jonahsaunders/fab-computer-hackerfab/daughterboards/micromanipulator/docs/schematics/README.txt

Current single-RP2350B schematic: page-1.png through page-7.png and the seven matching SVGs.
Page 1 contains only connectors and hierarchy. Page 7 is USB protection, CC termination and VBUS sensing.
The complete PDF is ../schematic-review.pdf.
