jonahsaunders/fab-computer-hackerfab/docs/provenance.md

# Source provenance

## Supplied inputs

The initial repository import was prepared on 2026-10-21 from:

- `Backplane.zip`: the `Backplane/HackerfabBackplane/` KiCad project.
- `LibraryHackerfab.zip`: custom symbols and footprint libraries under `LibraryHackerfab/`.
- *Hackerfab Progress Report 1 - FAB Computer.pdf*: background only, including Jonah Saunders' modular backplane/nanopositioner section and Jacob Rohozen's fab computer/sputtering section. The PDF is not redistributed in this repository.

The report describes early requirements and plans. The supplied KiCad files are the source for the repository's hardware inventory and validation baseline; the report's milestone statuses are not presented as current test results.

## 2026-11-10 layout update

Imported the supplied `HackerfabBackplane.kicad_pcb` with line endings normalized for Git. The layout moves L1/L2, D2/D4, C7/C14, and TP1–TP4 and revises copper in the two buck regulator sections. The saved copper fills are from the supplied board. The schematics, connector net assignments, and project rules match the preceding revision.

The board, plug-in assembly, and enclosure images were regenerated from the imported layout. See the [validation results](validation.md).

## 2026-11-05 source update

Imported ten active backplane files and 31 library files. Six active files differ from the preceding import: the PCB, project settings, root schematic, microcontroller schematic, `Hack_Connector.kicad_sym`, and `Hack_Passives.kicad_sym`.

The source adds four 0402 2.2 kΩ I²C pullups (R58–R61), replaces the four mounting holes with grounded `MountingHole_3.2mm_M3_Pad_Via` footprints, and changes J3:C19 from AUX10 to NC. The libraries add the mounting-hole symbol and 0402/0603 2.2 kΩ resistor symbols. The 24 custom footprints and custom rules are unchanged.

All 41 active design, library, and rule files match the supplied archives after line-ending normalization. Portable project library tables are retained. Copper fills, silkscreen, component metadata, circuitry, and routing are preserved as supplied. Nested Git history, backups, personal settings, and locks are omitted. Previews and the connector reference reflect the imported source.

| Input | SHA-256 |
| --- | --- |
| `Backplane.zip` | `2d32265ba806e5d6636d25c03d4a8b0cd8cbffeaa7c4cb9ce4a664522a3b36a8` |
| `LibraryHackerfab.zip` | `0b754c95f27298f834ec86778abce35e29a8b25181f3447bfe1e8e4ebcddac7e` |

## Previous 2026-11-04 source update

Imported ten active backplane files and 31 library files. Four active files differ from the preceding import: the PCB, project settings, root schematic, and microcontroller schematic. The source adds R56/R57 and J2's second UART on GPIO36/37. The library archive, all 24 custom footprints, and custom rules match the prior import.

All 41 active design, library, and rule files match the supplied archives after line-ending normalization. Portable project library tables are retained. Copper fills, silkscreen, component metadata, circuitry, and routing are preserved as supplied. The original archives are unchanged; nested Git history, backups, personal settings, and locks are omitted.

The design has 148 components/footprints, 1,114 trace segments, and 267 vias. KiCad reports 15 ERC findings, 24 DRC errors and 362 warnings, zero unconnected items, and zero schematic/PCB parity findings under the supplied rule settings. See [validation](validation.md).

| Input | SHA-256 |
| --- | --- |
| `Backplane.zip` | `cb59fc6ec95b371b803b05d918c9ad8e5f0ef8e0f59441e223abf39139629a5e` |
| `LibraryHackerfab.zip` | `f6dfa80bfdfb0d18f47f1acee41ef86ccdb3116fa3f484c1b2f465cdcedf7cc0` |

## Previous 2026-11-02 source update (RP2350B and supporting circuitry)

The supplied archives were imported into the existing locations: ten backplane design/rule files and 31 custom-library files. Seven active files differ from the preceding import after line-ending normalization: the PCB, project settings, microcontroller sheet, 12 V and 5 V buck-regulator sheets, `Hack_Chips.kicad_sym`, and `Hack_Passives.kicad_sym`.

The design changes U5 from RP2354B to RP2350B and adds C42 (4.7 µF, 16 V) and R55 (33 Ω). Both buck-regulator enable pins are now marked as no-connects in the supplied schematics. The chip library adds RP2350B; the passive library adds CL05A475MO5NUNC and RC0402JR-0733RP. The PCB updates placement, routing, and copper geometry. Project settings update the used-designator inventory. The other four schematic sheets, custom rules, five other symbol libraries, and all 24 custom footprints are unchanged.

All 41 active design/library/rule files match the supplied archives after line-ending normalization, including after validation and export. The repository retains its portable project library tables. No electrical, footprint, routing, or rule edits were made during import. Local history, nested Git databases, backups, personal settings, and locks are omitted.

The supplied board has 146 footprints, matching 146 schematic components, with 1,073 track segments and 263 vias. KiCad 10.0.6 reports 15 ERC findings (9 errors, 6 warnings), 350 DRC warnings with zero errors, zero unconnected items, and zero schematic/PCB parity findings. All 288 connector contacts still match V6 and the schematic netlist. The board image, seven schematic previews, and current documentation are refreshed; see [validation](validation.md) for the detailed comparison.

| Input | SHA-256 |
| --- | --- |
| `Backplane.zip` | `42994611f4c483442b37bc6466591b8f626c0dd15f32b7143f6bf670e60dd27b` |
| `LibraryHackerfab.zip` | `f6dfa80bfdfb0d18f47f1acee41ef86ccdb3116fa3f484c1b2f465cdcedf7cc0` |

## Previous 2026-11-02 source update (routing and vias)

The later supplied archives were imported into the existing locations: ten backplane design/rule files and 31 custom-library files. Only the PCB and project settings differ from the earlier November 2 import after line-ending normalization. The PCB updates routing, vias, copper geometry, and three silkscreen reference positions. The project changes its default pad connection from thermal relief on through-hole pads to thermal relief on all pads, and its default thermal gap from 0.40 mm to 0.20 mm. The seven schematics, custom rules, and all shared libraries are unchanged. The library ZIP is byte-for-byte identical to the previous library archive.

All 41 active design/library/rule files match the supplied archives after line-ending normalization, including after validation and export. The repository retains its portable project library tables. No circuit, footprint, routing, or rule edits were made during import. Local history, nested Git databases, backups, personal settings, and locks are omitted.

The supplied board has 1,062 track segments and 265 vias. KiCad 10.0.6 reports 16 ERC findings, 347 DRC warnings with zero errors, zero unconnected items, and zero schematic/PCB parity findings. The four dangling-via warnings and one silkscreen-overlap warning from the earlier November 2 import are no longer reported. All 288 connector contacts match V6 and the schematic netlist. The board image, seven schematic previews, and validation notes are refreshed. The earlier thermal-relief investigation is retained as a dated historical record.

| Input | SHA-256 |
| --- | --- |
| `Backplane.zip` | `803252028f3126698d68c80218893741e45e915588151332f2037253920d83d4` |
| `LibraryHackerfab.zip` | `22608c5caa803a6a3686a7baa2d7d8bc543e443ffc02595fb5ca283fdfc0c1fa` |

## Earlier 2026-11-02 source update (mounting holes and copper)

The supplied archives were imported into the existing locations: ten backplane design/rule files and 31 custom-library files. Only the PCB and project settings differ from the previous import after line-ending normalization. The PCB updates mounting-hole positions, copper geometry, and routing; the project changes its default pad connection to thermal relief for through-hole pads and its default thermal gap from 0.50 mm to 0.40 mm. The seven schematics, custom rules, and all shared libraries are unchanged. The library ZIP is byte-for-byte identical to the previous library archive.

All 41 active design/library/rule files match the supplied archives after line-ending normalization, including after validation and export. The repository retains its portable project library tables. No circuit, footprint, routing, or rule edits were made during import. Local history, nested Git databases, backups, personal settings, and locks are omitted.

The supplied board has 1,065 track segments and 248 vias. KiCad 10.0.6 reports 16 ERC findings, 352 DRC warnings with zero errors, zero unconnected items, and zero schematic/PCB parity findings. The previous 11 thermal-relief and four copper-edge-clearance errors are no longer reported. All 288 connector contacts match V6 and the schematic netlist. The board image, seven schematic previews, and validation notes are refreshed. The earlier thermal-relief investigation is retained as a dated historical record.

| Input | SHA-256 |
| --- | --- |
| `Backplane.zip` | `010dacdbf790cecba9f9229951a0e6a029dab3047fce349a967e0a4c266f812f` |
| `LibraryHackerfab.zip` | `22608c5caa803a6a3686a7baa2d7d8bc543e443ffc02595fb5ca283fdfc0c1fa` |

## Previous 2026-11-01 source update (mounting holes)

The latest supplied archives update the PCB and `MountingHole_3.2mm_M3_Grounded_Corner.kicad_mod`. The mounting-hole keepout now applies to F.Cu and B.Cu only, and the four board instances match the revised library footprint. Schematics, project settings, custom design rules, and other library files are unchanged after line-ending normalization. All 41 active design/library/rule files match the supplied archives after line-ending normalization; portable project library tables are retained.

The supplied board has 1,063 track segments and 248 vias. KiCad 10.0.6 reports 16 ERC findings, 368 DRC findings, zero unconnected items, and zero schematic/PCB parity findings. All 288 connector contacts match V6 and the schematic netlist. Previews and validation notes are refreshed. Local history, nested Git databases, backups, personal settings, and locks are omitted.

| Input | SHA-256 |
| --- | --- |
| `Backplane.zip` | `c4310f27035583245b53562eee915fbbe0ef82bcd50d26c63653c69d538759a9` |
| `LibraryHackerfab.zip` | `22608c5caa803a6a3686a7baa2d7d8bc543e443ffc02595fb5ca283fdfc0c1fa` |

The requested copper-pour investigation is documented in [thermal-relief findings](thermal-relief.md), including an illustration generated from the saved copper geometry. Temporary copies were used to test thermal-gap/spoke settings. Those experimental design changes are not included in the import.

## Previous 2026-11-01 source update (custom rules)

The later supplied archives were imported into the existing locations: ten backplane design files and 31 custom-library files. Compared with the earlier November 1 import, the PCB changes, the project adds net colors for `+1V1` and `+3V3`, and `HackerfabBackplane.kicad_dru` is new. The seven schematic sheets and all shared-library files are unchanged after line-ending normalization. All 41 active source files match the supplied archives after line-ending normalization; the repository retains its portable library tables. No circuit, footprint, routing, or custom-rule edits were made during import.

The board contains 1,052 track segments and 248 vias. All 288 connector pins still match V6 in the schematic and PCB. KiCad 10.0.6 reports 16 ERC findings, 376 DRC findings, four unconnected PCB items, and zero schematic/PCB parity findings. The supplied custom rules are included in this baseline, so the DRC totals are not a comparison under identical rules. See [validation](validation.md) for details. The board image and all seven schematic exports were refreshed.

| Input | SHA-256 |
| --- | --- |
| `Backplane.zip` | `d4eb044add0e31c59cb20894d9fb2f55f8f1f48e223b21bb211d692d945192b0` |
| `LibraryHackerfab.zip` | `db5c3d66d2a99bcd8b0e6b4c48f858e088cf05453cb7b19b771d245ed7039d63` |

The custom-rule header labels the supplied file as a JLCPCB 4-layer, 1 oz outer / 0.5 oz inner variant. Its references to a generator, capabilities file, and variants describe its original source; those supporting files were not included in the archives. The rule file is preserved as supplied, without independently certifying fabrication capabilities. Local history, nested Git databases, backups, personal settings, and editor locks are omitted.

## Earlier 2026-11-01 source update

The supplied archives were imported into the existing locations: nine backplane design files and 31 custom-library files. Only `HackerfabBackplane.kicad_pcb` differs from the October 30 import after line-ending normalization. The seven schematic sheets, project settings, and libraries are unchanged. All 40 active source files match the supplied archives after line-ending normalization; the repository retains its portable library tables. No circuit, footprint, or routing edits were made during import.

The PCB now contains 1,045 track segments and 248 vias. KiCad reports zero unconnected items and zero schematic/PCB parity findings. All 288 connector pins still match V6 in the schematic and PCB. The five previously documented GND-assigned AUX vias now carry their respective AUX nets. Refreshed previews and current ERC/DRC results accompany the import; see [validation](validation.md).

| Input | SHA-256 |
| --- | --- |
| `Backplane.zip` | `412bdff52870a83ee319ff3d8ce41d47b9beed17b7ab7627fabbfc21fc4bd579` |
| `LibraryHackerfab.zip` | `db5c3d66d2a99bcd8b0e6b4c48f858e088cf05453cb7b19b771d245ed7039d63` |

The backplane archive includes `.history/` and `.history_trim/` directories with nested Git databases. Both are omitted, along with backup files, personal settings, and editor locks.

## Previous 2026-10-30 source update

The corrected supplied archives were imported: nine backplane design files and 31 custom-library files. The root schematic and PCB implement the V6 pin order, with J1 nearest the MCU and UART only on J1. The libraries are unchanged from the October 29 archive. All 40 active source files match the archives after line-ending normalization; the repository retains its portable library tables. History, backups, personal settings, and lock files are omitted.

All 288 connector pad assignments were compared with V6 in the schematic and PCB. Updated schematic/board previews and current ERC/DRC results accompany the import; see [validation](validation.md). The PCB contains the author’s routing progress.

| Input | SHA-256 |
| --- | --- |
| `Backplane.zip` | `e90955123a6e66318d26df3ff379cbae10a63ccf3329a530b0bd17e33bcbb435` |
| `LibraryHackerfab.zip` | `db5c3d66d2a99bcd8b0e6b4c48f858e088cf05453cb7b19b771d245ed7039d63` |

## Previous 2026-10-29 source update

The supplied archives were imported into the existing repository locations: nine backplane design files and 31 library files (seven symbol libraries and 24 footprints). Compared with the previous import, the PCB, project, root schematic, and microcontroller sheet changed. The library update adds W25Q128JVSIQ flash-memory and DFE252012F-3R3M=P2 inductor symbols and their footprints, and revises the QFN-80 and Texas HSOP-8 footprints. The other active files match after line-ending normalization.

The repository's portable `fp-lib-table` and `sym-lib-table` were retained. The archive's footprint table still contains absolute desktop paths and an unused `Hack_Osicllators` entry. All 40 imported design and library files match the supplied active sources after line-ending normalization; no electrical or footprint changes were made during import. The supplied sources already contain the earlier fuse reference correction. Local history, backup files, personal settings, and editor lock files were omitted.

| Input | SHA-256 |
| --- | --- |
| `Backplane.zip` | `2831c1ed387e02acf5ddecc946eb71cafc70bb48188b46764c5f6404acc80a21` |
| `LibraryHackerfab.zip` | `db5c3d66d2a99bcd8b0e6b4c48f858e088cf05453cb7b19b771d245ed7039d63` |

All seven schematic previews and the board image were regenerated with KiCad 10.0.6. The design has 144 schematic components and 144 PCB footprints, with partial routing. See [validation](validation.md) for the current ERC/DRC results.

## Later 2026-10-26 source update

The latest supplied archives were imported into the same locations. The PCB, project, microcontroller sheet, 12 V and 5 V sheets, and passive symbol library changed. Other active source files match the previous import after line-ending normalization and the documented fuse reference correction. The portable library tables remain in place. The archives also contain local history, personal settings, and backup files, which are omitted as described below. The library archive contains another copy of the backplane; the dedicated backplane archive is the source for the project.

| Input | SHA-256 |
| --- | --- |
| `Backplane.zip` | `5d5989b9b181786cb4872330af4dc332807218ec35e0b4a389b25ffbf5ee654a` |
| `LibraryHackerfab.zip` | `67145490204cabcd166149f126d37eebc9a72dfa01b24410629074def56f428e` |

Previews and validation were regenerated with KiCad 10.0.6; see [validation](validation.md).

## Earlier 2026-10-26 source update

Replacement `Backplane.zip` and `LibraryHackerfab.zip` archives were supplied on 2026-10-26 and imported into the same repository locations. The update includes nine backplane design files (project, PCB, and seven schematic sheets) and 29 library files (seven symbol libraries and 22 footprints).

The root schematic and project now include `Protection.kicad_sch`; the libraries add protection components, connectors, and seven footprints. The PCB and the five pre-existing subsheets match the initial import after line-ending normalization.

The repository's portable `fp-lib-table` and `sym-lib-table` were retained. The replacement footprint table still contains absolute desktop paths and the unused `Hack_Osicllators` typo. The new fuse reference named an absent `Hack_Passives_Power` library, so it was corrected to `Hack_Passives:Fuse_Littelfuse-NANO2-451_453` in the library symbol and both cached/placed symbol properties in `Protection.kicad_sch`. The footprint itself was supplied in `Hack_Passives.pretty`. These reference corrections and line-ending normalization are the only changes to the imported design contents; circuit connections were preserved.

Schematic previews, the board image, and validation notes were refreshed with KiCad 10.0.6. The new schematic has 109 components, while the unchanged PCB has 93 footprints; see the [current validation results](validation.md).

## Import mapping

| Original location | Repository location |
| --- | --- |
| `Backplane/HackerfabBackplane/` | `hardware/backplane/` |
| `LibraryHackerfab/` | `hardware/libraries/` |

The initial 2026-10-21 import retained eight backplane design files (project, PCB, and six schematic sheets) and 22 library files (seven symbol libraries and 15 footprints). Source filenames, component identifiers, embedded models, and electrical connections were preserved. Git normalizes text line endings.

The original footprint table used absolute desktop paths. It was replaced with relative `${KIPRJMOD}/../libraries/` entries, and a matching project-local symbol table was added. An unused `Hack_Osicllators` typo entry was removed; references use the supplied `Hack_Oscillators` library.

## Omitted local state

- The backplane's `.history/` and `.history_trim/` directories, including their nested Git databases and save snapshots.
- The personal `.kicad_prl` settings file.
- Editor `.lck` files.
- Seven `.bak` library copies. Some differ from current library files; they remain available in the original archive rather than being treated as active source.

The original archives are unchanged. They are not committed as duplicate project copies. Generated schematic SVGs and the board PNG come directly from KiCad and can be refreshed using `scripts/export_design.py`.

## Archive fingerprints

SHA-256 identifies the exact supplied archives used for each import.

### Earlier update: 2026-10-26

| Input | SHA-256 |
| --- | --- |
| `Backplane.zip` | `cb402ce35c35c4ca89653b3e4fa78799b7c20a86cc4a859fcf68cb515b5bb651` |
| `LibraryHackerfab.zip` | `fae4f7f1eb39ee0c3e7f227d90205d20042f0cc822c55a51ffbe870fe86c5a20` |

### Initial import: 2026-10-21

| Input | SHA-256 |
| --- | --- |
| `Backplane.zip` | `98cf0ab542ad3de3d64e1f620149b67db82f9fa043ab19333f574d06d6231985` |
| `LibraryHackerfab.zip` | `9b7ce8772d420b50c1afcbc9ea5139d51ee581ea7fd56a7c9e4cf8f526473748` |
