jonahsaunders/fab-computer-hackerfab/daughterboards/micromanipulator/docs/connector-schematic.png

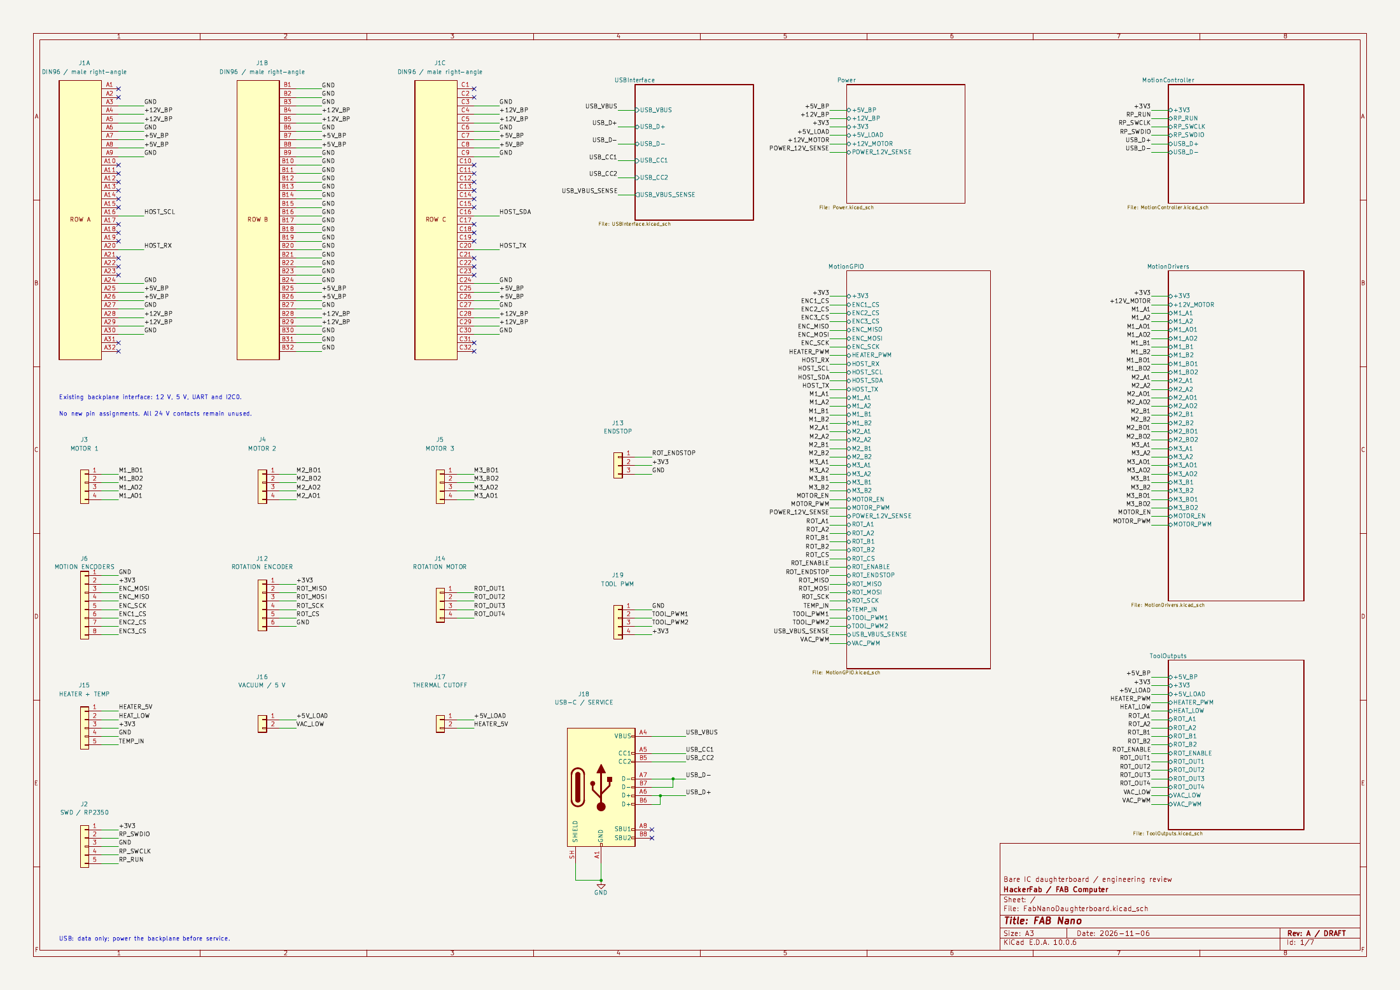
daughterboards/micromanipulator/docs/connector-schematic.png
