jonahsaunders/fab-computer-hackerfab/daughterboards/micromanipulator/docs/encoder-backplane-schematics/page-1.png

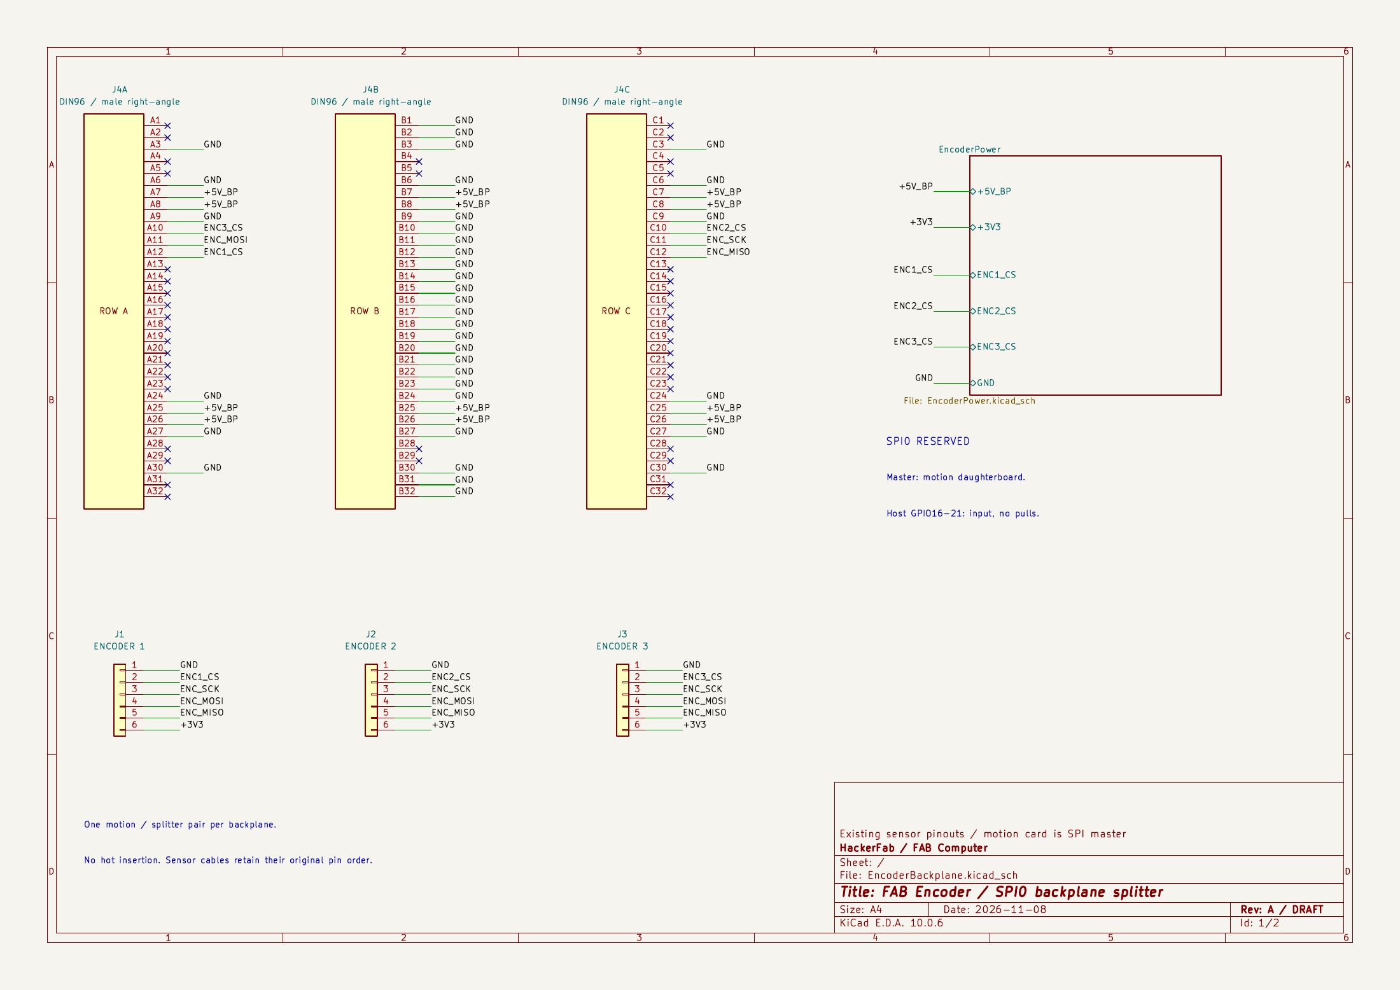
daughterboards/micromanipulator/docs/encoder-backplane-schematics/page-1.png
