jonahsaunders/fab-computer-hackerfab/daughterboards/micromanipulator/docs/encoder-backplane-schematics/page-2.png

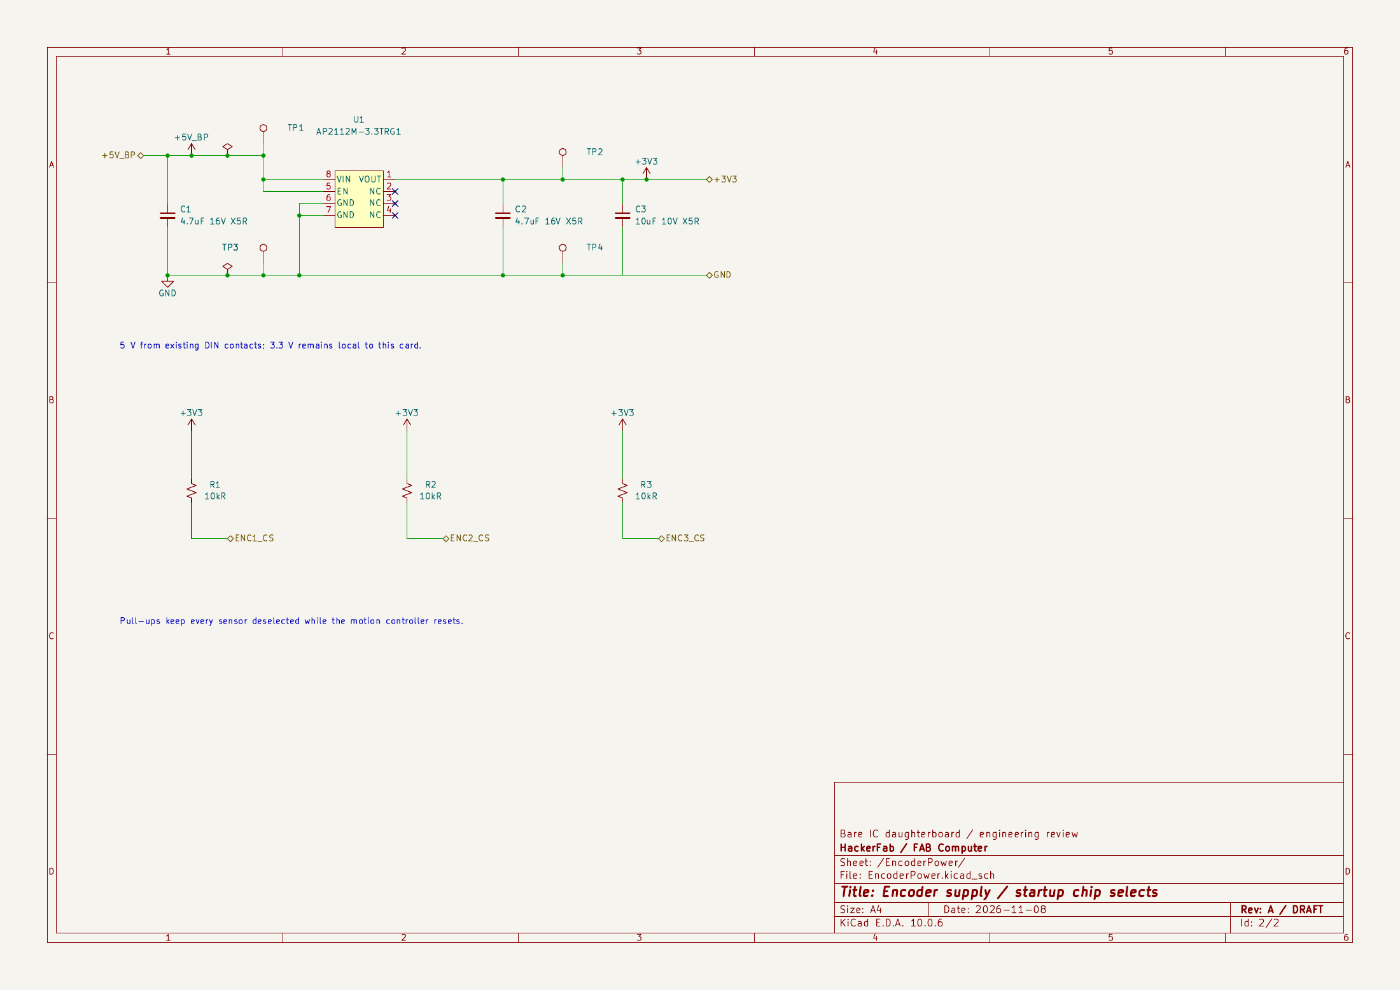
daughterboards/micromanipulator/docs/encoder-backplane-schematics/page-2.png
