jonahsaunders/fab-computer-hackerfab/daughterboards/micromanipulator/docs/encoder-splitter.png

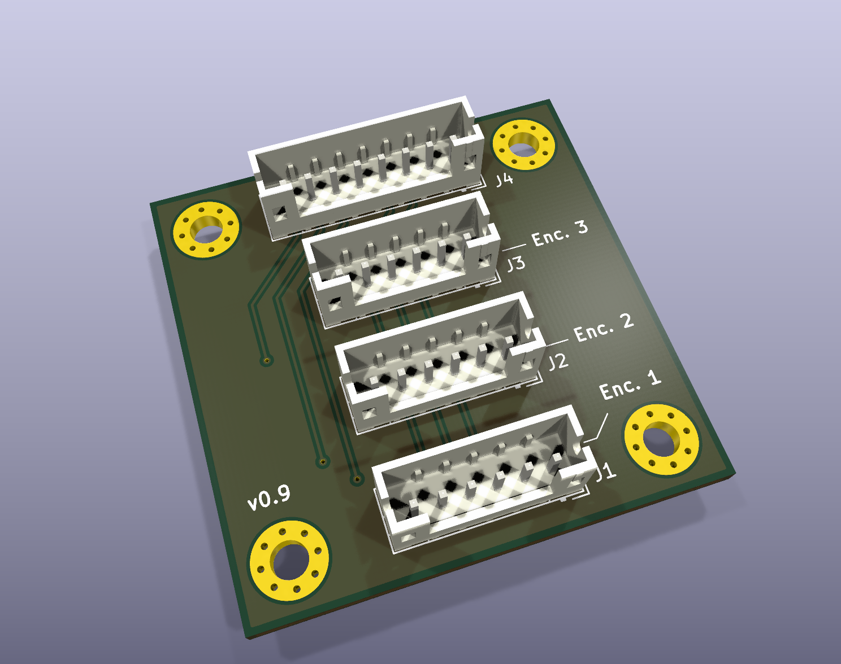
daughterboards/micromanipulator/docs/encoder-splitter.png
