jonahsaunders/fab-computer-hackerfab/daughterboards/micromanipulator/docs/layout-back-incomplete.png

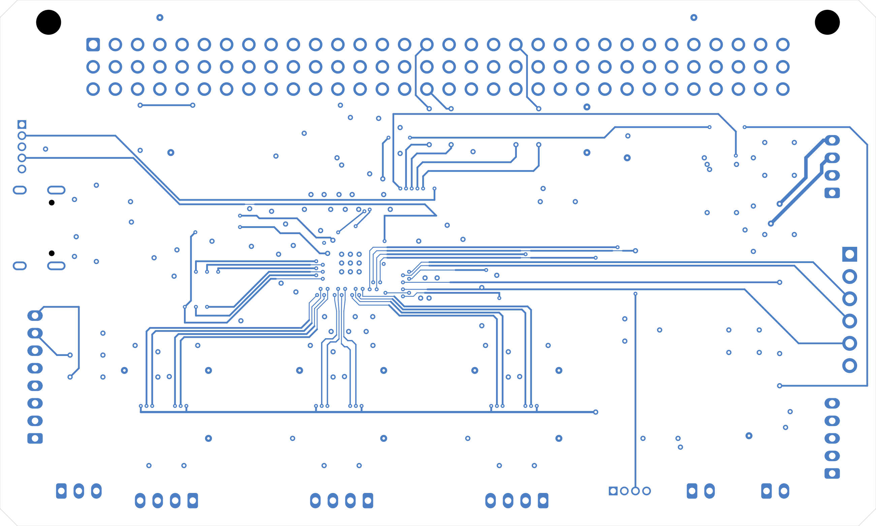
daughterboards/micromanipulator/docs/layout-back-incomplete.png
