jonahsaunders/fab-computer-hackerfab/daughterboards/micromanipulator/docs/layout-incomplete.png

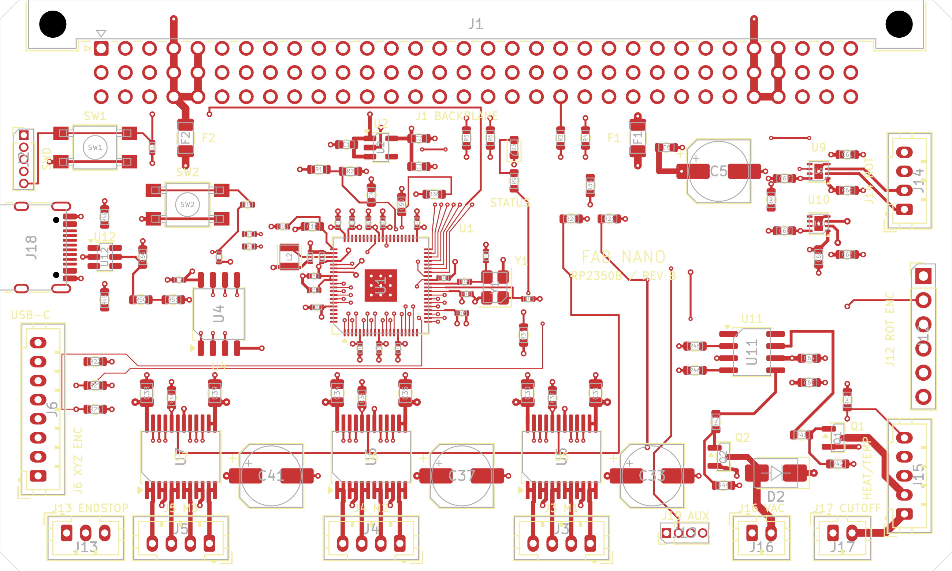
daughterboards/micromanipulator/docs/layout-incomplete.png
