jonahsaunders/fab-computer-hackerfab/daughterboards/micromanipulator/docs/schematics/page-1.png

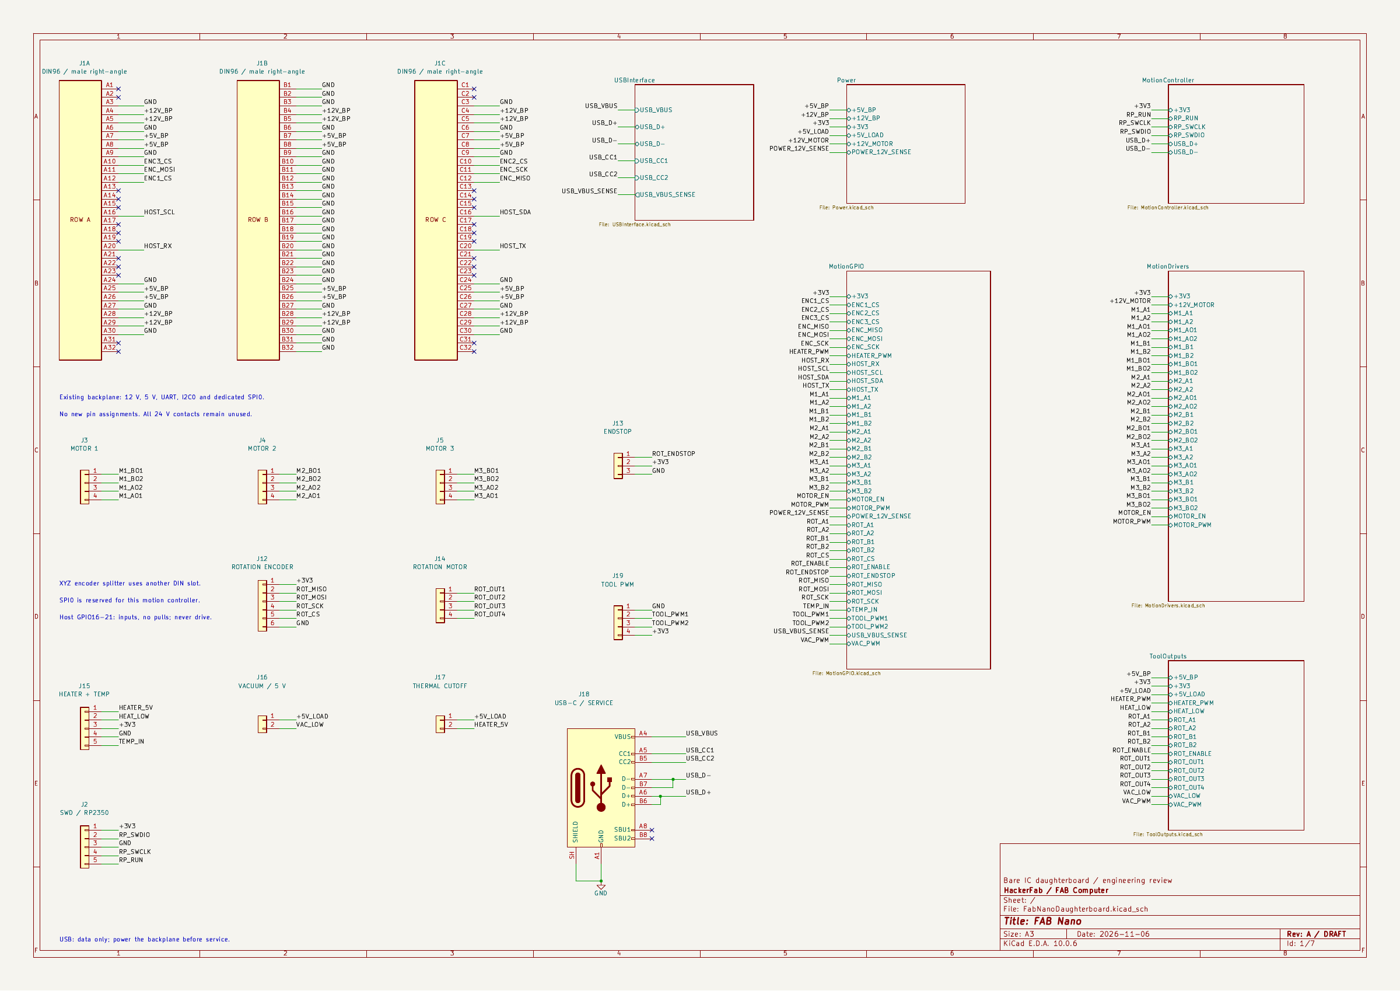
daughterboards/micromanipulator/docs/schematics/page-1.png
