jonahsaunders/fab-computer-hackerfab/daughterboards/micromanipulator/docs/schematics/page-2.png

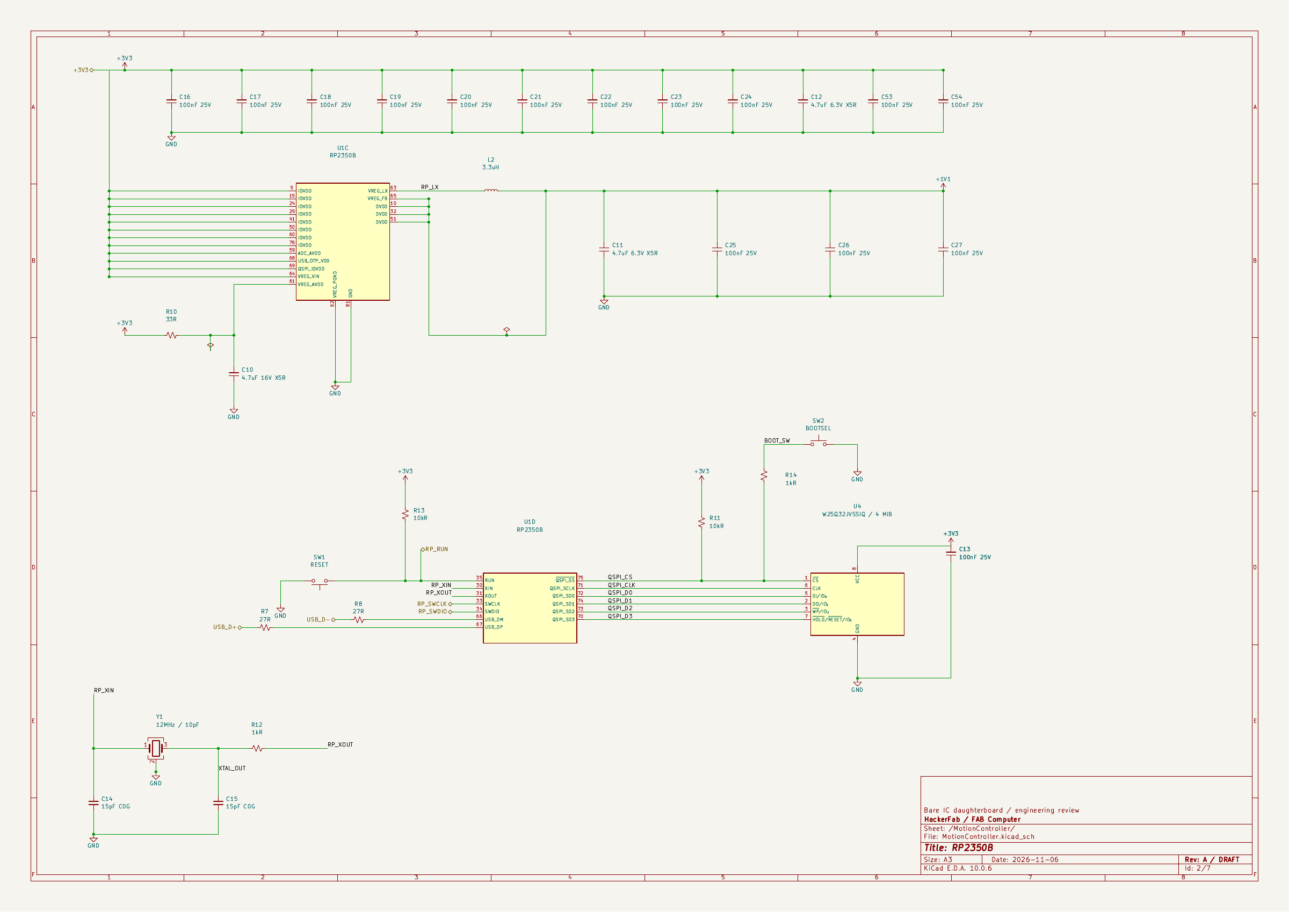
daughterboards/micromanipulator/docs/schematics/page-2.png
