jonahsaunders/fab-computer-hackerfab/daughterboards/micromanipulator/docs/schematics/page-3.png

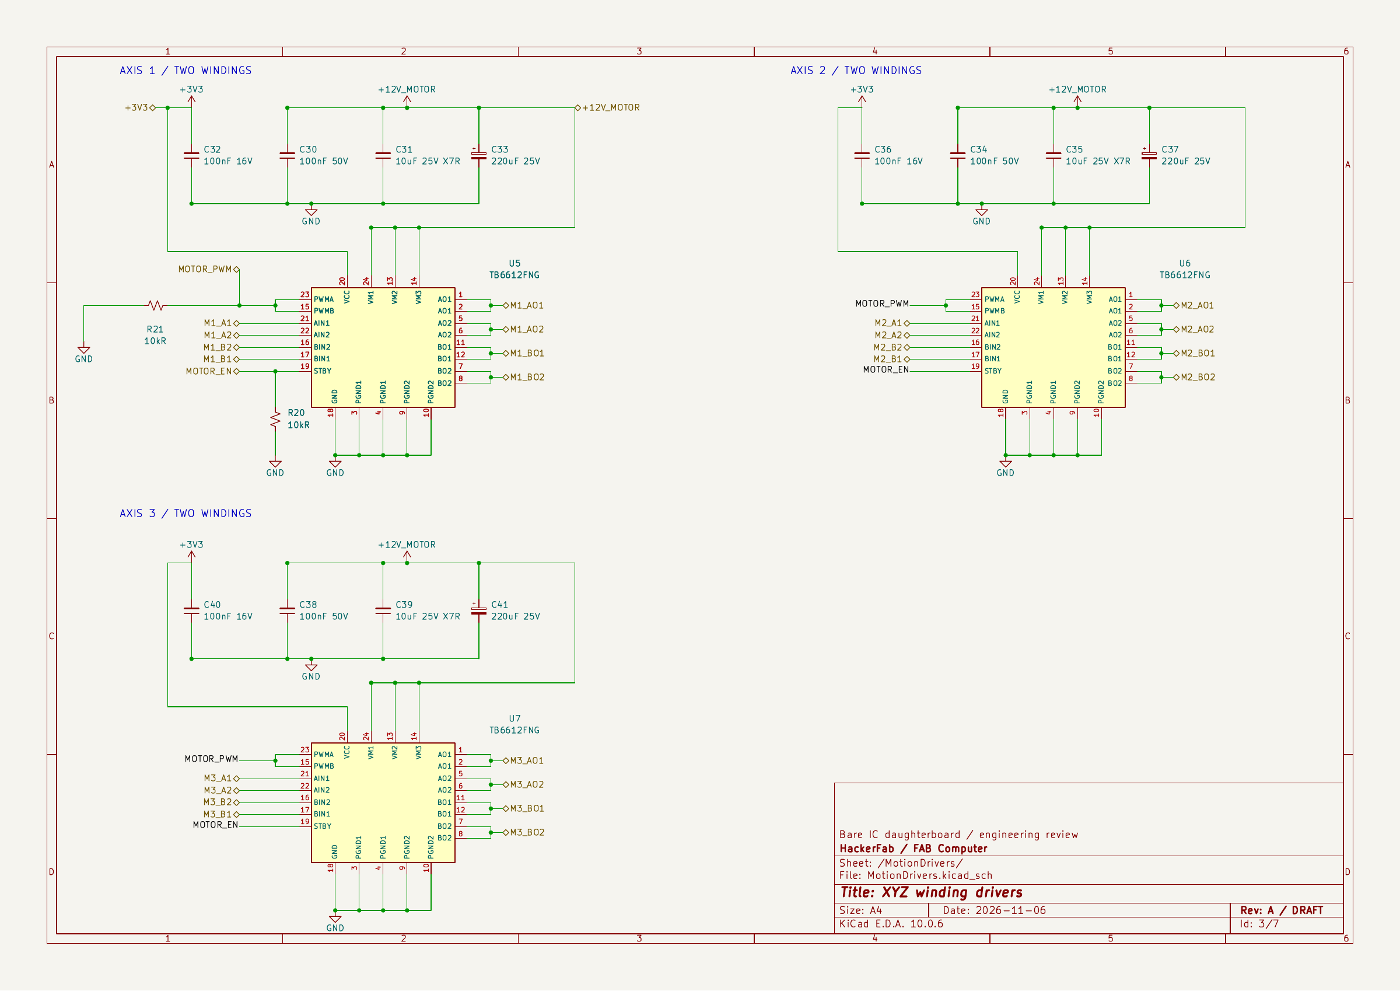
daughterboards/micromanipulator/docs/schematics/page-3.png
