jonahsaunders/fab-computer-hackerfab/daughterboards/micromanipulator/docs/schematics/page-4.png

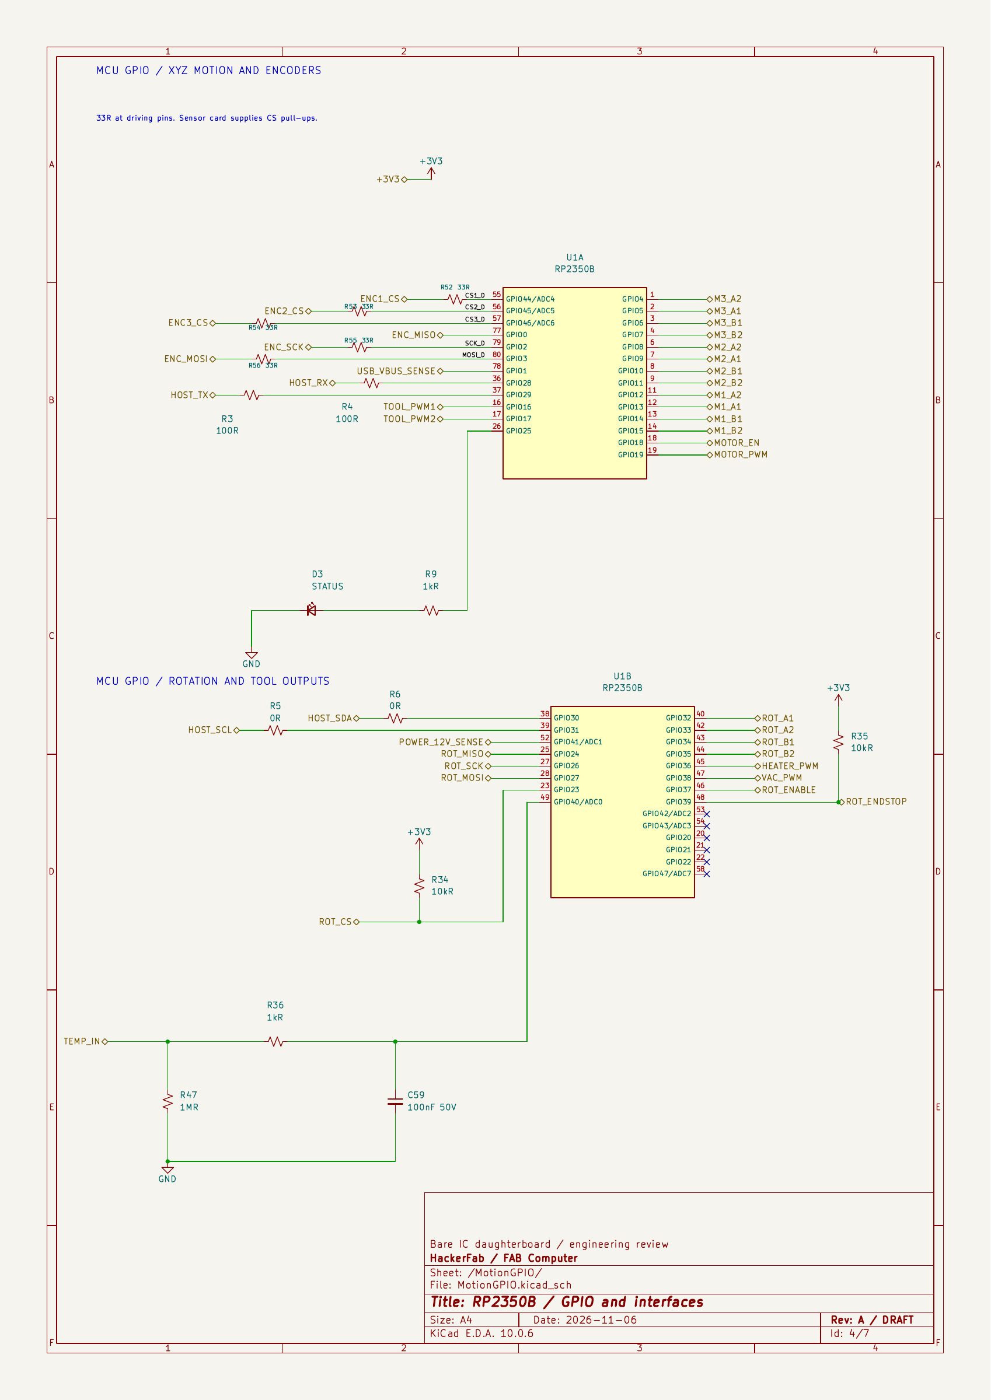
daughterboards/micromanipulator/docs/schematics/page-4.png
