jonahsaunders/fab-computer-hackerfab/daughterboards/micromanipulator/docs/schematics/page-5.png

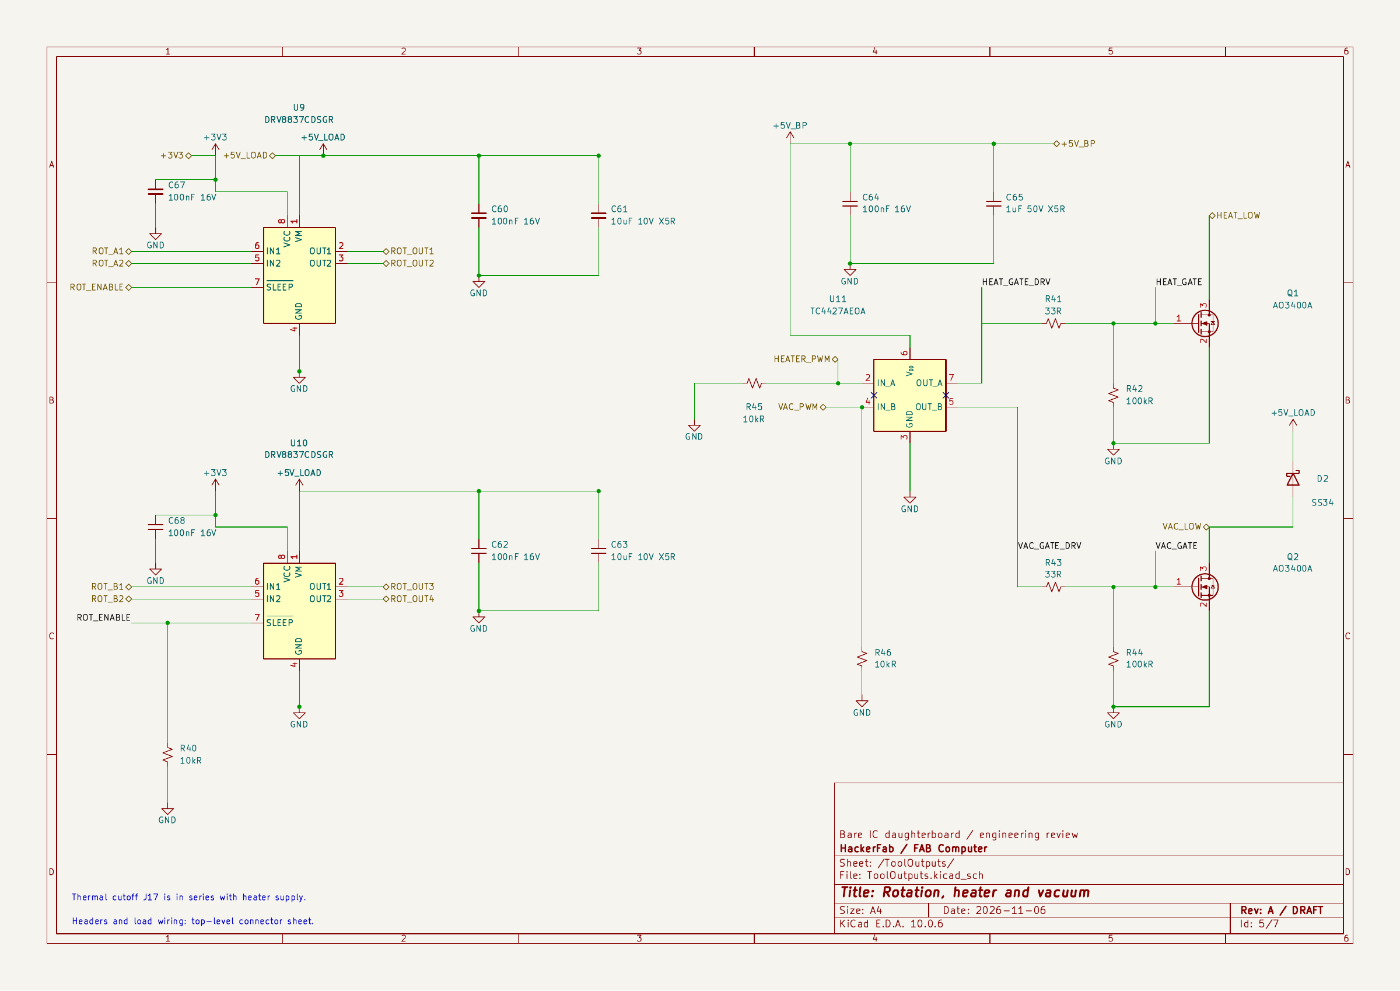
daughterboards/micromanipulator/docs/schematics/page-5.png
