jonahsaunders/fab-computer-hackerfab/daughterboards/micromanipulator/docs/schematics/page-6.png

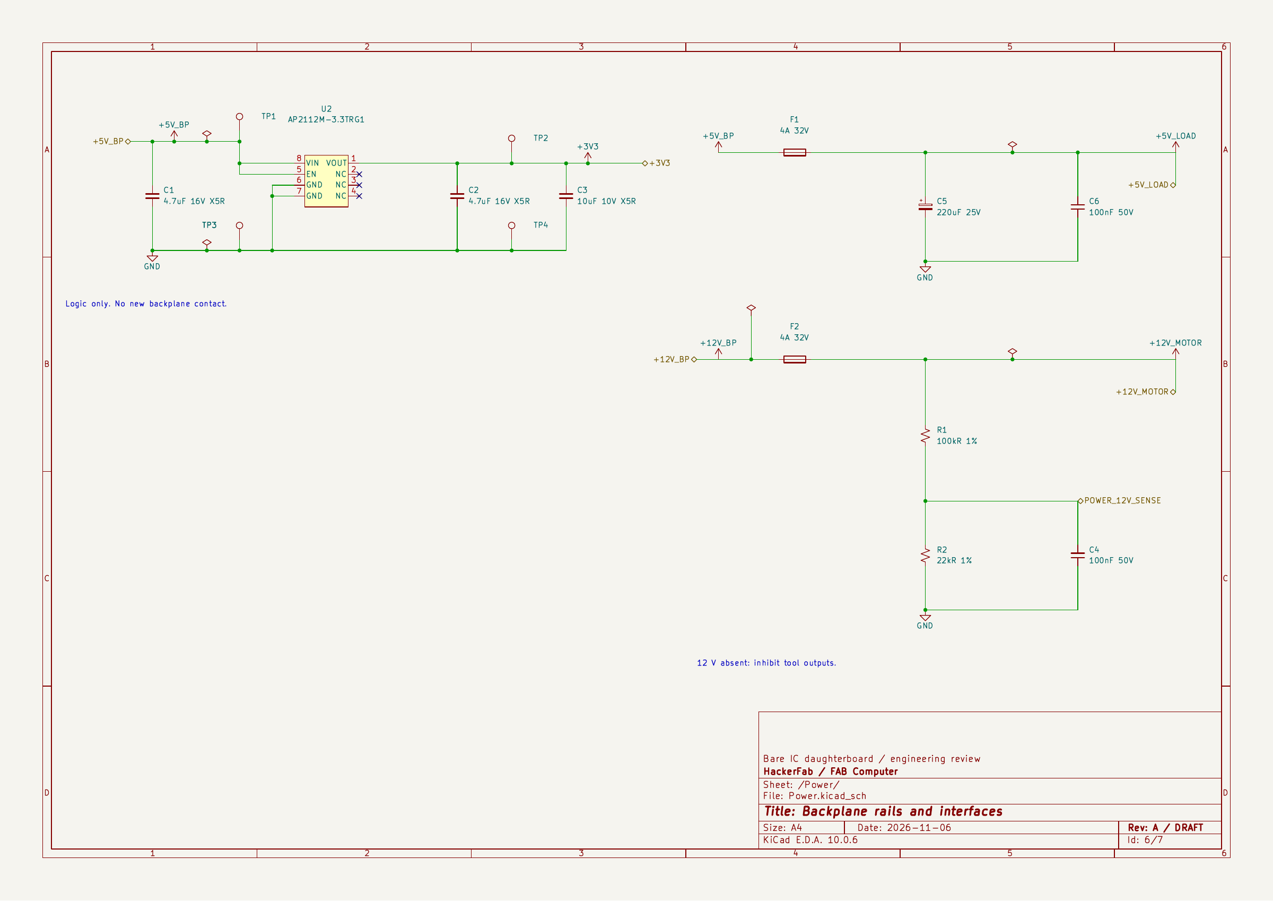
daughterboards/micromanipulator/docs/schematics/page-6.png
