jonahsaunders/fab-computer-hackerfab/daughterboards/micromanipulator/docs/schematics/page-7.png

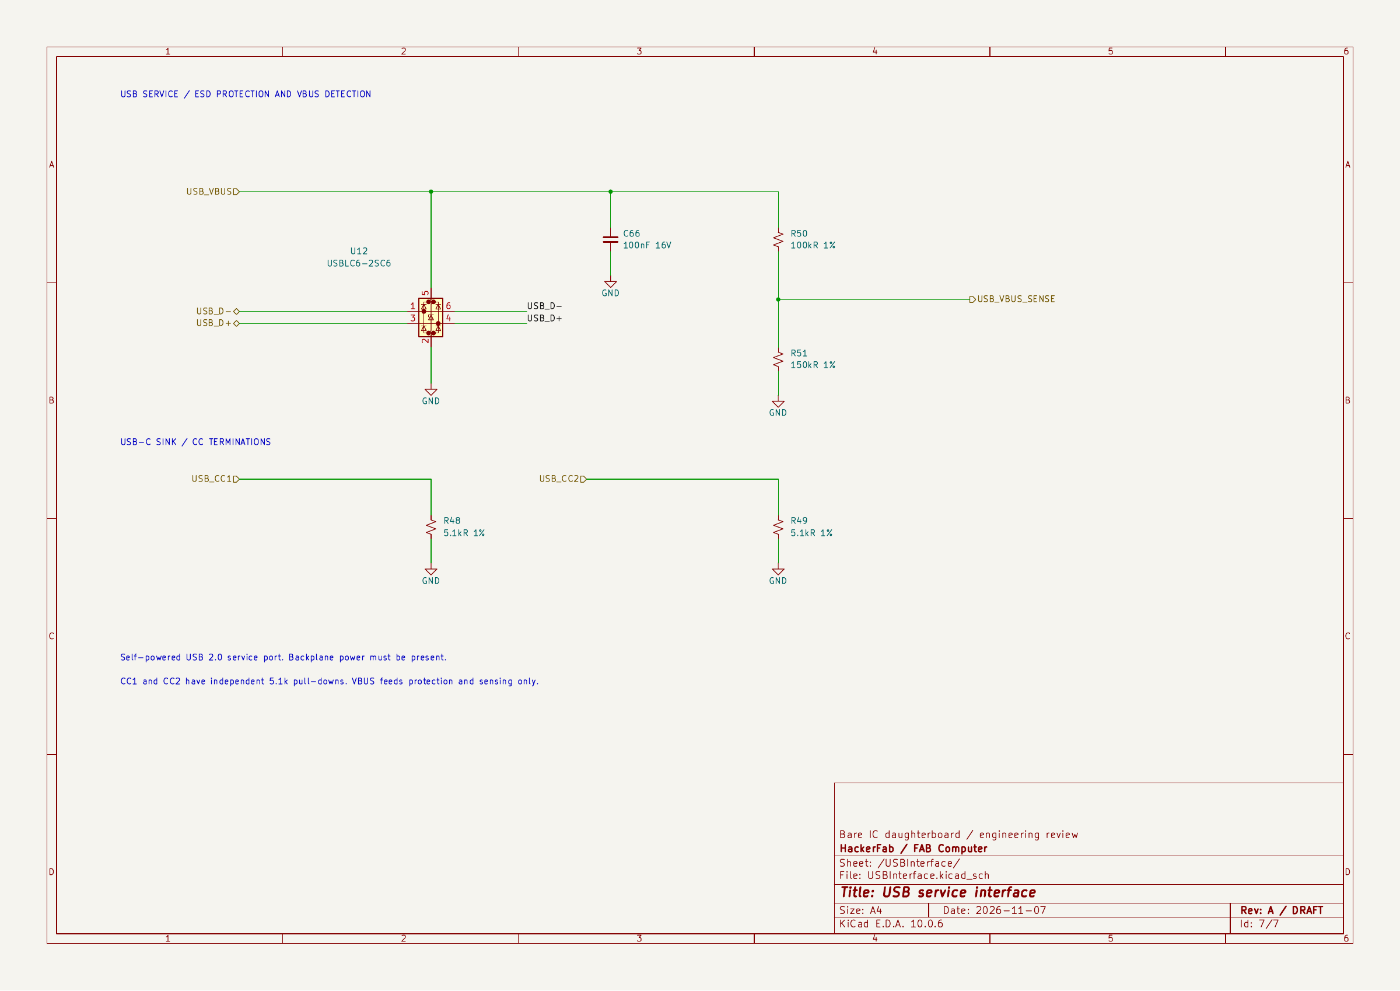
daughterboards/micromanipulator/docs/schematics/page-7.png
