jonahsaunders/fab-computer-hackerfab/daughterboards/micromanipulator/docs/usb-connector-3d.png

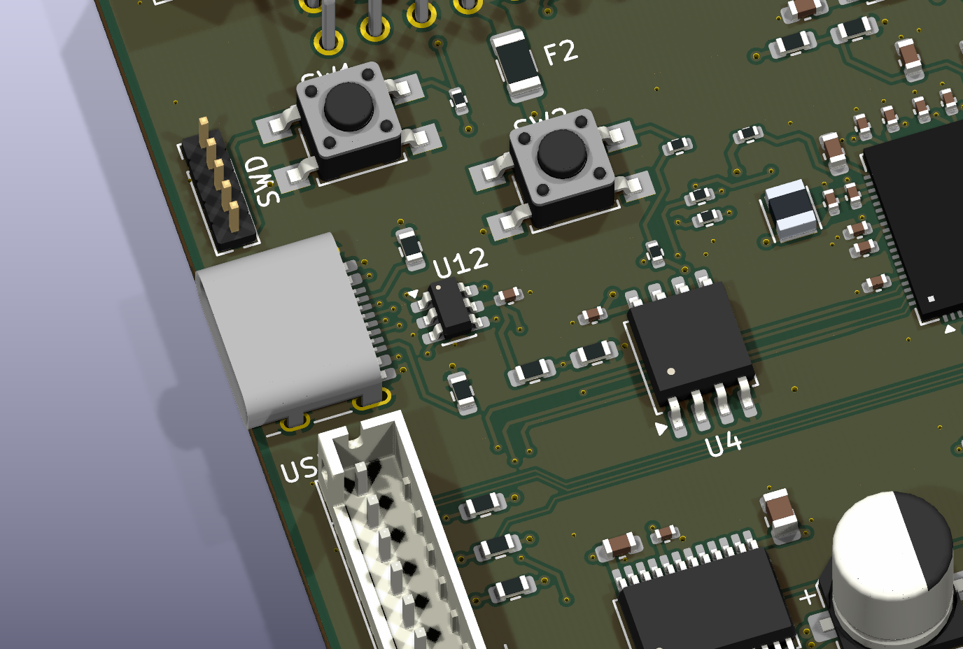
daughterboards/micromanipulator/docs/usb-connector-3d.png
