jonahsaunders/fab-computer-hackerfab/docs/images/backplane-2026-10-30.png

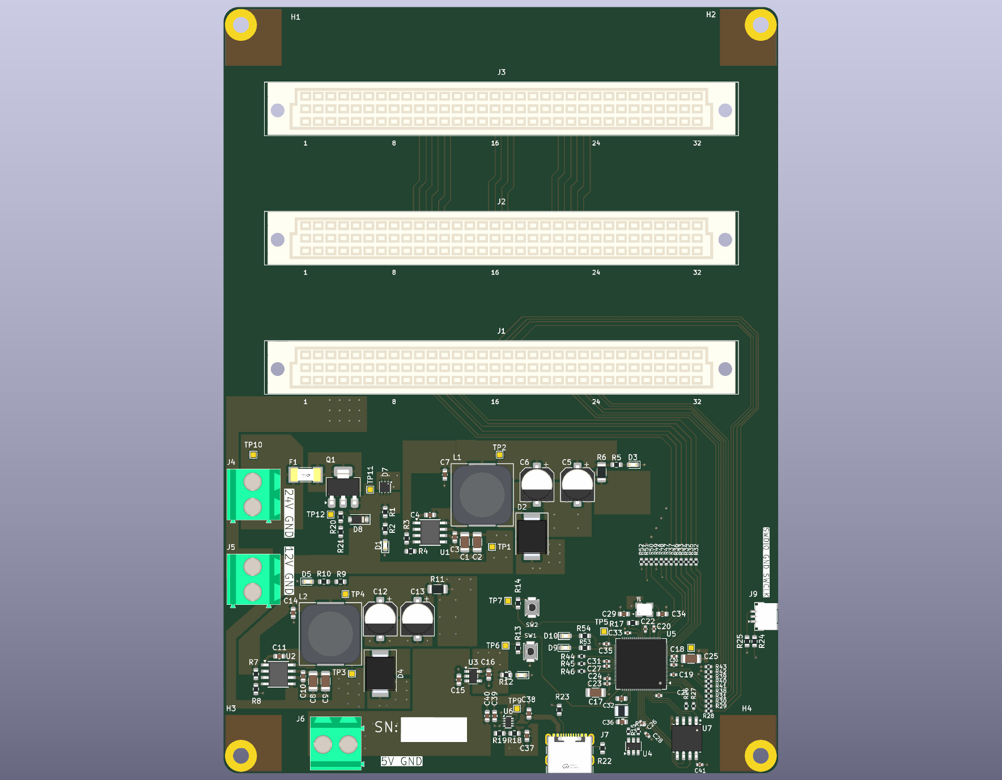
docs/images/backplane-2026-10-30.png
