jonahsaunders/fab-computer-hackerfab/docs/images/backplane-2026-11-01.png

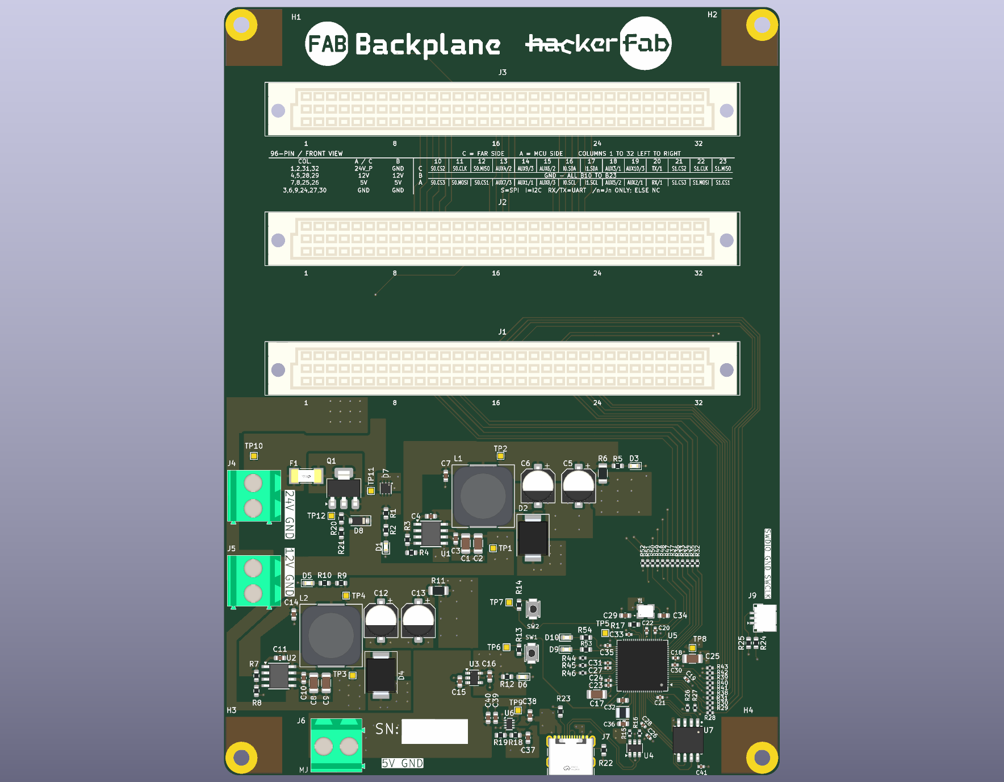
docs/images/backplane-2026-11-01.png
