jonahsaunders/fab-computer-hackerfab/docs/images/backplane-2026-11-05.png

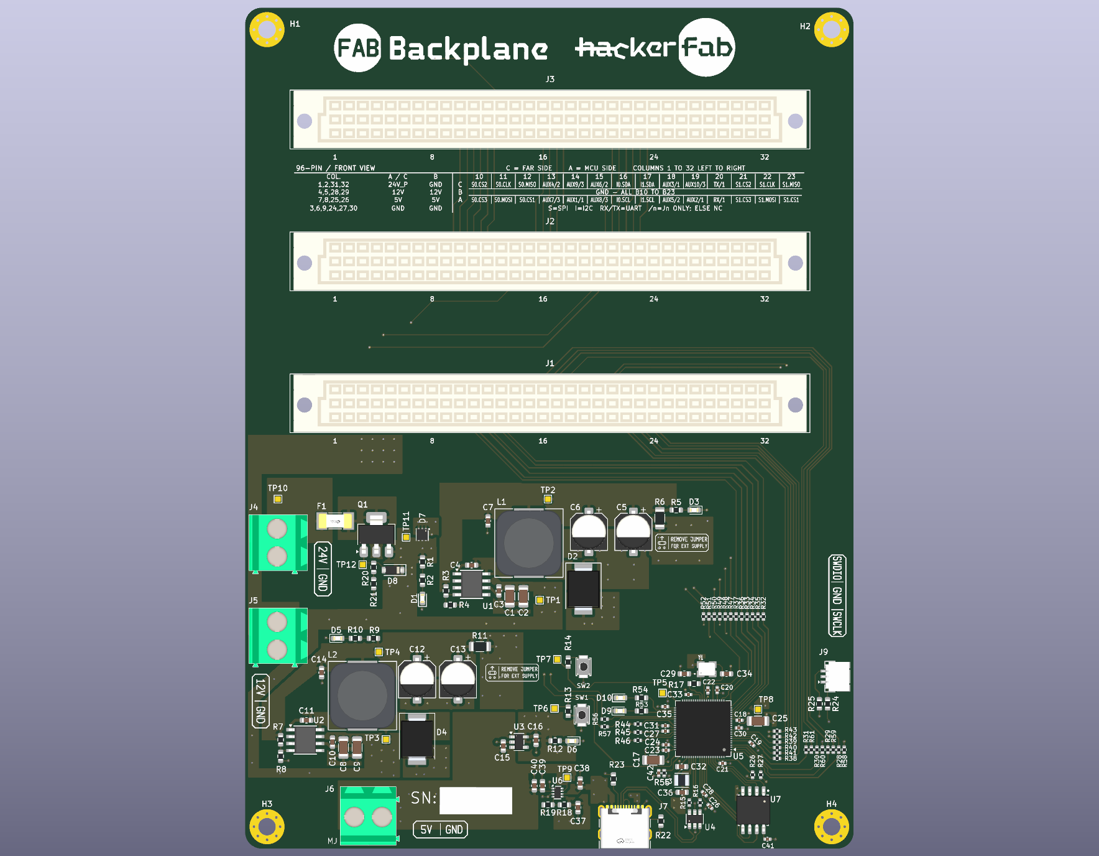
docs/images/backplane-2026-11-05.png
