jonahsaunders/fab-computer-hackerfab/docs/images/backplane-regulator.png

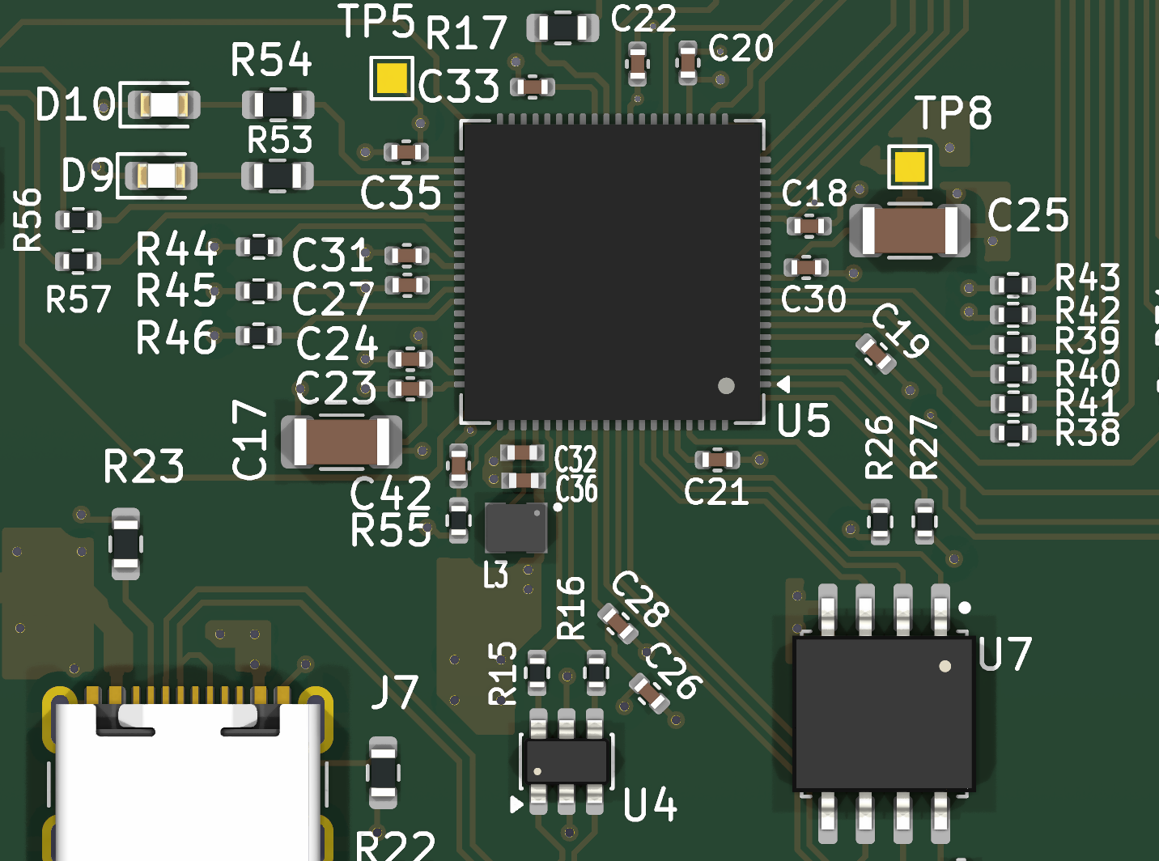
docs/images/backplane-regulator.png
