jonahsaunders/fab-computer-hackerfab/docs/images/connector-signal-plan.png

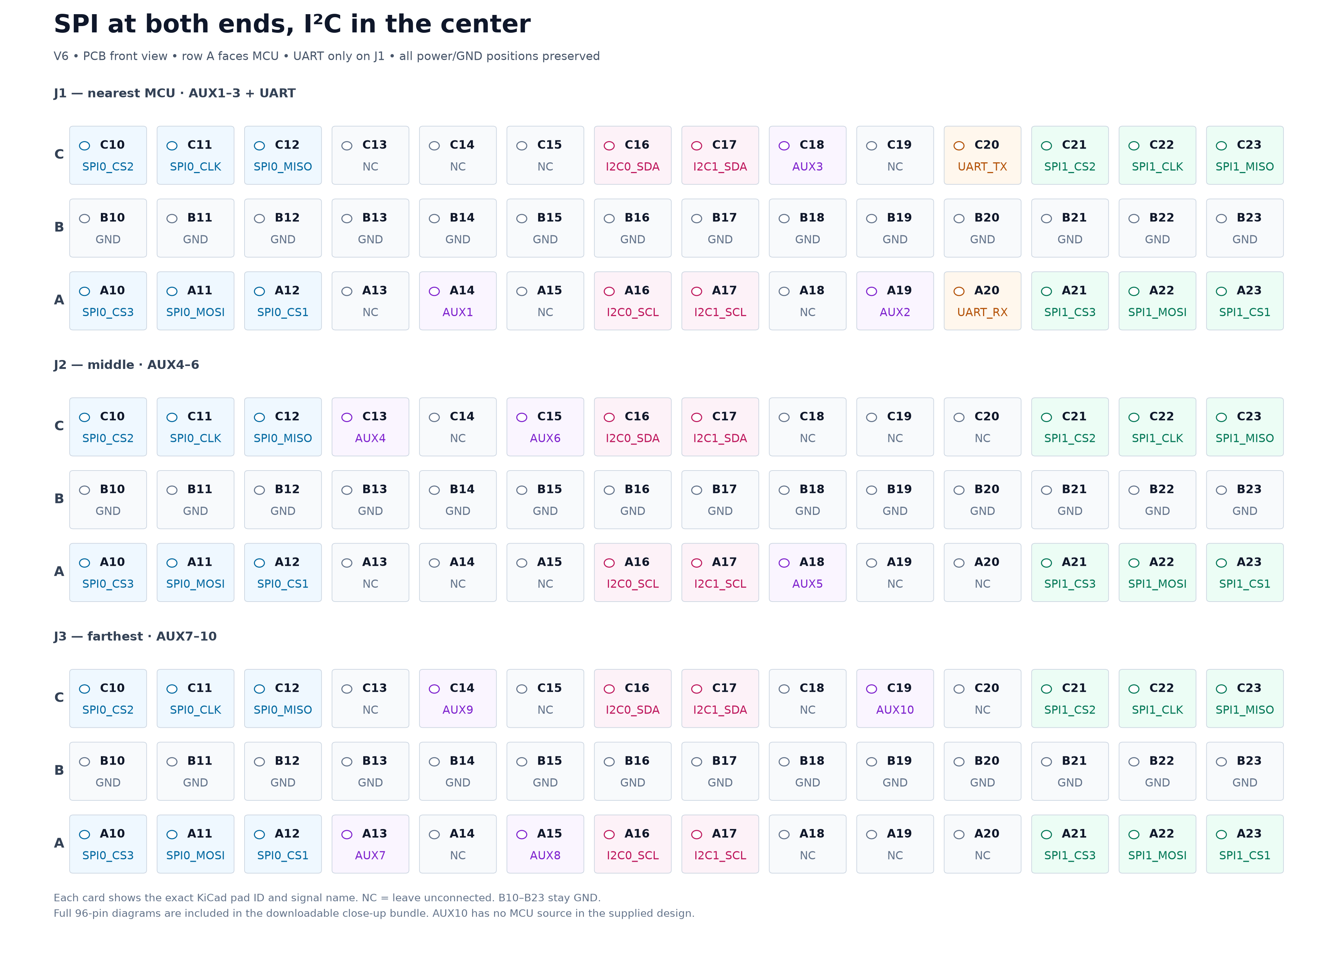
docs/images/connector-signal-plan.png
