jonahsaunders/fab-computer-hackerfab/daughterboards/micromanipulator/docs/bom.csv

Reference | Value | Footprint | Manufacturer part number | Manufacturer | LCSC | Quantity | Procurement status
J1 | DIN96 / male right-angle | FabNano:DIN96_Male_Horizontal | 9001-11961C00A | WingTAT | C5173361 | 1 | Manufacturer hole pattern and JLCPCB assembly catalog checked 2026-11-07; confirm order inventory
J2 | SWD / RP2350 | Connector_PinHeader_1.27mm:PinHeader_1x05_P1.27mm_Vertical | PH1.27-01-05PZD | XUNPU | C41360740 | 1 | Manufacturer hole pattern and JLCPCB assembly catalog checked 2026-11-07; confirm order inventory
J3 | MOTOR 1 | Connector_JST:JST_PH_B4B-PH-K_1x04_P2.00mm_Vertical | B4B-PH-K-S(LF)(SN) | JST | C131334 | 1 | Manufacturer hole pattern and JLCPCB assembly catalog checked 2026-11-07; confirm order inventory
J4 | MOTOR 2 | Connector_JST:JST_PH_B4B-PH-K_1x04_P2.00mm_Vertical | B4B-PH-K-S(LF)(SN) | JST | C131334 | 1 | Manufacturer hole pattern and JLCPCB assembly catalog checked 2026-11-07; confirm order inventory
J5 | MOTOR 3 | Connector_JST:JST_PH_B4B-PH-K_1x04_P2.00mm_Vertical | B4B-PH-K-S(LF)(SN) | JST | C131334 | 1 | Manufacturer hole pattern and JLCPCB assembly catalog checked 2026-11-07; confirm order inventory
J12 | ROTATION ENCODER | Connector_PinHeader_2.54mm:PinHeader_1x06_P2.54mm_Vertical | 2.54-1x6PStraight pin | BOOMELE | C37208 | 1 | Manufacturer hole pattern and JLCPCB assembly catalog checked 2026-11-07; confirm order inventory
J13 | ENDSTOP | Connector_JST:JST_PH_B3B-PH-K_1x03_P2.00mm_Vertical | B3B-PH-K-S(LF)(SN) | JST | C131339 | 1 | Manufacturer hole pattern and JLCPCB assembly catalog checked 2026-11-07; confirm order inventory
J14 | ROTATION MOTOR | Connector_JST:JST_PH_B4B-PH-K_1x04_P2.00mm_Vertical | B4B-PH-K-S(LF)(SN) | JST | C131334 | 1 | Manufacturer hole pattern and JLCPCB assembly catalog checked 2026-11-07; confirm order inventory
J15 | HEATER + TEMP | Connector_JST:JST_PH_B5B-PH-K_1x05_P2.00mm_Vertical | B5B-PH-K-S(LF)(SN) | JST | C157993 | 1 | Manufacturer hole pattern and JLCPCB assembly catalog checked 2026-11-07; confirm order inventory
J16 | VACUUM / 5 V | Connector_JST:JST_PH_B2B-PH-K_1x02_P2.00mm_Vertical | B2B-PH-K-S(LF)(SN) | JST | C131337 | 1 | Manufacturer hole pattern and JLCPCB assembly catalog checked 2026-11-07; confirm order inventory
J17 | THERMAL CUTOFF | Connector_JST:JST_PH_B2B-PH-K_1x02_P2.00mm_Vertical | B2B-PH-K-S(LF)(SN) | JST | C131337 | 1 | Manufacturer hole pattern and JLCPCB assembly catalog checked 2026-11-07; confirm order inventory
J18 | USB-C / SERVICE | Connector_USB:USB_C_Receptacle_HRO_TYPE-C-31-M-12 | TYPE-C-31-M-12 | HRO | C165948 | 1 | Exact part, package/model and JLCPCB catalog checked 2026-11-07; confirm inventory
J19 | TOOL PWM | Connector_PinHeader_1.27mm:PinHeader_1x04_P1.27mm_Vertical | PH1.27-01-04PZD | XUNPU | C41360739 | 1 | Manufacturer hole pattern and JLCPCB assembly catalog checked 2026-11-07; confirm order inventory
C10 | 4.7uF 16V X5R | Capacitor_SMD:C_0603_1608Metric | CL10A475KO8NNNC | Samsung Electro-Mechanics | C19666 | 1 | Samsung bias data and JLCPCB catalog/package checked 2026-11-07; confirm order inventory
C11 | 4.7uF 6.3V X5R | FabNano:C_0402_RP2350_Regulator | GRM155R60J475ME47D | Murata | C82453 | 1 | Exact existing part and JLCPCB code checked 2026-11-07; confirm inventory
C12 | 4.7uF 6.3V X5R | FabNano:C_0402_RP2350_Regulator | GRM155R60J475ME47D | Murata | C82453 | 1 | Exact existing part and JLCPCB code checked 2026-11-07; confirm inventory
C13 | 100nF 25V | Capacitor_SMD:C_0402_1005Metric | CL05B104KA5NNNC | Samsung Electro-Mechanics | C155422 | 1 | Manufacturer dimensions/ratings and JLCPCB catalog checked 2026-11-07; confirm order inventory
C14 | 15pF C0G | Capacitor_SMD:C_0402_1005Metric | 0402CG150J500NT | Guangdong Fenghua Advanced Technology | C1548 | 1 | Manufacturer dimensions/ratings and JLCPCB catalog checked 2026-11-07; confirm order inventory
C15 | 15pF C0G | Capacitor_SMD:C_0402_1005Metric | 0402CG150J500NT | Guangdong Fenghua Advanced Technology | C1548 | 1 | Manufacturer dimensions/ratings and JLCPCB catalog checked 2026-11-07; confirm order inventory
C16 | 100nF 25V | Capacitor_SMD:C_0402_1005Metric | CL05B104KA5NNNC | Samsung Electro-Mechanics | C155422 | 1 | Manufacturer dimensions/ratings and JLCPCB catalog checked 2026-11-07; confirm order inventory
C17 | 100nF 25V | Capacitor_SMD:C_0402_1005Metric | CL05B104KA5NNNC | Samsung Electro-Mechanics | C155422 | 1 | Manufacturer dimensions/ratings and JLCPCB catalog checked 2026-11-07; confirm order inventory
C18 | 100nF 25V | Capacitor_SMD:C_0402_1005Metric | CL05B104KA5NNNC | Samsung Electro-Mechanics | C155422 | 1 | Manufacturer dimensions/ratings and JLCPCB catalog checked 2026-11-07; confirm order inventory
C19 | 100nF 25V | Capacitor_SMD:C_0402_1005Metric | CL05B104KA5NNNC | Samsung Electro-Mechanics | C155422 | 1 | Manufacturer dimensions/ratings and JLCPCB catalog checked 2026-11-07; confirm order inventory
C20 | 100nF 25V | Capacitor_SMD:C_0402_1005Metric | CL05B104KA5NNNC | Samsung Electro-Mechanics | C155422 | 1 | Manufacturer dimensions/ratings and JLCPCB catalog checked 2026-11-07; confirm order inventory
C21 | 100nF 25V | Capacitor_SMD:C_0402_1005Metric | CL05B104KA5NNNC | Samsung Electro-Mechanics | C155422 | 1 | Manufacturer dimensions/ratings and JLCPCB catalog checked 2026-11-07; confirm order inventory
C22 | 100nF 25V | Capacitor_SMD:C_0402_1005Metric | CL05B104KA5NNNC | Samsung Electro-Mechanics | C155422 | 1 | Manufacturer dimensions/ratings and JLCPCB catalog checked 2026-11-07; confirm order inventory
C23 | 100nF 25V | Capacitor_SMD:C_0402_1005Metric | CL05B104KA5NNNC | Samsung Electro-Mechanics | C155422 | 1 | Manufacturer dimensions/ratings and JLCPCB catalog checked 2026-11-07; confirm order inventory
C24 | 100nF 25V | Capacitor_SMD:C_0402_1005Metric | CL05B104KA5NNNC | Samsung Electro-Mechanics | C155422 | 1 | Manufacturer dimensions/ratings and JLCPCB catalog checked 2026-11-07; confirm order inventory
C25 | 100nF 25V | Capacitor_SMD:C_0402_1005Metric | CL05B104KA5NNNC | Samsung Electro-Mechanics | C155422 | 1 | Manufacturer dimensions/ratings and JLCPCB catalog checked 2026-11-07; confirm order inventory
C26 | 100nF 25V | Capacitor_SMD:C_0402_1005Metric | CL05B104KA5NNNC | Samsung Electro-Mechanics | C155422 | 1 | Manufacturer dimensions/ratings and JLCPCB catalog checked 2026-11-07; confirm order inventory
C27 | 100nF 25V | Capacitor_SMD:C_0402_1005Metric | CL05B104KA5NNNC | Samsung Electro-Mechanics | C155422 | 1 | Manufacturer dimensions/ratings and JLCPCB catalog checked 2026-11-07; confirm order inventory
C53 | 100nF 25V | Capacitor_SMD:C_0402_1005Metric | CL05B104KA5NNNC | Samsung Electro-Mechanics | C155422 | 1 | Manufacturer dimensions/ratings and JLCPCB catalog checked 2026-11-07; confirm order inventory
C54 | 100nF 25V | Capacitor_SMD:C_0402_1005Metric | CL05B104KA5NNNC | Samsung Electro-Mechanics | C155422 | 1 | Manufacturer dimensions/ratings and JLCPCB catalog checked 2026-11-07; confirm order inventory
L2 | 3.3uH | Hack_Passives:L_Murata_DFE252012F_2.5x2.0mm | DFE252012F-3R3M=P2 | Murata | C2041573 | 1 | Manufacturer dimensions/ratings and JLCPCB catalog checked 2026-11-07; confirm order inventory
R7 | 27R | FabNano:R_0201_Yageo_Reflow | RC0201FR-0727RL | YAGEO | C273268 | 1 | JLCPCB Standard assembly catalog and manufacturer land pattern checked 2026-11-07; confirm order inventory
R8 | 27R | FabNano:R_0201_Yageo_Reflow | RC0201FR-0727RL | YAGEO | C273268 | 1 | JLCPCB Standard assembly catalog and manufacturer land pattern checked 2026-11-07; confirm order inventory
R10 | 33R | Resistor_SMD:R_0402_1005Metric | 0402WGF330JTCE | Uniroyal Electronics | C25105 | 1 | Manufacturer dimensions/ratings and JLCPCB catalog checked 2026-11-07; confirm order inventory
R11 | 10kR | Resistor_SMD:R_0402_1005Metric | 0402WGF1002TCE | Uniroyal Electronics | C25744 | 1 | Manufacturer dimensions/ratings and JLCPCB catalog checked 2026-11-07; confirm order inventory
R12 | 1kR | Resistor_SMD:R_0402_1005Metric | 0402WGF1001TCE | Uniroyal Electronics | C11702 | 1 | Manufacturer dimensions/ratings and JLCPCB catalog checked 2026-11-07; confirm order inventory
R13 | 10kR | Resistor_SMD:R_0402_1005Metric | 0402WGF1002TCE | Uniroyal Electronics | C25744 | 1 | Manufacturer dimensions/ratings and JLCPCB catalog checked 2026-11-07; confirm order inventory
R14 | 1kR | Resistor_SMD:R_0402_1005Metric | 0402WGF1001TCE | Uniroyal Electronics | C11702 | 1 | Manufacturer dimensions/ratings and JLCPCB catalog checked 2026-11-07; confirm order inventory
SW1 | RESET | Button_Switch_SMD:SW_SPST_TL3305A | TL3305AF160QG | E-Switch | C2886899 | 1 | Manufacturer dimensions/ratings and JLCPCB catalog checked 2026-11-07; confirm order inventory
SW2 | BOOTSEL | Button_Switch_SMD:SW_SPST_TL3305A | TL3305AF160QG | E-Switch | C2886899 | 1 | Manufacturer dimensions/ratings and JLCPCB catalog checked 2026-11-07; confirm order inventory
U1 | RP2350B | Package_DFN_QFN:QFN-80-1EP_10x10mm_P0.4mm_EP3.4x3.4mm | RP2350B A4 | Raspberry Pi | C9900208890 | 1 | A4 stepping required; JLCPCB assembly catalog checked 2026-11-07; stock not confirmed
U4 | W25Q128JVSIQ / 16 MiB | Package_SO:SOIC-8_5.3x5.3mm_P1.27mm | W25Q128JVSIQ | Winbond Electronics | C97521 | 1 | Manufacturer dimensions and JLCPCB catalog checked 2026-11-12
Y1 | 12MHz / 10pF | Crystal:Crystal_SMD_3225-4Pin_3.2x2.5mm | ABM8-272-T3 | Abracon | C20625731 | 1 | Manufacturer dimensions/ratings and JLCPCB catalog checked 2026-11-07; confirm order inventory
C30 | 100nF 50V | Capacitor_SMD:C_0603_1608Metric | CC0603KRX7R9BB104 | YAGEO | C14663 | 1 | JLCPCB catalog/package checked 2026-11-07; confirm current inventory
C31 | 10uF 25V X7R | Capacitor_SMD:C_0805_2012Metric | C0805X7R106K250NT | SANYEAR | C2835529 | 1 | Manufacturer dimensions/ratings and JLCPCB catalog checked 2026-11-07; confirm order inventory
C32 | 100nF 16V | Capacitor_SMD:C_0402_1005Metric | CL05B104KO5NNNC | Samsung Electro-Mechanics | C1525 | 1 | JLCPCB catalog/package checked 2026-11-07; confirm current inventory
C33 | 220uF 25V | Capacitor_SMD:CP_Elec_6.3x7.7 | 217EC0037 | KNSCHA | C42371908 | 1 | Manufacturer drawing and LCSC SMT catalog checked 2026-11-07; confirm JLCPCB order availability
C34 | 100nF 50V | Capacitor_SMD:C_0603_1608Metric | CC0603KRX7R9BB104 | YAGEO | C14663 | 1 | JLCPCB catalog/package checked 2026-11-07; confirm current inventory
C35 | 10uF 25V X7R | Capacitor_SMD:C_0805_2012Metric | C0805X7R106K250NT | SANYEAR | C2835529 | 1 | Manufacturer dimensions/ratings and JLCPCB catalog checked 2026-11-07; confirm order inventory
C36 | 100nF 16V | Capacitor_SMD:C_0402_1005Metric | CL05B104KO5NNNC | Samsung Electro-Mechanics | C1525 | 1 | JLCPCB catalog/package checked 2026-11-07; confirm current inventory
C37 | 220uF 25V | Capacitor_SMD:CP_Elec_6.3x7.7 | 217EC0037 | KNSCHA | C42371908 | 1 | Manufacturer drawing and LCSC SMT catalog checked 2026-11-07; confirm JLCPCB order availability
C38 | 100nF 50V | Capacitor_SMD:C_0603_1608Metric | CC0603KRX7R9BB104 | YAGEO | C14663 | 1 | JLCPCB catalog/package checked 2026-11-07; confirm current inventory
C39 | 10uF 25V X7R | Capacitor_SMD:C_0805_2012Metric | C0805X7R106K250NT | SANYEAR | C2835529 | 1 | Manufacturer dimensions/ratings and JLCPCB catalog checked 2026-11-07; confirm order inventory
C40 | 100nF 16V | Capacitor_SMD:C_0402_1005Metric | CL05B104KO5NNNC | Samsung Electro-Mechanics | C1525 | 1 | JLCPCB catalog/package checked 2026-11-07; confirm current inventory
C41 | 220uF 25V | Capacitor_SMD:CP_Elec_6.3x7.7 | 217EC0037 | KNSCHA | C42371908 | 1 | Manufacturer drawing and LCSC SMT catalog checked 2026-11-07; confirm JLCPCB order availability
R20 | 10kR | Resistor_SMD:R_0603_1608Metric | 0603WAF1002T5E | Uniroyal Electronics | C25804 | 1 | Manufacturer dimensions/ratings and JLCPCB catalog checked 2026-11-07; confirm order inventory
R21 | 10kR | Resistor_SMD:R_0603_1608Metric | 0603WAF1002T5E | Uniroyal Electronics | C25804 | 1 | Manufacturer dimensions/ratings and JLCPCB catalog checked 2026-11-07; confirm order inventory
U5 | TB6612FNG | FabNano:SSOP-24_Toshiba_5.6x7.8mm_P0.65mm | TB6612FNG(O,C,8,EL | Toshiba | C88224 | 1 | Toshiba package/pinout and JLCPCB catalog checked 2026-11-07; confirm order inventory
U6 | TB6612FNG | FabNano:SSOP-24_Toshiba_5.6x7.8mm_P0.65mm | TB6612FNG(O,C,8,EL | Toshiba | C88224 | 1 | Toshiba package/pinout and JLCPCB catalog checked 2026-11-07; confirm order inventory
U7 | TB6612FNG | FabNano:SSOP-24_Toshiba_5.6x7.8mm_P0.65mm | TB6612FNG(O,C,8,EL | Toshiba | C88224 | 1 | Toshiba package/pinout and JLCPCB catalog checked 2026-11-07; confirm order inventory
C59 | 100nF 50V | Capacitor_SMD:C_0603_1608Metric | CC0603KRX7R9BB104 | YAGEO | C14663 | 1 | Manufacturer dimensions/ratings and JLCPCB catalog checked 2026-11-07; confirm order inventory
D3 | STATUS | LED_SMD:LED_0603_1608Metric | LTST-C190KGKT | Lite-On | C125094 | 1 | Manufacturer dimensions/ratings and JLCPCB catalog checked 2026-11-07; confirm order inventory
R3 | 100R | Resistor_SMD:R_0603_1608Metric | 0603WAF1000T5E | Uniroyal Electronics | C22775 | 1 | Manufacturer dimensions/ratings and JLCPCB catalog checked 2026-11-07; confirm order inventory
R4 | 100R | Resistor_SMD:R_0603_1608Metric | 0603WAF1000T5E | Uniroyal Electronics | C22775 | 1 | Manufacturer dimensions/ratings and JLCPCB catalog checked 2026-11-07; confirm order inventory
R5 | 0R | Resistor_SMD:R_0603_1608Metric | 0603WAF0000T5E | Uniroyal Electronics | C21189 | 1 | Manufacturer dimensions/ratings and JLCPCB catalog checked 2026-11-07; confirm order inventory
R6 | 0R | Resistor_SMD:R_0603_1608Metric | 0603WAF0000T5E | Uniroyal Electronics | C21189 | 1 | Manufacturer dimensions/ratings and JLCPCB catalog checked 2026-11-07; confirm order inventory
R9 | 1kR | Resistor_SMD:R_0603_1608Metric | 0603WAF1001T5E | Uniroyal Electronics | C21190 | 1 | Manufacturer dimensions/ratings and JLCPCB catalog checked 2026-11-07; confirm order inventory
R34 | 10kR | Resistor_SMD:R_0603_1608Metric | 0603WAF1002T5E | Uniroyal Electronics | C25804 | 1 | Manufacturer dimensions/ratings and JLCPCB catalog checked 2026-11-07; confirm order inventory
R35 | 10kR | Resistor_SMD:R_0603_1608Metric | 0603WAF1002T5E | Uniroyal Electronics | C25804 | 1 | Manufacturer dimensions/ratings and JLCPCB catalog checked 2026-11-07; confirm order inventory
R36 | 1kR | Resistor_SMD:R_0603_1608Metric | 0603WAF1001T5E | Uniroyal Electronics | C21190 | 1 | Manufacturer dimensions/ratings and JLCPCB catalog checked 2026-11-07; confirm order inventory
R47 | 1MR | Resistor_SMD:R_0603_1608Metric | 0603WAF1004T5E | Uniroyal Electronics | C22935 | 1 | Manufacturer dimensions/ratings and JLCPCB catalog checked 2026-11-07; confirm order inventory
R52 | 33R | Resistor_SMD:R_0402_1005Metric | 0402WGF330JTCE | Uniroyal Electronics | C25105 | 1 | Catalog part identified; confirm assembly availability when ordering
R53 | 33R | Resistor_SMD:R_0402_1005Metric | 0402WGF330JTCE | Uniroyal Electronics | C25105 | 1 | Catalog part identified; confirm assembly availability when ordering
R54 | 33R | Resistor_SMD:R_0402_1005Metric | 0402WGF330JTCE | Uniroyal Electronics | C25105 | 1 | Catalog part identified; confirm assembly availability when ordering
R55 | 33R | Resistor_SMD:R_0402_1005Metric | 0402WGF330JTCE | Uniroyal Electronics | C25105 | 1 | Catalog part identified; confirm assembly availability when ordering
R56 | 33R | Resistor_SMD:R_0402_1005Metric | 0402WGF330JTCE | Uniroyal Electronics | C25105 | 1 | Catalog part identified; confirm assembly availability when ordering
C60 | 100nF 16V | Capacitor_SMD:C_0402_1005Metric | CL05B104KO5NNNC | Samsung Electro-Mechanics | C1525 | 1 | JLCPCB catalog/package checked 2026-11-07; confirm current inventory
C61 | 10uF 10V X5R | Capacitor_SMD:C_0603_1608Metric | CL10A106KP8NNNC | Samsung Electro-Mechanics | C19702 | 1 | Manufacturer dimensions/ratings and JLCPCB catalog checked 2026-11-07; confirm order inventory
C62 | 100nF 16V | Capacitor_SMD:C_0402_1005Metric | CL05B104KO5NNNC | Samsung Electro-Mechanics | C1525 | 1 | JLCPCB catalog/package checked 2026-11-07; confirm current inventory
C63 | 10uF 10V X5R | Capacitor_SMD:C_0603_1608Metric | CL10A106KP8NNNC | Samsung Electro-Mechanics | C19702 | 1 | Manufacturer dimensions/ratings and JLCPCB catalog checked 2026-11-07; confirm order inventory
C64 | 100nF 16V | Capacitor_SMD:C_0402_1005Metric | CL05B104KO5NNNC | Samsung Electro-Mechanics | C1525 | 1 | JLCPCB catalog/package checked 2026-11-07; confirm current inventory
C65 | 1uF 50V X5R | Capacitor_SMD:C_0603_1608Metric | CL10A105KB8NNNC | Samsung Electro-Mechanics | C15849 | 1 | Manufacturer dimensions/ratings and JLCPCB catalog checked 2026-11-07; confirm order inventory
C67 | 100nF 16V | Capacitor_SMD:C_0402_1005Metric | CL05B104KO5NNNC | Samsung Electro-Mechanics | C1525 | 1 | JLCPCB catalog/package checked 2026-11-07; confirm current inventory
C68 | 100nF 16V | Capacitor_SMD:C_0402_1005Metric | CL05B104KO5NNNC | Samsung Electro-Mechanics | C1525 | 1 | JLCPCB catalog/package checked 2026-11-07; confirm current inventory
D2 | SS34 | Diode_SMD:D_SMA | SS34 | MDD (Microdiode Semiconductor) | C8678 | 1 | Manufacturer pinout/package and JLCPCB listing checked 2026-11-07; confirm order inventory
Q1 | AO3400A | Package_TO_SOT_SMD:SOT-23 | AO3400A | Alpha & Omega Semiconductor | C20917 | 1 | Manufacturer pinout/package and JLCPCB listing checked 2026-11-07; confirm order inventory
Q2 | AO3400A | Package_TO_SOT_SMD:SOT-23 | AO3400A | Alpha & Omega Semiconductor | C20917 | 1 | Manufacturer pinout/package and JLCPCB listing checked 2026-11-07; confirm order inventory
R40 | 10kR | Resistor_SMD:R_0603_1608Metric | 0603WAF1002T5E | Uniroyal Electronics | C25804 | 1 | Manufacturer dimensions/ratings and JLCPCB catalog checked 2026-11-07; confirm order inventory
R41 | 33R | Resistor_SMD:R_0603_1608Metric | 0603WAF330JT5E | Uniroyal Electronics | C23140 | 1 | Manufacturer dimensions/ratings and JLCPCB catalog checked 2026-11-07; confirm order inventory
R42 | 100kR | Resistor_SMD:R_0603_1608Metric | 0603WAF1003T5E | Uniroyal Electronics | C25803 | 1 | Manufacturer dimensions/ratings and JLCPCB catalog checked 2026-11-07; confirm order inventory
R43 | 33R | Resistor_SMD:R_0603_1608Metric | 0603WAF330JT5E | Uniroyal Electronics | C23140 | 1 | Manufacturer dimensions/ratings and JLCPCB catalog checked 2026-11-07; confirm order inventory
R44 | 100kR | Resistor_SMD:R_0603_1608Metric | 0603WAF1003T5E | Uniroyal Electronics | C25803 | 1 | Manufacturer dimensions/ratings and JLCPCB catalog checked 2026-11-07; confirm order inventory
R45 | 10kR | Resistor_SMD:R_0603_1608Metric | 0603WAF1002T5E | Uniroyal Electronics | C25804 | 1 | Manufacturer dimensions/ratings and JLCPCB catalog checked 2026-11-07; confirm order inventory
R46 | 10kR | Resistor_SMD:R_0603_1608Metric | 0603WAF1002T5E | Uniroyal Electronics | C25804 | 1 | Manufacturer dimensions/ratings and JLCPCB catalog checked 2026-11-07; confirm order inventory
U9 | DRV8837CDSGR | Package_SON:Texas_DSG0008A_WSON-8-1EP_2x2mm_P0.5mm_EP0.9x1.6mm | DRV8837CDSGR | Texas Instruments | C191000 | 1 | Manufacturer pinout/package and JLCPCB listing checked 2026-11-07; confirm order inventory
U10 | DRV8837CDSGR | Package_SON:Texas_DSG0008A_WSON-8-1EP_2x2mm_P0.5mm_EP0.9x1.6mm | DRV8837CDSGR | Texas Instruments | C191000 | 1 | Manufacturer pinout/package and JLCPCB listing checked 2026-11-07; confirm order inventory
U11 | TC4427AEOA | Package_SO:SOIC-8_3.9x4.9mm_P1.27mm | TC4427AEOA | Microchip Technology | C18690 | 1 | Manufacturer pinout/package and JLCPCB listing checked 2026-11-07; confirm order inventory
C1 | 4.7uF 16V X5R | Capacitor_SMD:C_0603_1608Metric | CL10A475KO8NNNC | Samsung Electro-Mechanics | C19666 | 1 | Samsung bias data and JLCPCB catalog/package checked 2026-11-07; confirm order inventory
C2 | 4.7uF 16V X5R | Capacitor_SMD:C_0603_1608Metric | CL10A475KO8NNNC | Samsung Electro-Mechanics | C19666 | 1 | Samsung bias data and JLCPCB catalog/package checked 2026-11-07; confirm order inventory
C3 | 10uF 10V X5R | Capacitor_SMD:C_0603_1608Metric | CL10A106KP8NNNC | Samsung Electro-Mechanics | C19702 | 1 | Manufacturer dimensions/ratings and JLCPCB catalog checked 2026-11-07; confirm order inventory
C4 | 100nF 50V | Capacitor_SMD:C_0603_1608Metric | CC0603KRX7R9BB104 | YAGEO | C14663 | 1 | Manufacturer dimensions/ratings and JLCPCB catalog checked 2026-11-07; confirm order inventory
C5 | 220uF 25V | Capacitor_SMD:CP_Elec_6.3x7.7 | 217EC0037 | KNSCHA | C42371908 | 1 | Manufacturer drawing and LCSC SMT catalog checked 2026-11-07; confirm JLCPCB order availability
C6 | 100nF 50V | Capacitor_SMD:C_0603_1608Metric | CC0603KRX7R9BB104 | YAGEO | C14663 | 1 | Manufacturer dimensions/ratings and JLCPCB catalog checked 2026-11-07; confirm order inventory
F1 | 4A 32V | FabNano:Fuse_Littelfuse_0466_1206 | 0466004.NRHF | Littelfuse | C187596 | 1 | Manufacturer land pattern/ratings and JLCPCB catalog checked 2026-11-07; confirm inventory
F2 | 4A 32V | FabNano:Fuse_Littelfuse_0466_1206 | 0466004.NRHF | Littelfuse | C187596 | 1 | Manufacturer land pattern/ratings and JLCPCB catalog checked 2026-11-07; confirm inventory
R1 | 100kR 1% | Resistor_SMD:R_0603_1608Metric | 0603WAF1003T5E | Uniroyal Electronics | C25803 | 1 | Manufacturer dimensions/ratings and JLCPCB catalog checked 2026-11-07; confirm order inventory
R2 | 22kR 1% | Resistor_SMD:R_0603_1608Metric | 0603WAF2202T5E | Uniroyal Electronics | C31850 | 1 | Manufacturer dimensions/ratings and JLCPCB catalog checked 2026-11-07; confirm order inventory
U2 | AP2112M-3.3TRG1 | Package_SO:SOIC-8_3.9x4.9mm_P1.27mm | AP2112M-3.3TRG1 | Diodes Incorporated | C5290219 | 1 | JLCPCB catalog/package checked 2026-11-07; stock not confirmed
C66 | 100nF 16V | Capacitor_SMD:C_0402_1005Metric | CL05B104KO5NNNC | Samsung Electro-Mechanics | C1525 | 1 | JLCPCB catalog/package checked 2026-11-07; confirm current inventory
R48 | 5.1kR 1% | Resistor_SMD:R_0603_1608Metric | 0603WAF5101T5E | Uniroyal Electronics | C23186 | 1 | Manufacturer dimensions/ratings and JLCPCB catalog checked 2026-11-07; confirm order inventory
R49 | 5.1kR 1% | Resistor_SMD:R_0603_1608Metric | 0603WAF5101T5E | Uniroyal Electronics | C23186 | 1 | Manufacturer dimensions/ratings and JLCPCB catalog checked 2026-11-07; confirm order inventory
R50 | 100kR 1% | Resistor_SMD:R_0603_1608Metric | 0603WAF1003T5E | Uniroyal Electronics | C25803 | 1 | Manufacturer dimensions/ratings and JLCPCB catalog checked 2026-11-07; confirm order inventory
R51 | 150kR 1% | Resistor_SMD:R_0603_1608Metric | 0603WAF1503T5E | Uniroyal Electronics | C22807 | 1 | Manufacturer dimensions/ratings and JLCPCB catalog checked 2026-11-07; confirm order inventory
U12 | USBLC6-2SC6 | Package_TO_SOT_SMD:SOT-23-6 | USBLC6-2SC6 | STMicroelectronics | C7519 | 1 | Exact part, package/model and JLCPCB catalog checked 2026-11-07; confirm inventory
