jonahsaunders/fab-computer-hackerfab/docs/manufacturing/backplane/BOM.csv

Comment | Designator | Footprint | JLCPCB Part # | Quantity
CL31A106KBHNNNE | C1,C2,C8,C9,C17,C25 | C_1206_3216Metric |  | 6
C1608X7R1H103M080AA | C3,C4,C7,C10,C11,C14 | C_0603_1608Metric |  | 6
217EC0037 | C5,C6,C12,C13 | CP_Elec_6.3x7.7 | C42371908 | 4
C1608X7R1E105K080AB | C15,C16,C37,C38 | C_0603_1608Metric |  | 4
0402B104K500HI | C18,C19,C20,C21,C22,C23,C24,C26,C27,C28,C30,C31,C33,C35,C41 | C_0402_1005Metric |  | 15
CC0603JRNPO0BN150 | C29,C34 | C_0603_1608Metric |  | 2
GRM155R60J475ME47D | C32,C36 | C_0402_1005Metric_VREG | C82453 | 2
GRT188R61C106KE13D | C39,C40 | C_0603_1608Metric |  | 2
CL05A475MO5NUNC | C42 | C_0402_1005Metric |  | 1
KT-0603R | D1,D3,D5,D6,D9,D10 | LED_0603_1608Metric | C2286 | 6
B540C-13-F | D2,D4 | D_SMC |  | 2
TVS2700DRVR | D7 | WSON-6_TVS2700DRV_2x2mm | C523797 | 1
BZT52C12 | D8 | D_SOD-123 | C43491 | 1
0451005.MRL | F1 | Fuse_Littelfuse-NANO2-451_453 | C48467 | 1
9001-12961C00A | J1,J2,J3 | WingTAT_9001-12961C00A_DIN41612_C_3x32_Vertical | C5173363 | 3
KF128-5.08-2P-AA | J4,J5,J6 | KF128-5.08-2P-AA | C474952 | 3
TYPE-C-31-M-12 | J7 | USB_C_Receptacle_HRO_TYPE-C-31-M-12 | C165948 | 1
ZX-SH1.0-3PWT | J9 | Megastar_ZX-SH1.0-3PWT_1x03_P1.00mm_Horizontal | C7430445 | 1
CDRH127/LDNP-150MC | L1,L2 | L_Sumida_CDRH127_LD_12.0x12.0mm |  | 2
AOTA-B201610S3R3-101-T | L3 | L_Abracon_AOTA-B201610S3R3-101-T | C42411119 | 1
DMP6023LE-13 | Q1 | SOT-223-3_TabPin4 | C154901 | 1
CRCW060310K0FKEA | R1,R2,R3,R5,R7 | R_0603_1608Metric |  | 5
RT0603FRE071K13L | R4,R9,R10,R12,R13,R14,R20,R21,R53,R54 | R_0603_1608Metric |  | 10
PT1206-R-070RL | R6,R11 | R_1206_3216Metric |  | 2
RT0603FRE073K16L | R8 | R_0603_1608Metric |  | 1
RC0402FR-0727RL | R15,R16 | R_0402_1005Metric |  | 2
RC0603JR-071KL | R17 | R_0603_1608Metric |  | 1
RT0603FRE07330KL | R18 | R_0603_1608Metric |  | 1
CRCW0603100KFKEA | R19 | R_0603_1608Metric |  | 1
RMEF0603JT5K10 | R22,R23 | R_0603_1608Metric |  | 2
RNCP0603FTD100R | R24,R25 | R_0603_1608Metric |  | 2
AA0402JR-070RL | R26,R27,R28,R29,R30,R31,R32,R33,R34,R35,R36,R37,R38,R39,R40,R41,R42,R43,R44,R45,R46,R47,R48,R49,R50,R51,R52,R56,R57 | R_0402_1005Metric |  | 29
RC0402JR-0733RP | R55 | R_0402_1005Metric |  | 1
RC0402FR-132K2L | R58,R59,R60,R61 | R_0402_1005Metric |  | 4
B3U-1000P | SW1,SW2 | B3U-1000P |  | 2
TPS5450DDAR | U1,U2 | Texas_HSOP-8-1EP_3.9x4.9mm_P1.27mm |  | 2
AP2112K-3.3TRG1 | U3 | SOT-23-5 |  | 1
USBLC6-2SC6 | U4 | SOT-23-6 |  | 1
RP2350B | U5 | QFN-80-1EP_10x10mm_P0.4mm_EP3.4x3.4mm |  | 1
TPS2116DRL | U6 | SOT-583-8 |  | 1
W25Q128JVSIQ | U7 | W25Q128JVSIQ_SOIC-8_5.3x5.3mm_P1.27mm |  | 1
ABM8-272-T3 | Y1 | generic_xtalcc320x250x80-4 | C20625731 | 1
