jonahsaunders/fab-computer-hackerfab/docs/manufacturing/encoder-splitter/BOM.csv

Comment | Designator | Footprint | JLCPCB Part # | Quantity
CL10A475KO8NNNC | C1,C2 | C_0603_1608Metric | C19666 | 2
CL10A106KP8NNNC | C3 | C_0603_1608Metric | C19702 | 1
B6B-PH-K-S(LF)(SN) | J1,J2,J3 | JST_PH_B6B-PH-K_1x06_P2.00mm_Vertical | C131342 | 3
9001-11961C00A | J4 | DIN96_Male_Horizontal | C5173361 | 1
0603WAF1002T5E | R1,R2,R3 | R_0603_1608Metric | C25804 | 3
AP2112M-3.3TRG1 | U1 | SOIC-8_3.9x4.9mm_P1.27mm | C5290219 | 1
