jonahsaunders/fab-computer-hackerfab/docs/connector-pinout.csv

connector | pad | function | net | paired_pad | jumper
J1 | A10 | SPI0_CS3 | /SPI0_CS3 | C10 | R37
J1 | C10 | SPI0_CS2 | /SPI0_CS2 | A10 | R36
J1 | A11 | SPI0_MOSI | /SPI0_MOSI | C11 | R33
J1 | C11 | SPI0_CLK | /SPI0_CLK | A11 | R34
J1 | A12 | SPI0_CS1 | /SPI0_CS1 | C12 | R35
J1 | C12 | SPI0_MISO | /SPI0_MISO | A12 | R32
J1 | A13 | AUX7 | NC | C13
J1 | C13 | AUX4 | NC | A13
J1 | A14 | AUX1 | /AUX1 | C14 | R44
J1 | C14 | AUX9 | NC | A14
J1 | A15 | AUX8 | NC | C15
J1 | C15 | AUX6 | NC | A15
J1 | A16 | I2C0_SCL | /I2C0_SCL | C16 | R29
J1 | C16 | I2C0_SDA | /I2C0_SDA | A16 | R28
J1 | A17 | I2C1_SCL | /I2C1_SCL | C17 | R31
J1 | C17 | I2C1_SDA | /I2C1_SDA | A17 | R30
J1 | A18 | AUX5 | NC | C18
J1 | C18 | AUX3 | /AUX3 | A18 | R48
J1 | A19 | AUX2 | /AUX2 | C19 | R47
J1 | C19 | AUX10 | NC | A19
J1 | A20 | UART_RX | /UART_RX | C20 | R27
J1 | C20 | UART_TX | /UART_TX | A20 | R26
J1 | A21 | SPI1_CS3 | /SPI1_CS3 | C21 | R43
J1 | C21 | SPI1_CS2 | /SPI1_CS2 | A21 | R42
J1 | A22 | SPI1_MOSI | /SPI1_MOSI | C22 | R39
J1 | C22 | SPI1_CLK | /SPI1_CLK | A22 | R40
J1 | A23 | SPI1_CS1 | /SPI1_CS1 | C23 | R41
J1 | C23 | SPI1_MISO | /SPI1_MISO | A23 | R38
J2 | A10 | SPI0_CS3 | /SPI0_CS3 | C10 | R37
J2 | C10 | SPI0_CS2 | /SPI0_CS2 | A10 | R36
J2 | A11 | SPI0_MOSI | /SPI0_MOSI | C11 | R33
J2 | C11 | SPI0_CLK | /SPI0_CLK | A11 | R34
J2 | A12 | SPI0_CS1 | /SPI0_CS1 | C12 | R35
J2 | C12 | SPI0_MISO | /SPI0_MISO | A12 | R32
J2 | A13 | AUX7 | NC | C13
J2 | C13 | AUX4 | /AUX4 | A13 | R45
J2 | A14 | AUX1 | NC | C14
J2 | C14 | AUX9 | NC | A14
J2 | A15 | AUX8 | NC | C15
J2 | C15 | AUX6 | /AUX6 | A15 | R50
J2 | A16 | I2C0_SCL | /I2C0_SCL | C16 | R29
J2 | C16 | I2C0_SDA | /I2C0_SDA | A16 | R28
J2 | A17 | I2C1_SCL | /I2C1_SCL | C17 | R31
J2 | C17 | I2C1_SDA | /I2C1_SDA | A17 | R30
J2 | A18 | AUX5 | /AUX5 | C18 | R49
J2 | C18 | AUX3 | NC | A18
J2 | A19 | AUX2 | NC | C19
J2 | C19 | AUX10 | NC | A19
J2 | A20 | UART2_RX | /UART2_RX | C20 | R57
J2 | C20 | UART2_TX | /UART2_TX | A20 | R56
J2 | A21 | SPI1_CS3 | /SPI1_CS3 | C21 | R43
J2 | C21 | SPI1_CS2 | /SPI1_CS2 | A21 | R42
J2 | A22 | SPI1_MOSI | /SPI1_MOSI | C22 | R39
J2 | C22 | SPI1_CLK | /SPI1_CLK | A22 | R40
J2 | A23 | SPI1_CS1 | /SPI1_CS1 | C23 | R41
J2 | C23 | SPI1_MISO | /SPI1_MISO | A23 | R38
J3 | A10 | SPI0_CS3 | /SPI0_CS3 | C10 | R37
J3 | C10 | SPI0_CS2 | /SPI0_CS2 | A10 | R36
J3 | A11 | SPI0_MOSI | /SPI0_MOSI | C11 | R33
J3 | C11 | SPI0_CLK | /SPI0_CLK | A11 | R34
J3 | A12 | SPI0_CS1 | /SPI0_CS1 | C12 | R35
J3 | C12 | SPI0_MISO | /SPI0_MISO | A12 | R32
J3 | A13 | AUX7 | /AUX7 | C13 | R46
J3 | C13 | AUX4 | NC | A13
J3 | A14 | AUX1 | NC | C14
J3 | C14 | AUX9 | /AUX9 | A14 | R52
J3 | A15 | AUX8 | /AUX8 | C15 | R51
J3 | C15 | AUX6 | NC | A15
J3 | A16 | I2C0_SCL | /I2C0_SCL | C16 | R29
J3 | C16 | I2C0_SDA | /I2C0_SDA | A16 | R28
J3 | A17 | I2C1_SCL | /I2C1_SCL | C17 | R31
J3 | C17 | I2C1_SDA | /I2C1_SDA | A17 | R30
J3 | A18 | AUX5 | NC | C18
J3 | C18 | AUX3 | NC | A18
J3 | A19 | AUX2 | NC | C19
J3 | C19 | AUX10 | NC | A19
J3 | A20 | UART_RX | NC | C20
J3 | C20 | UART_TX | NC | A20
J3 | A21 | SPI1_CS3 | /SPI1_CS3 | C21 | R43
J3 | C21 | SPI1_CS2 | /SPI1_CS2 | A21 | R42
J3 | A22 | SPI1_MOSI | /SPI1_MOSI | C22 | R39
J3 | C22 | SPI1_CLK | /SPI1_CLK | A22 | R40
J3 | A23 | SPI1_CS1 | /SPI1_CS1 | C23 | R41
J3 | C23 | SPI1_MISO | /SPI1_MISO | A23 | R38
