jonahsaunders/fab-computer-hackerfab/docs/manufacturing/motion-controller/Via-Fill-Map.png

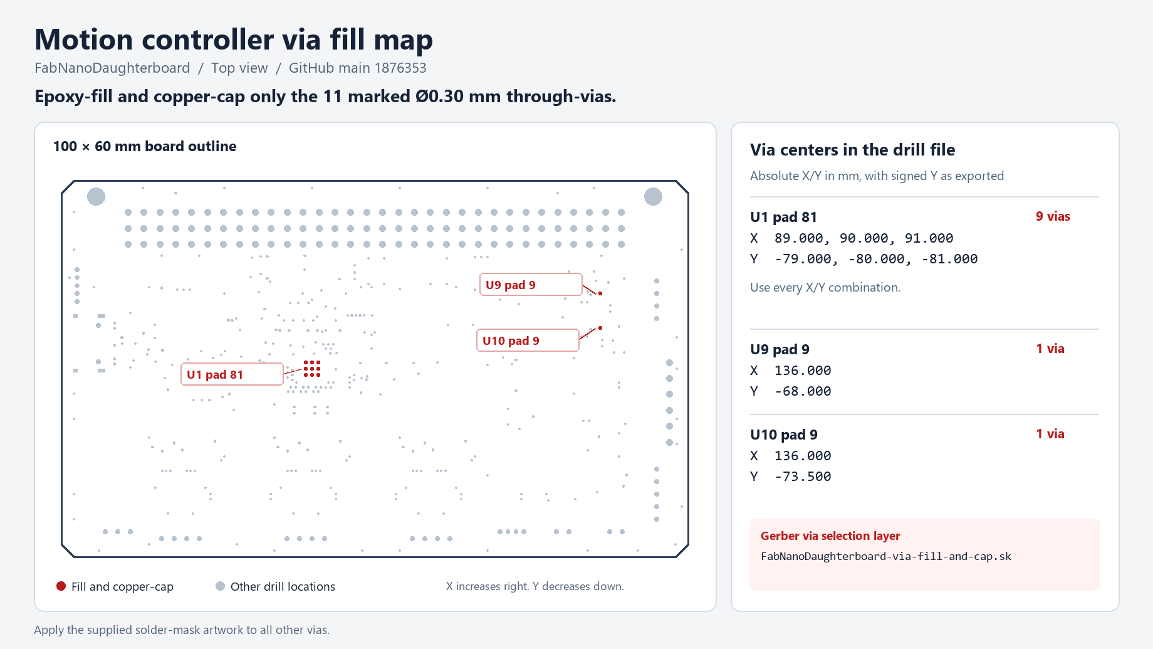
docs/manufacturing/motion-controller/Via-Fill-Map.png
