jonahsaunders/fab-computer-hackerfab/daughterboards/micromanipulator/docs/validation.txt

Current validation: 2026-11-08, KiCad 10.0.6.
Motion: 117 fitted parts + 4 bare pads; 100 x 60 mm; 4 layers.
Encoder: 11 fitted parts + 4 bare pads; 100 x 26 mm; 4 layers.
Both: ERC 0; DRC 0; unconnected 0; schematic parity 0.
Nine rendered schematic pages: text/wire/text/crossing/overlap audit 0.
35 direct supply paths and 48 local capacitor ground returns checked.
Backplane SPI0 reserved for motion; host GPIO16-21 input/no pulls required.
Physical fit, signal integrity, loads/thermal and firmware integration remain open.
See validation.md for scope and reproduction.
