jonahsaunders/fab-computer-hackerfab/daughterboards/micromanipulator/docs/encoder-backplane-schematic.pdf

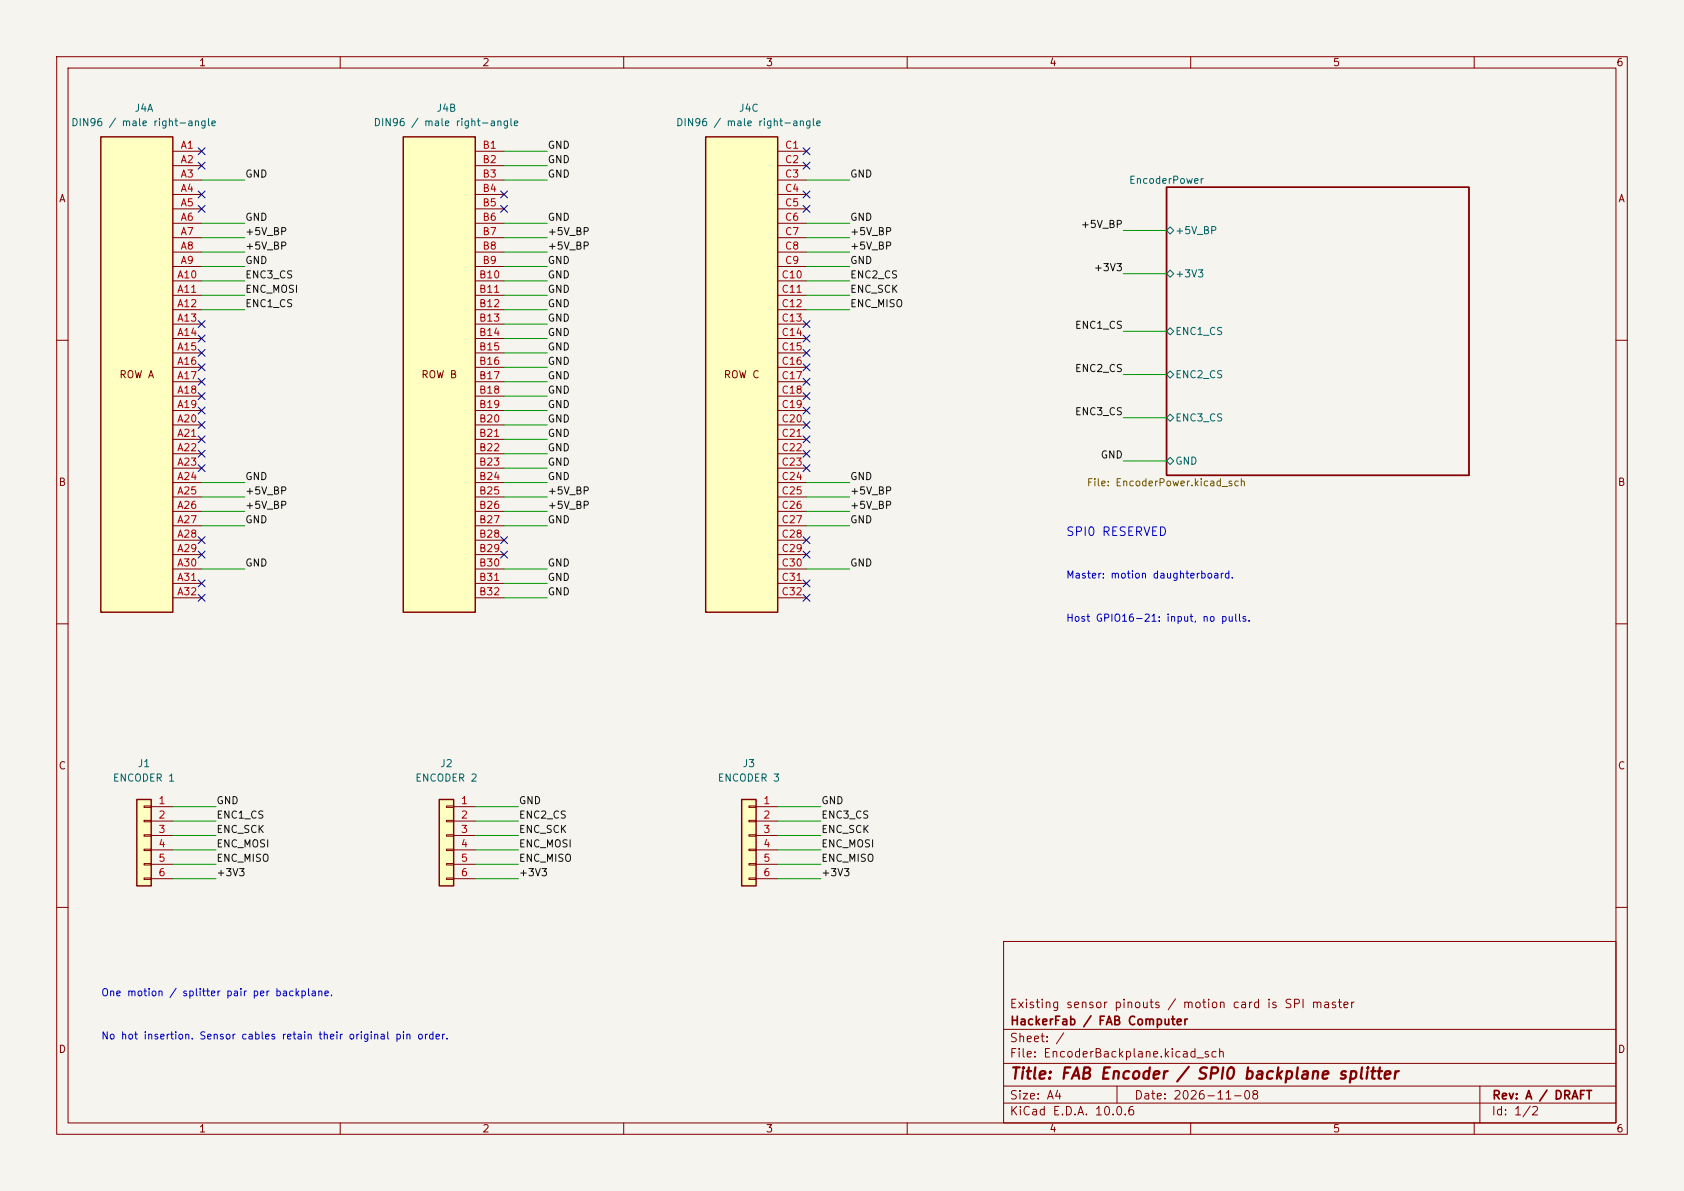
[picture p36: page 1]

EncoderPower File: EncoderPower.kicad_sch ROW A

Master: motion daughterboard. Host GPIO16-21: input, no pulls. One motion / splitter pair per backplane. No hot insertion. Sensor cables retain their original pin order.

Existing sensor pinouts / motion card is SPI master
HackerFab / FAB Computer
Sheet: /
File: EncoderBackplane.kicad_sch
Title: FAB Encoder / SPI0 backplane splitter

Size: A4 | Rev: A / DRAFT
KiCad E.D.A. 10.0.6 | Id: 1/2

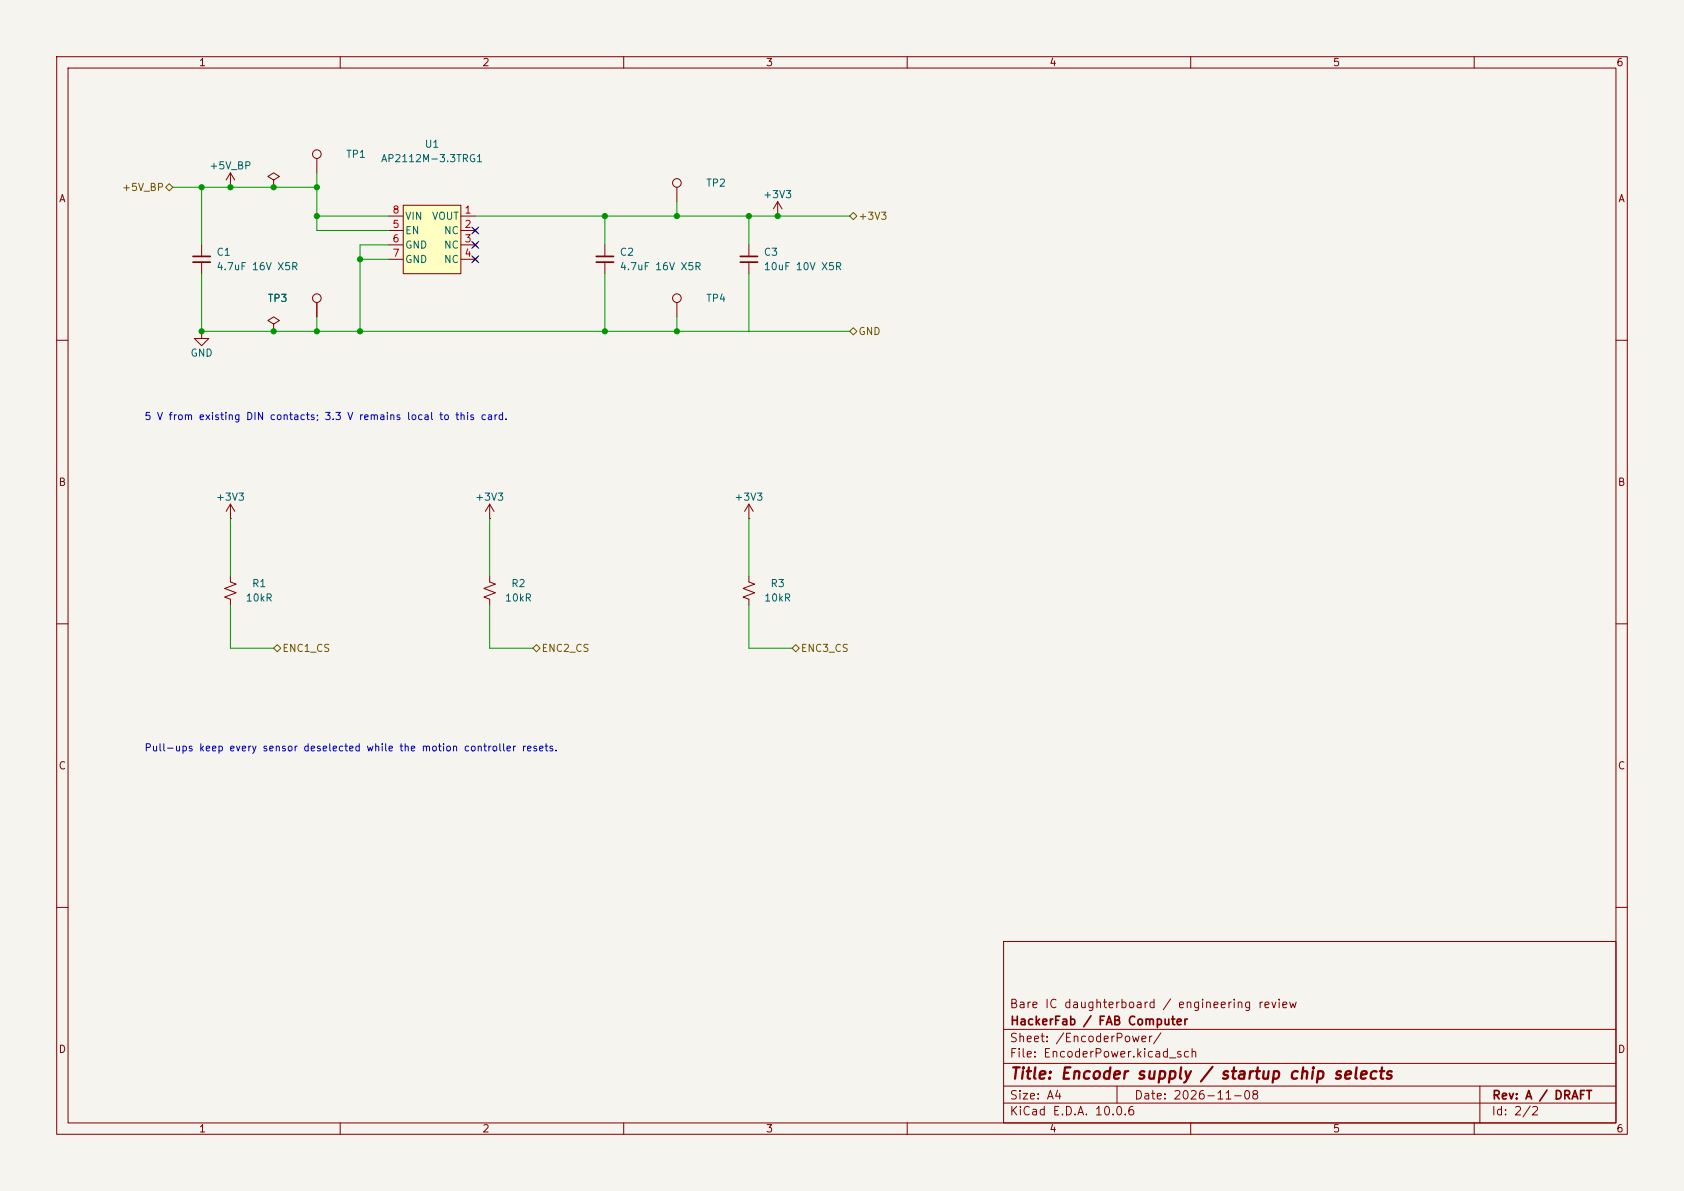
[picture p37: page 2]

Bare IC daughterboard / engineering review
HackerFab / FAB Computer
Sheet: /EncoderPower/
File: EncoderPower.kicad_sch
Title: Encoder supply / startup chip selects

Size: A4 | Rev: A / DRAFT
KiCad E.D.A. 10.0.6 | Id: 2/2
