jonahsaunders/fab-computer-hackerfab/daughterboards/micromanipulator/docs/encoder-splitter-schematic.pdf

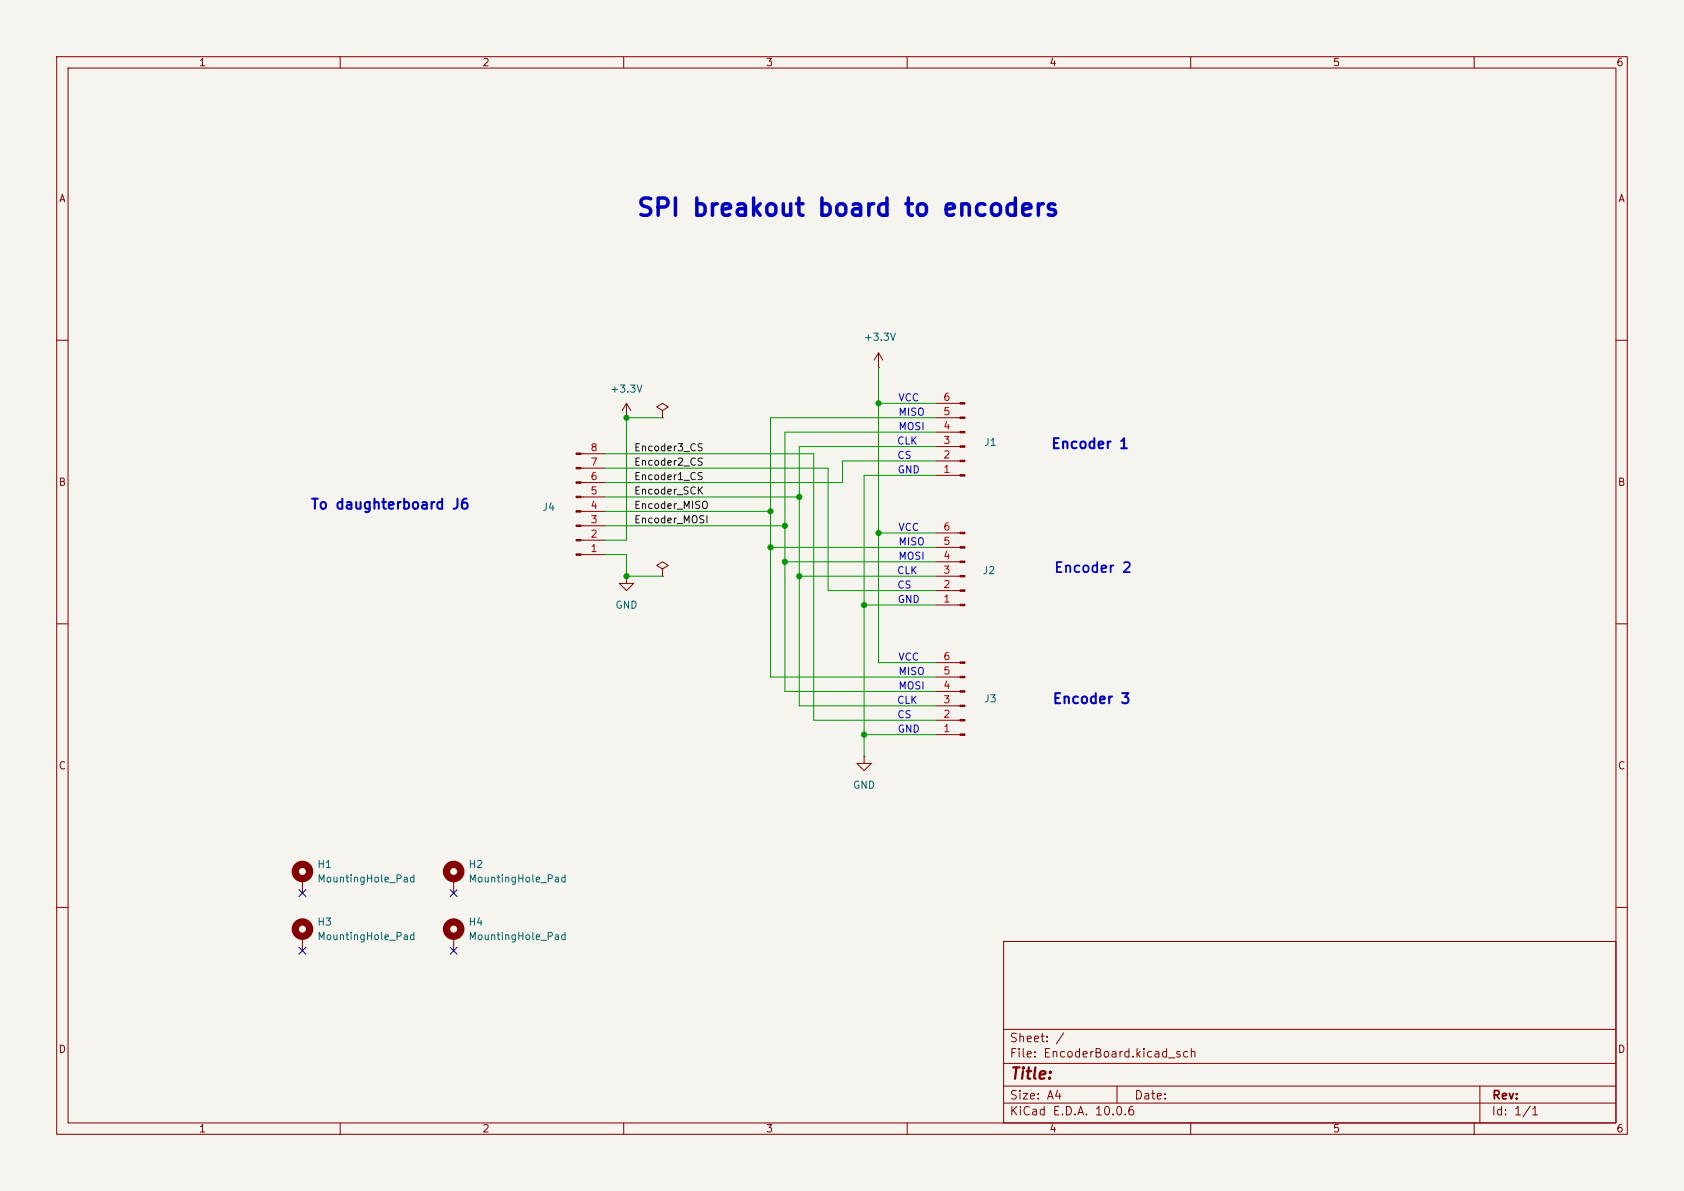
[picture p38: page 1]

SPI breakout board to encoders

Size: A4 | Rev:
KiCad E.D.A. 10.0.6 | Id: 1/1
