jonahsaunders/fab-computer-hackerfab/daughterboards/micromanipulator/docs/schematic-review.pdf

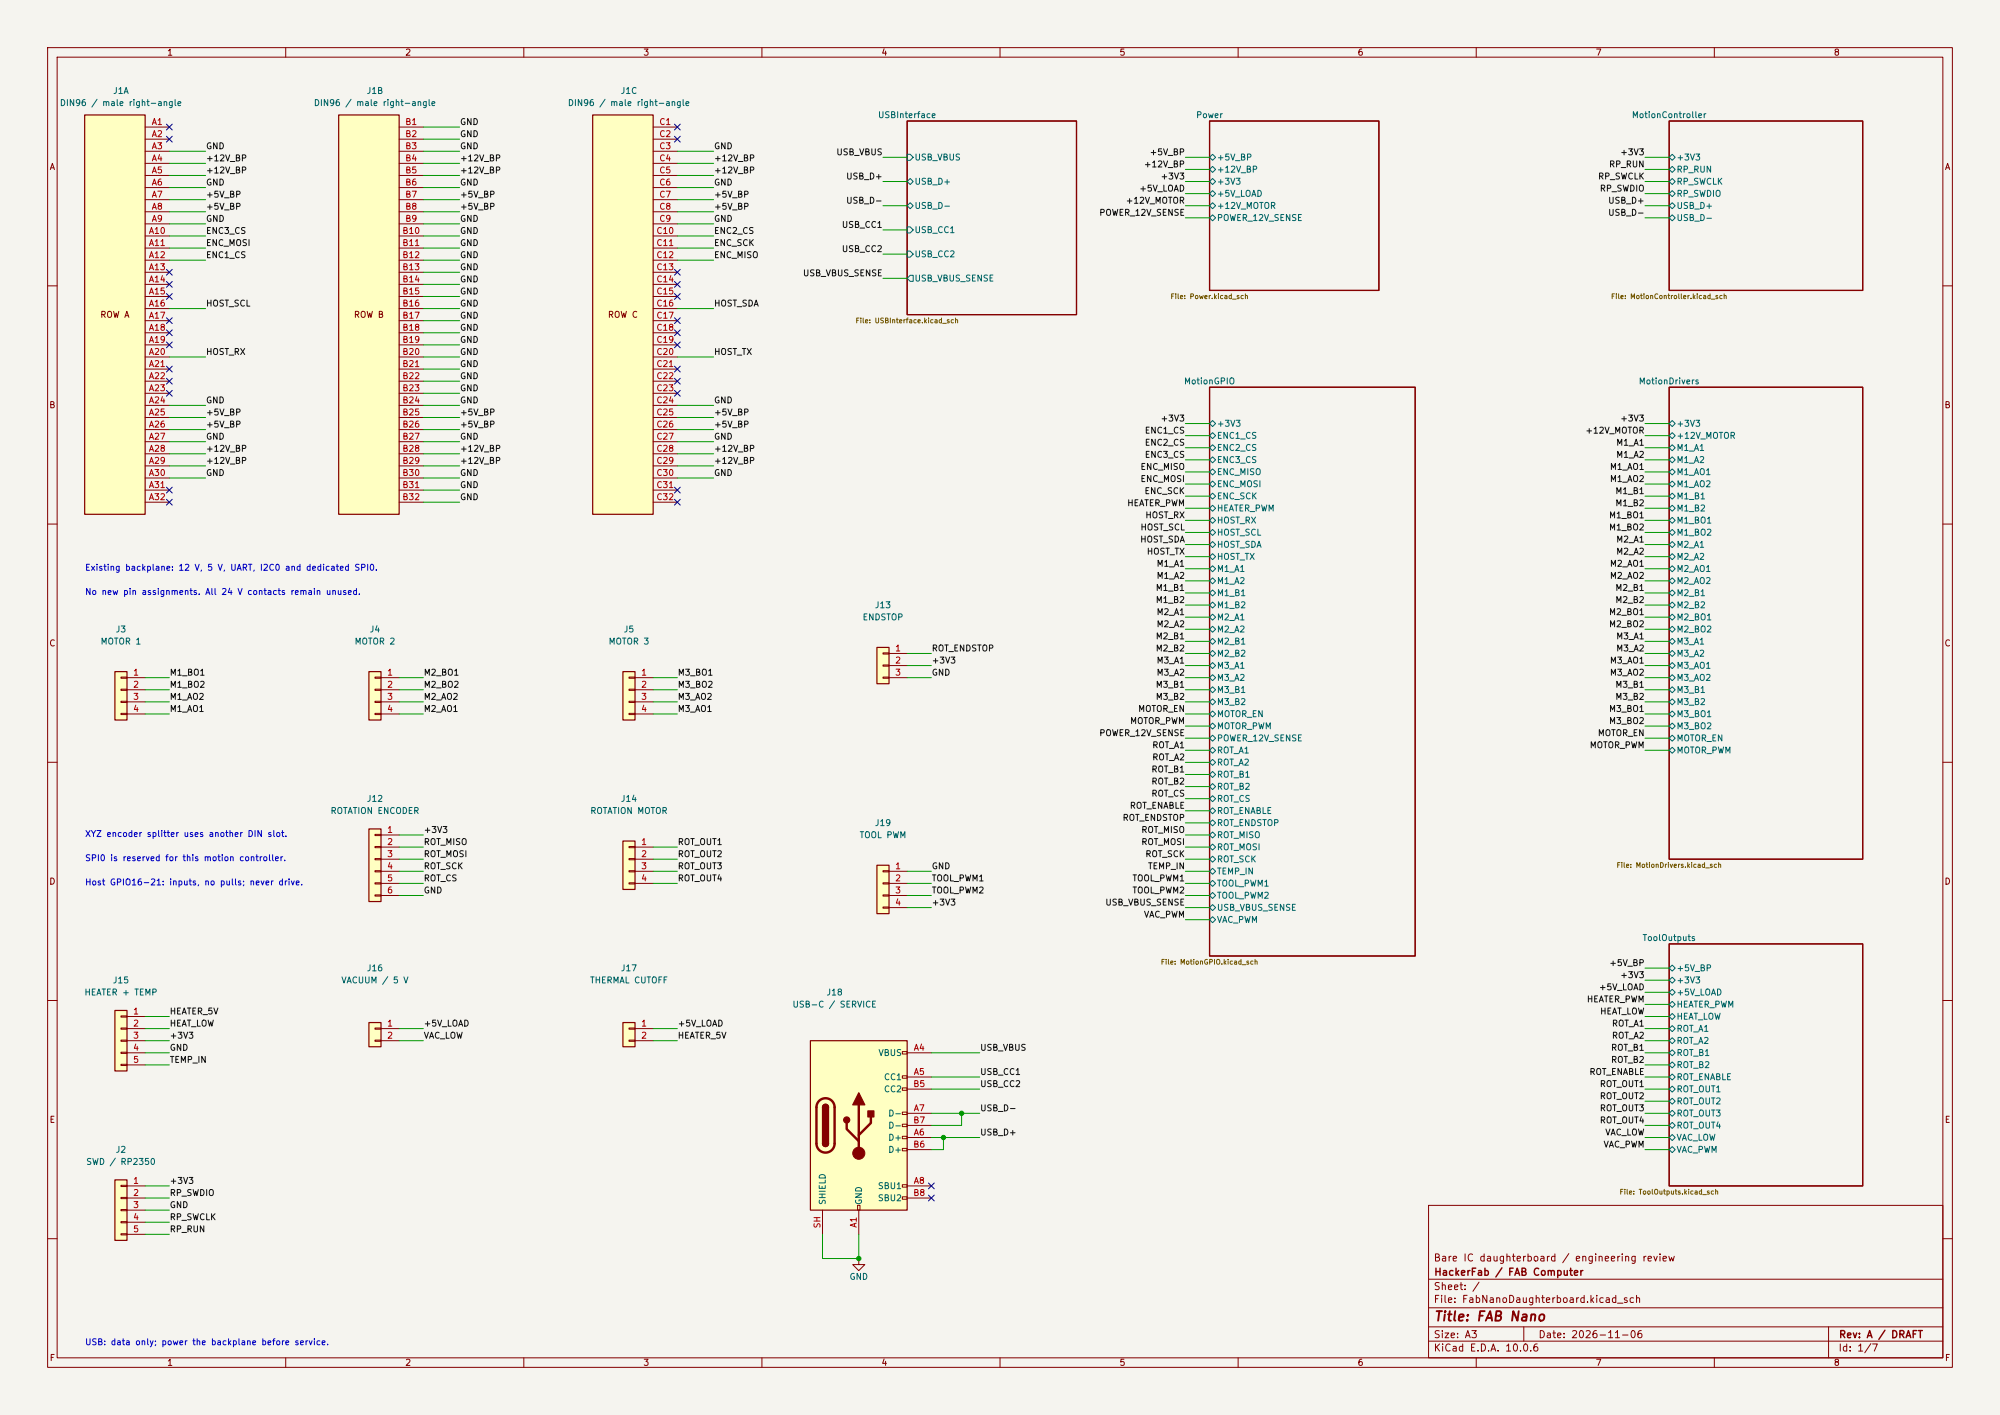
[picture p39: page 1]

USB_D-
SPI0 is reserved for this motion controller. Existing backplane: 12 V, 5 V, UART, I2C0 and dedicated SPI0. XYZ encoder splitter uses another DIN slot. No new pin assignments. All 24 V contacts remain unused. Host GPIO16-21: inputs, no pulls; never drive. USB: data only; power the backplane before service.

Bare IC daughterboard / engineering review
HackerFab / FAB Computer
Sheet: /
File: FabNanoDaughterboard.kicad_sch
Title: FAB Nano

Size: A3 | Rev: A / DRAFT
KiCad E.D.A. 10.0.6 | Id: 1/7

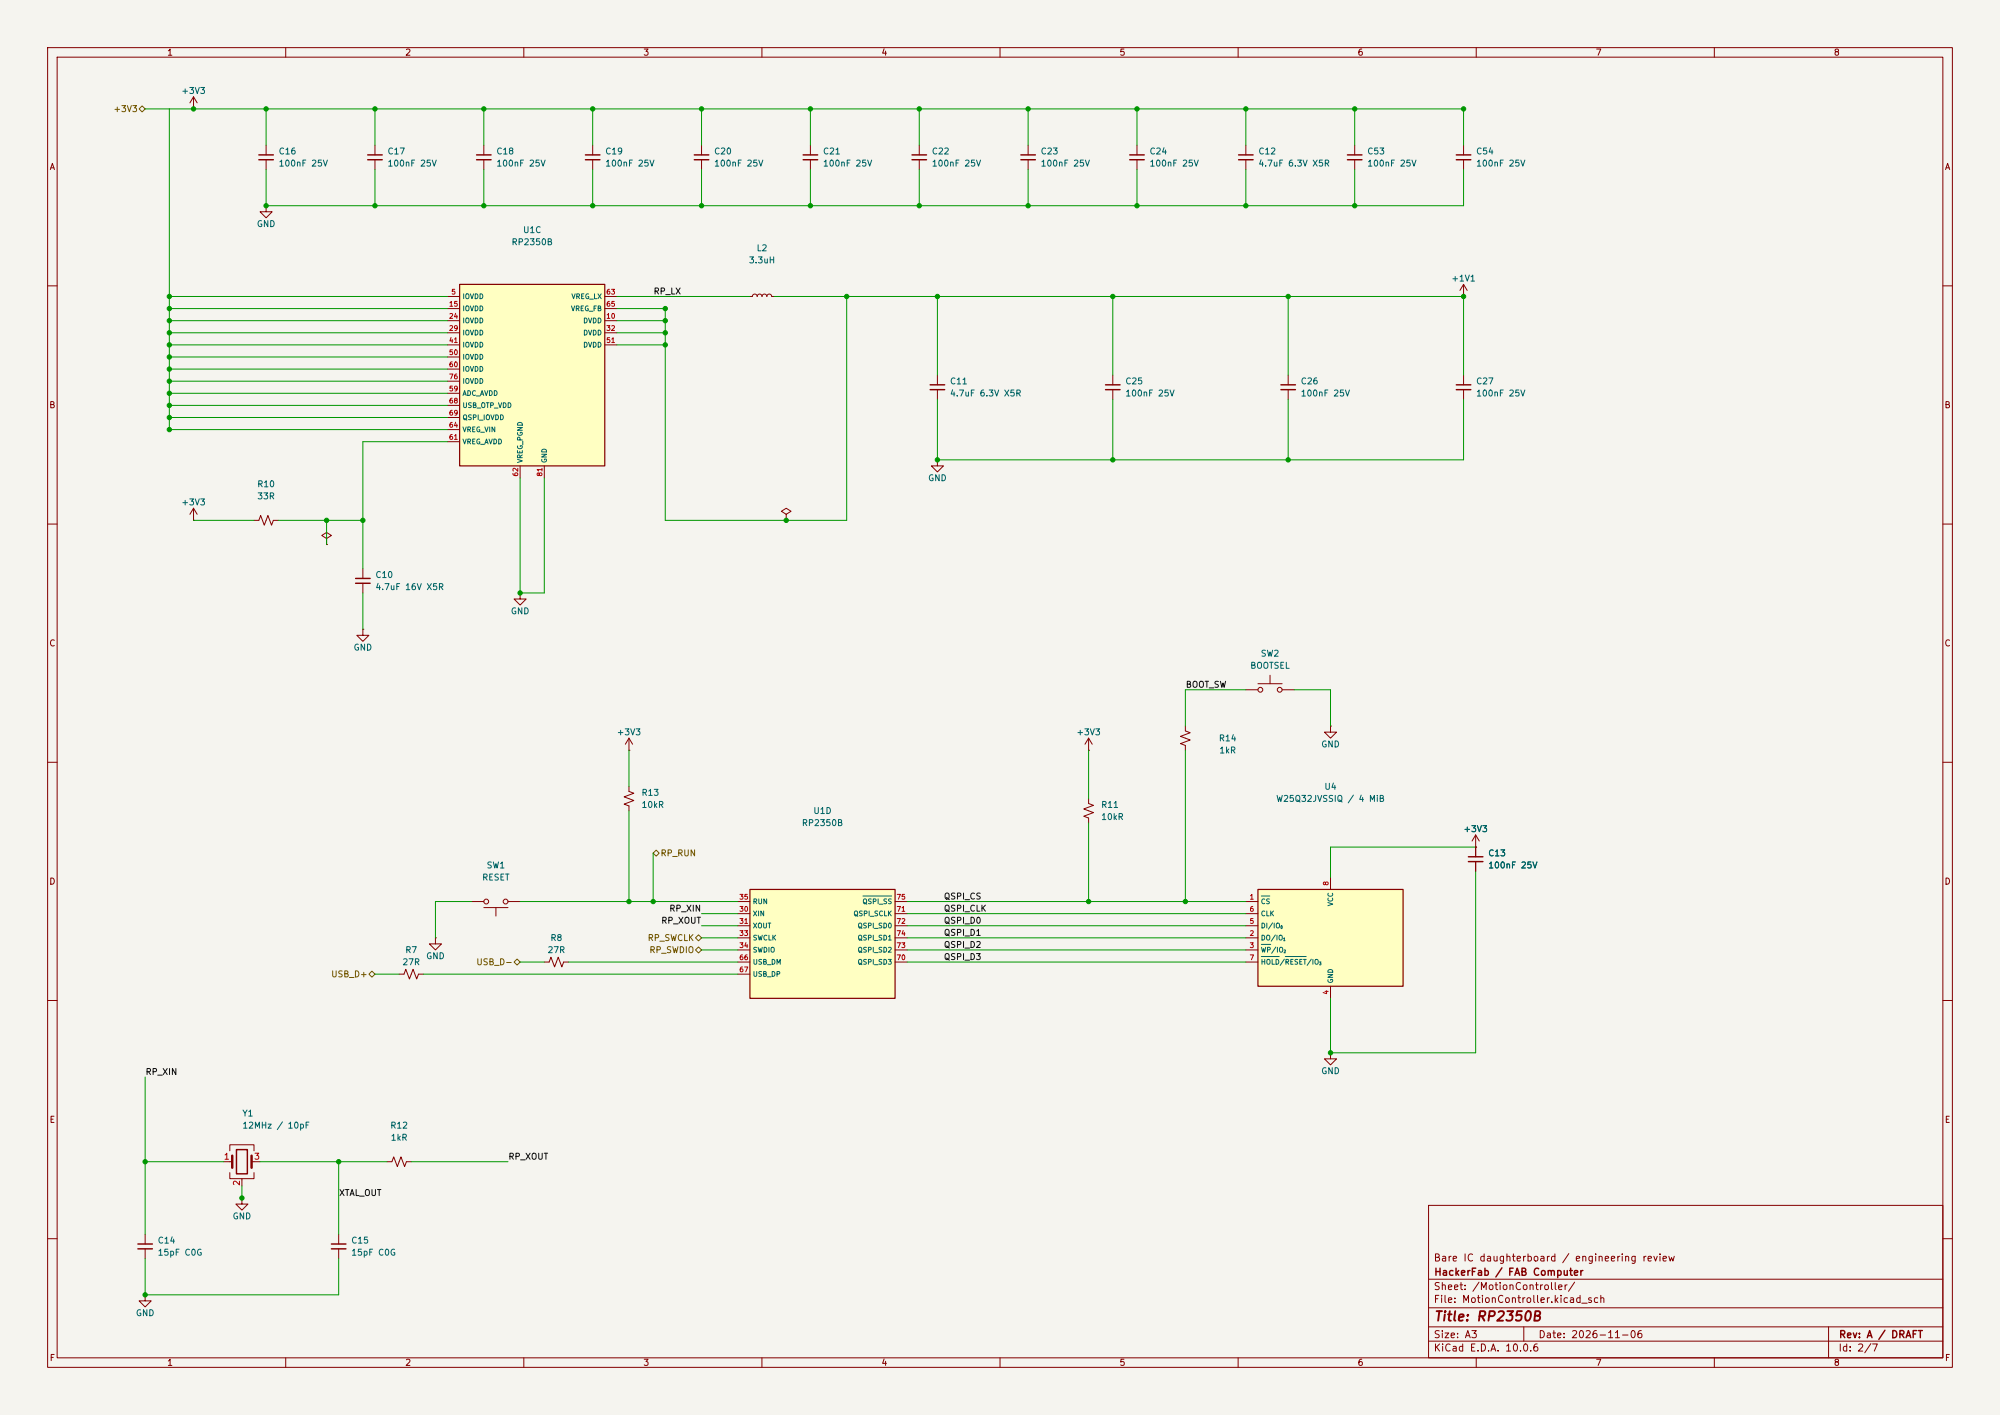
[picture p40: page 2]

4 DI/IO0 5 CLK 6 HOLD/RESET/IO3 7 VCC

Bare IC daughterboard / engineering review
HackerFab / FAB Computer
Sheet: /MotionController/
File: MotionController.kicad_sch
Title: RP2350B

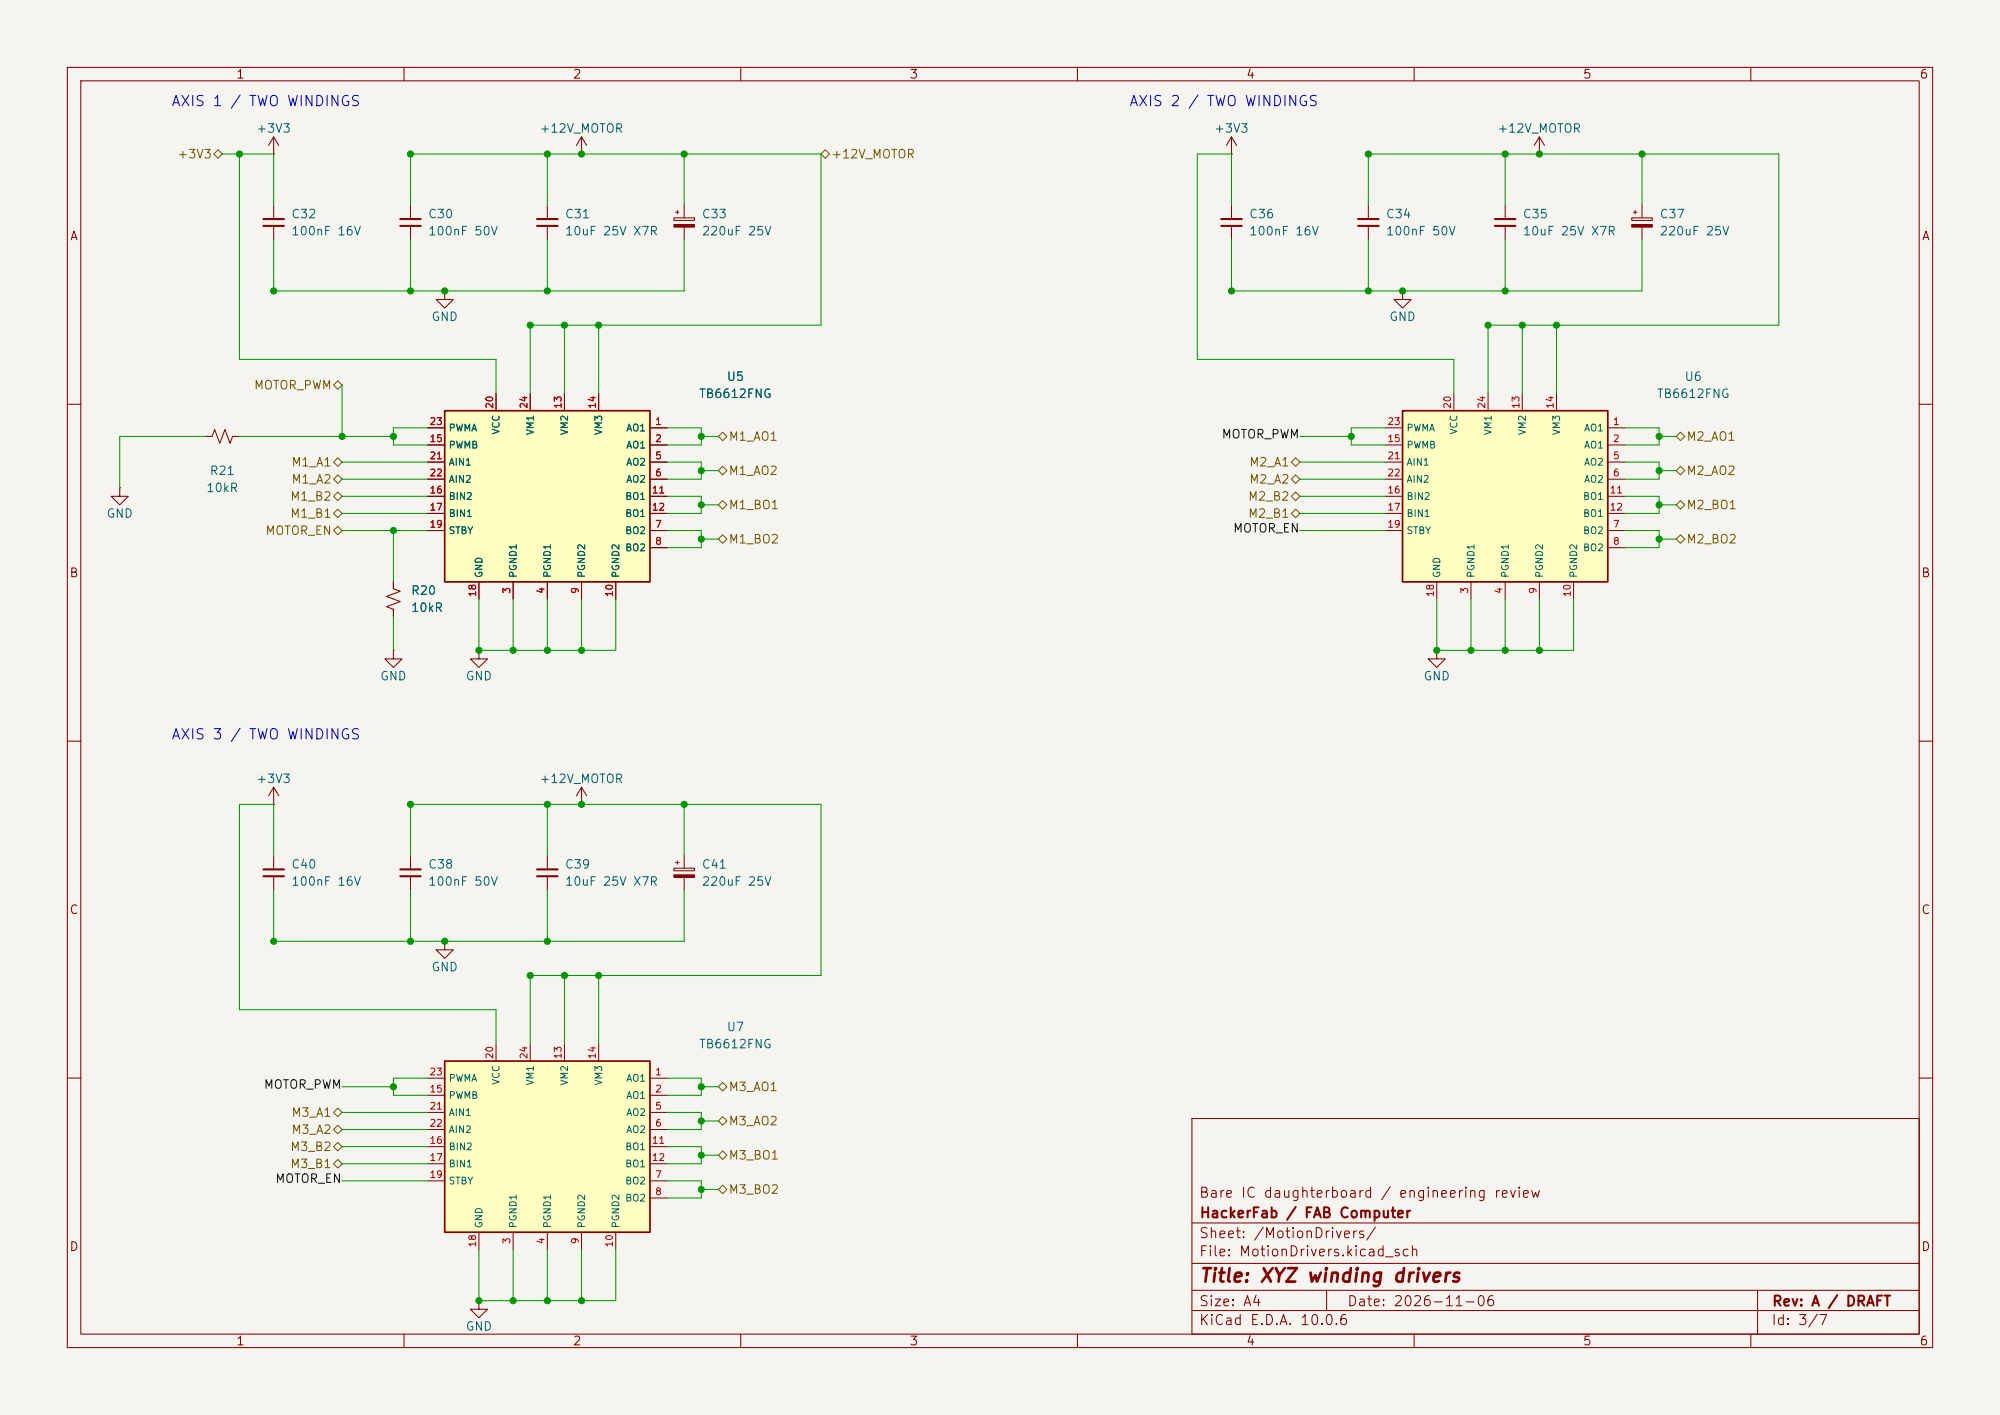
[picture p41: page 3]

Bare IC daughterboard / engineering review
HackerFab / FAB Computer
Sheet: /MotionDrivers/
File: MotionDrivers.kicad_sch
Title: XYZ winding drivers

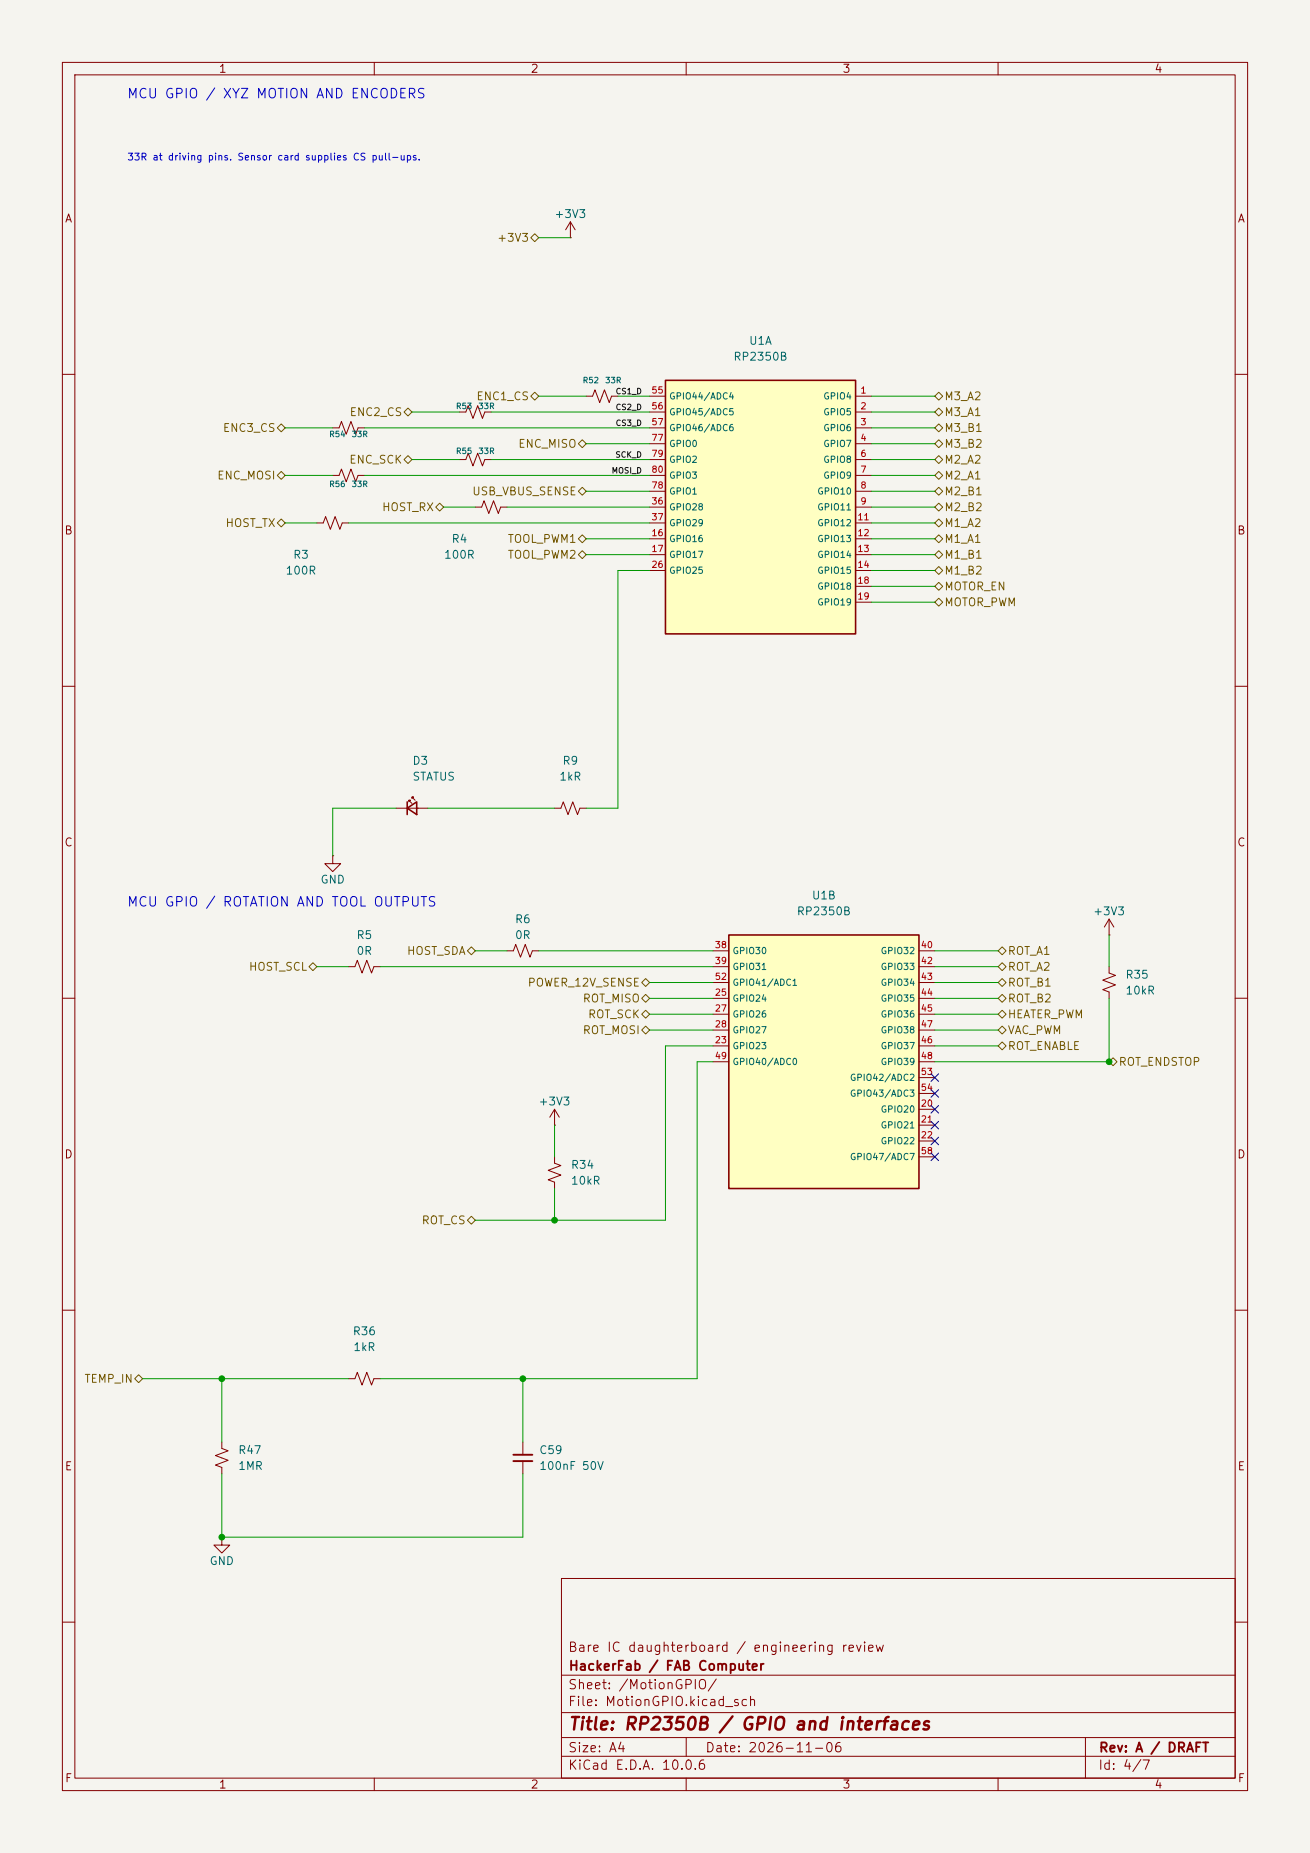
[picture p42: page 4]

MCU GPIO / XYZ MOTION AND ENCODERS

CS2_D 33R at driving pins. Sensor card supplies CS pull-ups.

MCU GPIO / ROTATION AND TOOL OUTPUTS

Bare IC daughterboard / engineering review
HackerFab / FAB Computer
Sheet: /MotionGPIO/
File: MotionGPIO.kicad_sch
Title: RP2350B / GPIO and interfaces

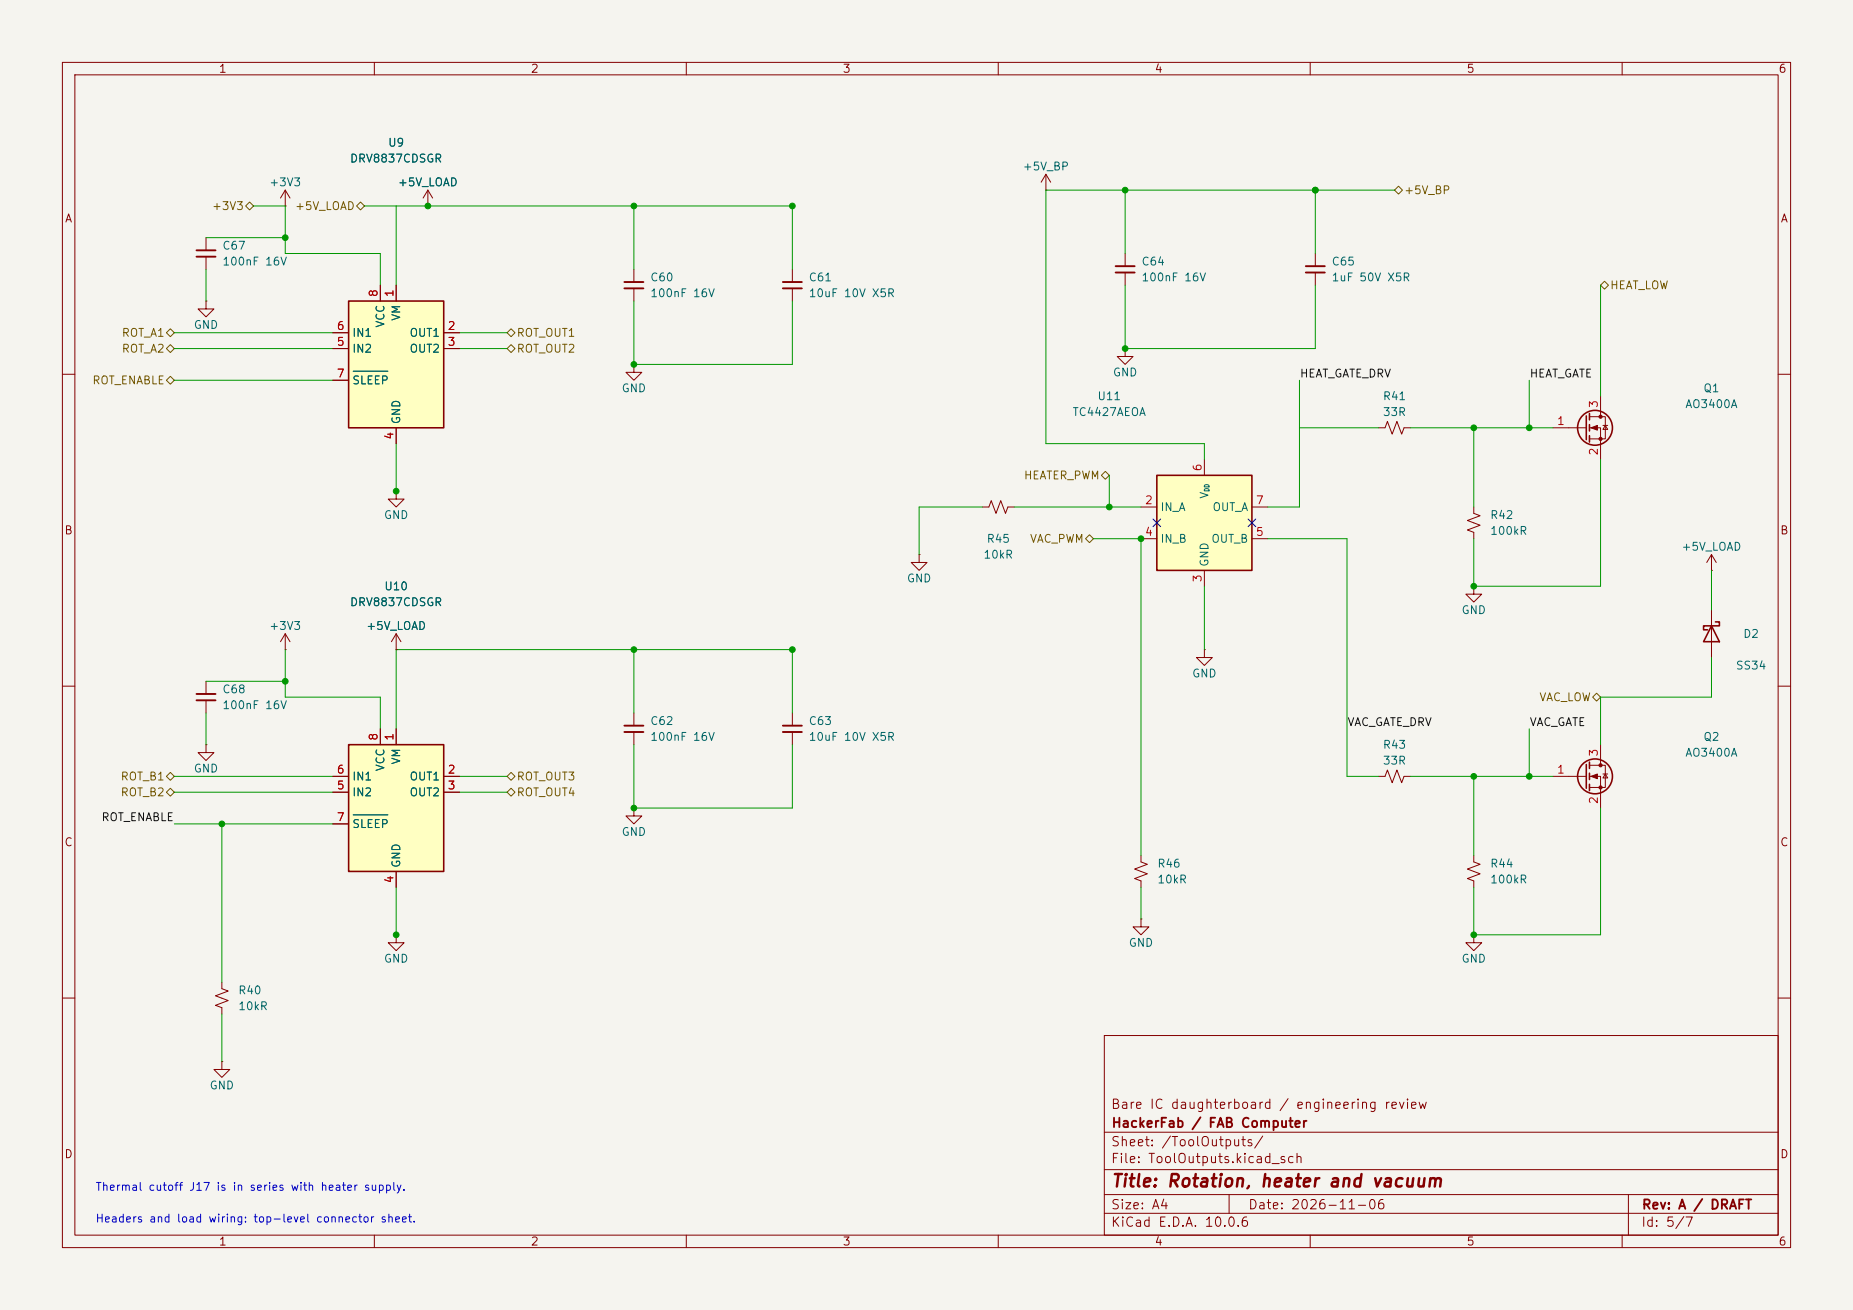
[picture p43: page 5]

VAC_GATE_DRV HEAT_GATE_DRV Headers and load wiring: top-level connector sheet. Thermal cutoff J17 is in series with heater supply.

1 OUT1 2 OUT2 3 GND
Bare IC daughterboard / engineering review VM

HackerFab / FAB Computer
Sheet: /ToolOutputs/
File: ToolOutputs.kicad_sch
Title: Rotation, heater and vacuum

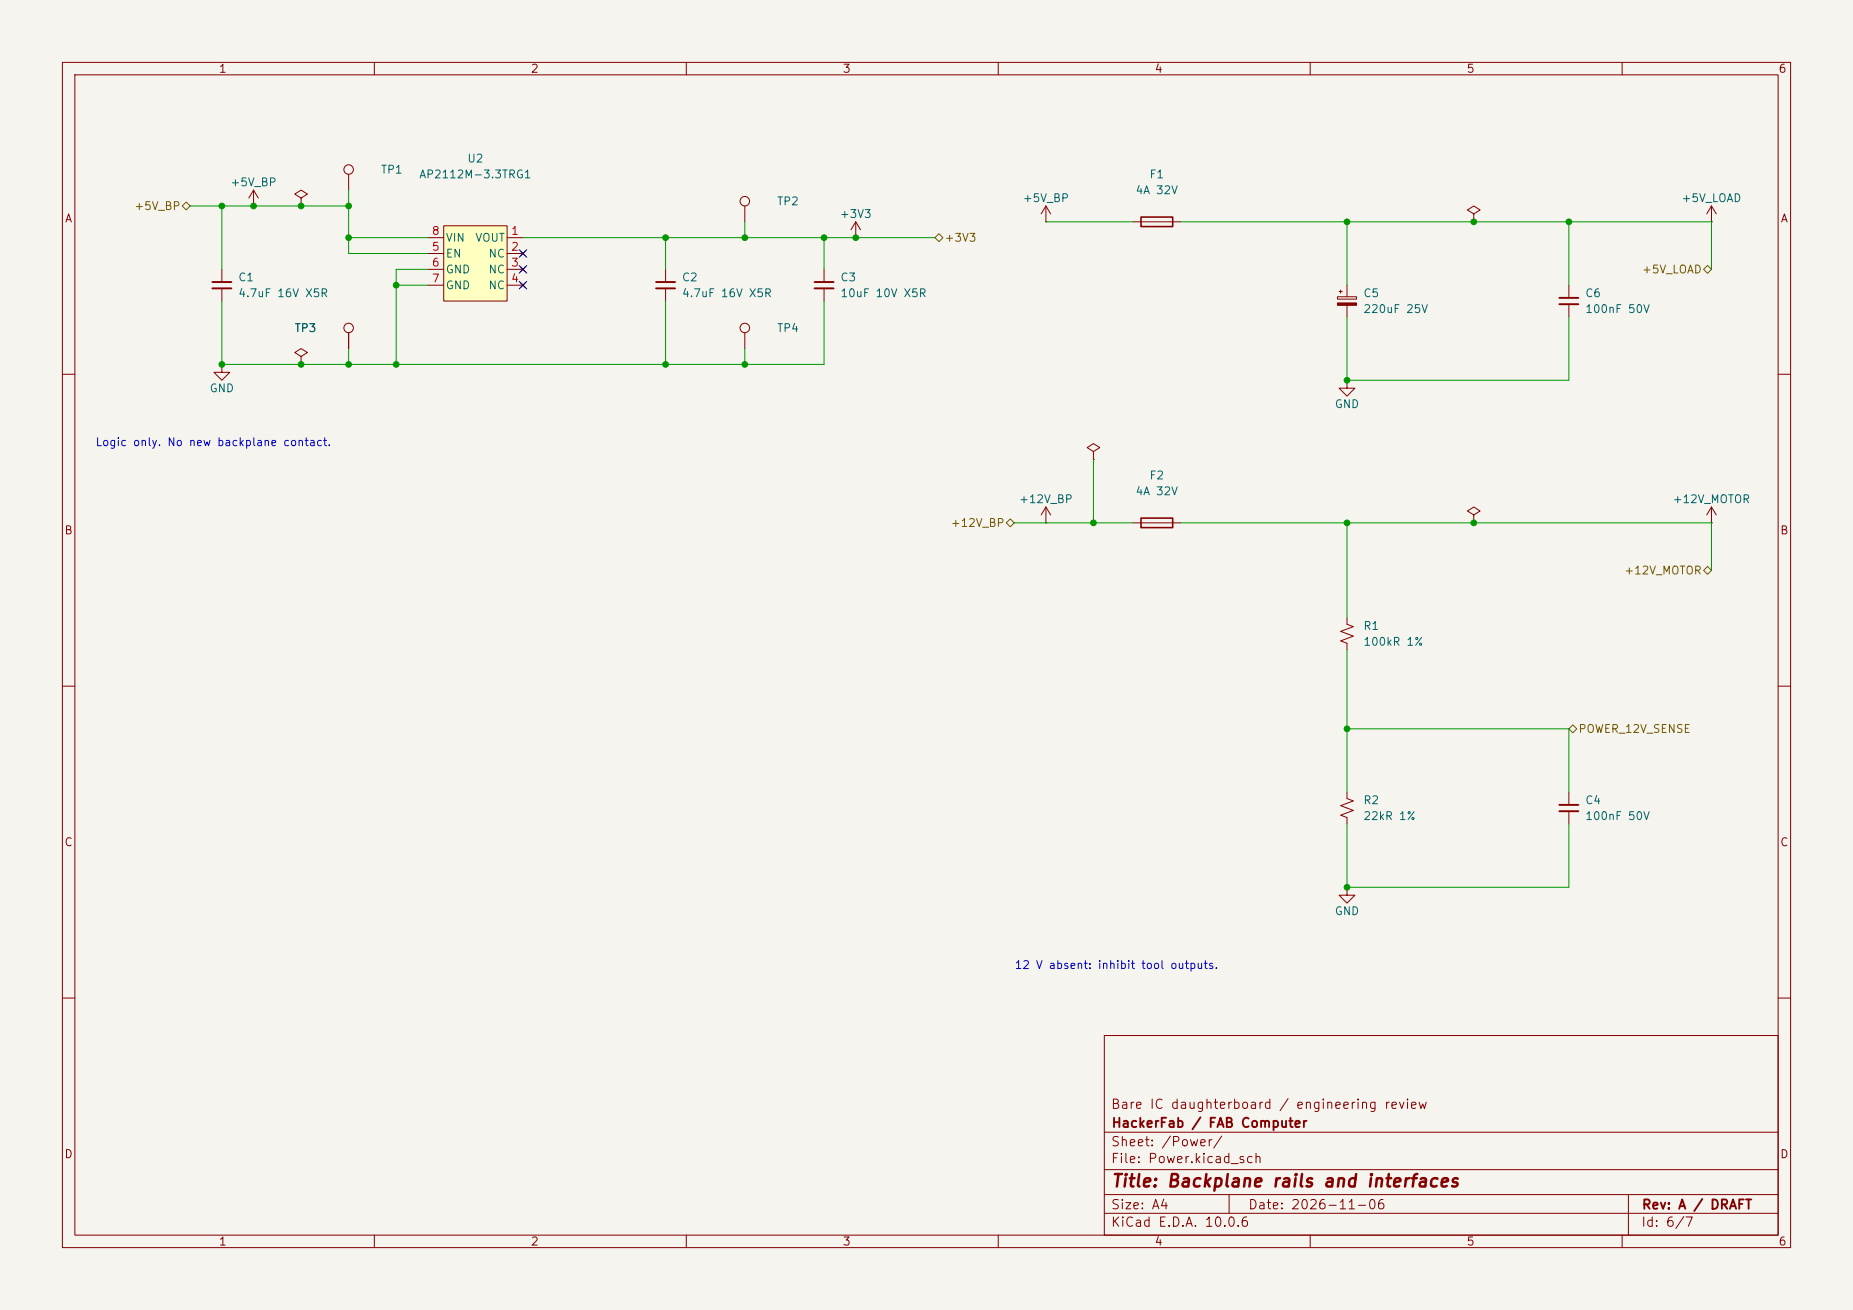
[picture p44: page 6]

Logic only. No new backplane contact. TP3

12 V absent: inhibit tool outputs.

Bare IC daughterboard / engineering review
HackerFab / FAB Computer
Sheet: /Power/
File: Power.kicad_sch
Title: Backplane rails and interfaces

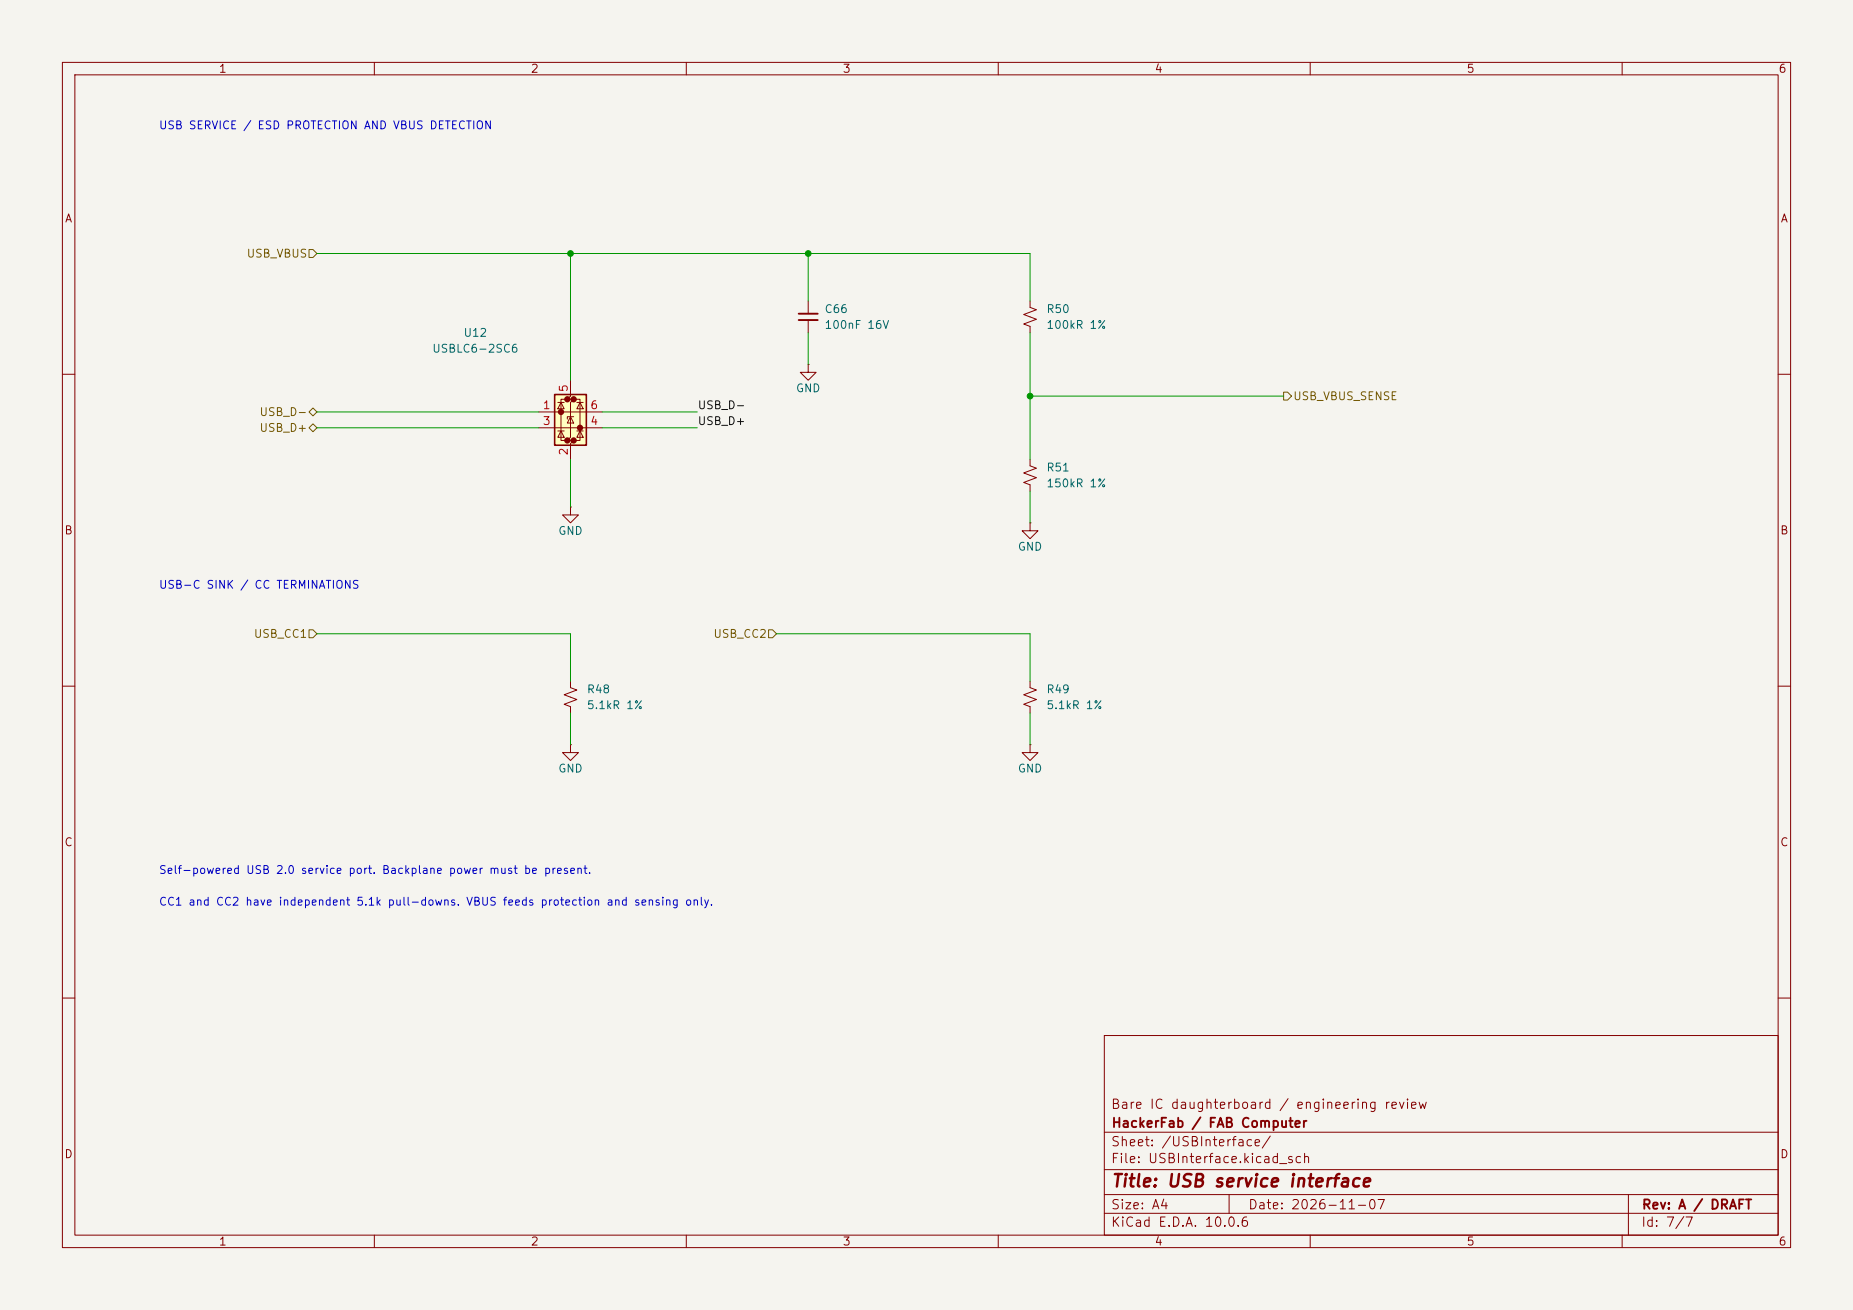
[picture p45: page 7]

USB SERVICE / ESD PROTECTION AND VBUS DETECTION

Self-powered USB 2.0 service port. Backplane power must be present. USB-C SINK / CC TERMINATIONS

CC1 and CC2 have independent 5.1k pull-downs. VBUS feeds protection and sensing only.

Bare IC daughterboard / engineering review
HackerFab / FAB Computer
Sheet: /USBInterface/
File: USBInterface.kicad_sch
Title: USB service interface
