jonahsaunders/fab-computer-hackerfab/daughterboards/micromanipulator/hardware/daughterboard/FabNanoDaughterboard.kicad_pcb

## KiCad design daughterboards/micromanipulator/hardware/daughterboard/FabNanoDaughterboard.kicad_pcb (2026-11-12)

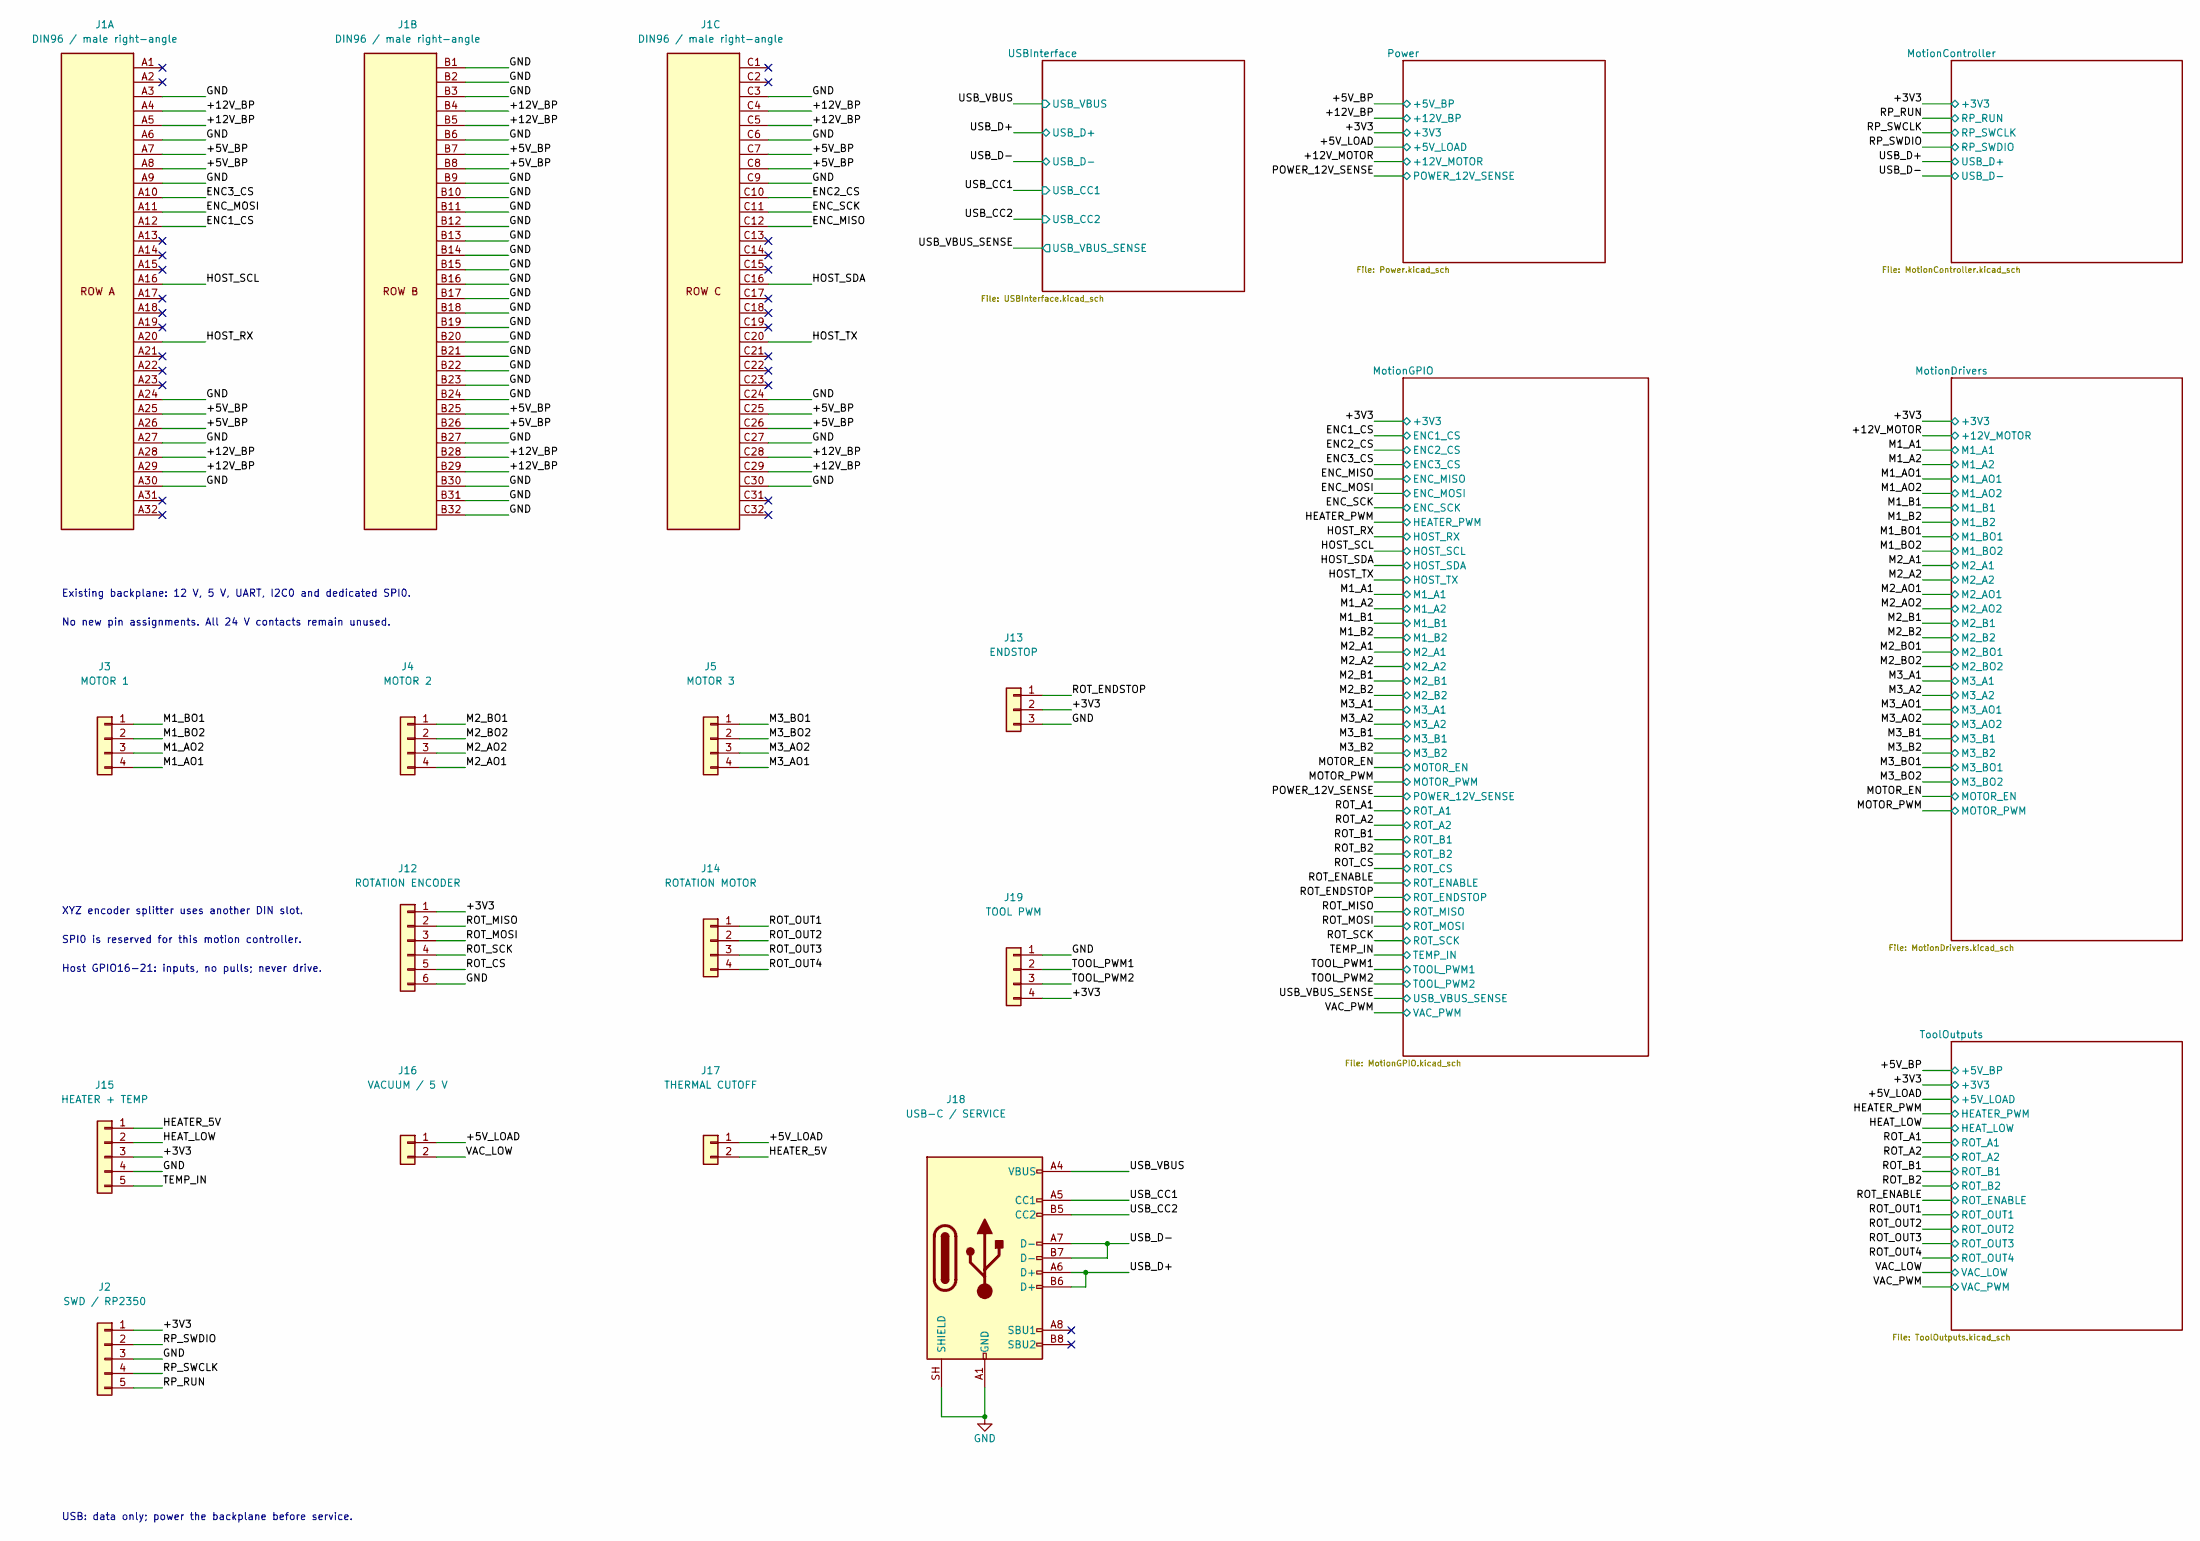
[picture p46: schematic FabNanoDaughterboard.kicad_sch, FAB Nano]

Parts:
J1: DIN96 / male right-angle; DIN96_Male_Horizontal; MPN 9001-11961C00A; LCSC C5173361
J2: SWD / RP2350; PinHeader_1x05_P1.27mm_Vertical; MPN PH1.27-01-05PZD; LCSC C41360740
J3: MOTOR 1; JST_PH_B4B-PH-K_1x04_P2.00mm_Vertical; MPN B4B-PH-K-S(LF)(SN); LCSC C131334
J4: MOTOR 2; JST_PH_B4B-PH-K_1x04_P2.00mm_Vertical; MPN B4B-PH-K-S(LF)(SN); LCSC C131334
J5: MOTOR 3; JST_PH_B4B-PH-K_1x04_P2.00mm_Vertical; MPN B4B-PH-K-S(LF)(SN); LCSC C131334
J12: ROTATION ENCODER; PinHeader_1x06_P2.54mm_Vertical; MPN 2.54-1x6PStraight pin; LCSC C37208
J13: ENDSTOP; JST_PH_B3B-PH-K_1x03_P2.00mm_Vertical; MPN B3B-PH-K-S(LF)(SN); LCSC C131339
J14: ROTATION MOTOR; JST_PH_B4B-PH-K_1x04_P2.00mm_Vertical; MPN B4B-PH-K-S(LF)(SN); LCSC C131334
J15: HEATER + TEMP; JST_PH_B5B-PH-K_1x05_P2.00mm_Vertical; MPN B5B-PH-K-S(LF)(SN); LCSC C157993
J16: VACUUM / 5 V; JST_PH_B2B-PH-K_1x02_P2.00mm_Vertical; MPN B2B-PH-K-S(LF)(SN); LCSC C131337
J17: THERMAL CUTOFF; JST_PH_B2B-PH-K_1x02_P2.00mm_Vertical; MPN B2B-PH-K-S(LF)(SN); LCSC C131337
J18: USB-C / SERVICE; USB_C_Receptacle_HRO_TYPE-C-31-M-12; MPN TYPE-C-31-M-12; LCSC C165948
J19: TOOL PWM; PinHeader_1x04_P1.27mm_Vertical; MPN PH1.27-01-04PZD; LCSC C41360739

Connections:
+3V3: J2.1, J12.1, J13.2, J15.3, J19.4; also elsewhere on the board
+5V_BP: J1.A7, J1.A8, J1.A25, J1.A26, J1.B7, J1.B8, J1.B25, J1.B26, J1.C7, J1.C8, J1.C25, J1.C26; also elsewhere on the board
+5V_LOAD: J16.1, J17.1; also elsewhere on the board
+12V_BP: J1.A4, J1.A5, J1.A28, J1.A29, J1.B4, J1.B5, J1.B28, J1.B29, J1.C4, J1.C5, J1.C28, J1.C29; also elsewhere on the board
/ENC1_CS: J1.A12; also elsewhere on the board
/ENC2_CS: J1.C10; also elsewhere on the board
/ENC3_CS: J1.A10; also elsewhere on the board
/ENC_MISO: J1.C12; also elsewhere on the board
/ENC_MOSI: J1.A11; also elsewhere on the board
/ENC_SCK: J1.C11; also elsewhere on the board
/HEATER_5V: J15.1, J17.2
/HEAT_LOW: J15.2; also elsewhere on the board
/HOST_RX: J1.A20; also elsewhere on the board
/HOST_SCL: J1.A16; also elsewhere on the board
/HOST_SDA: J1.C16; also elsewhere on the board
/HOST_TX: J1.C20; also elsewhere on the board
/M1_AO1: J3.4; also elsewhere on the board
/M1_AO2: J3.3; also elsewhere on the board
/M1_BO1: J3.1; also elsewhere on the board
/M1_BO2: J3.2; also elsewhere on the board
/M2_AO1: J4.4; also elsewhere on the board
/M2_AO2: J4.3; also elsewhere on the board
/M2_BO1: J4.1; also elsewhere on the board
/M2_BO2: J4.2; also elsewhere on the board
/M3_AO1: J5.4; also elsewhere on the board
/M3_AO2: J5.3; also elsewhere on the board
/M3_BO1: J5.1; also elsewhere on the board
/M3_BO2: J5.2; also elsewhere on the board
/ROT_CS: J12.5; also elsewhere on the board
/ROT_ENDSTOP: J13.1; also elsewhere on the board
/ROT_MISO: J12.2; also elsewhere on the board
/ROT_MOSI: J12.3; also elsewhere on the board
/ROT_OUT1: J14.1; also elsewhere on the board
/ROT_OUT2: J14.2; also elsewhere on the board
/ROT_OUT3: J14.3; also elsewhere on the board
/ROT_OUT4: J14.4; also elsewhere on the board
/ROT_SCK: J12.4; also elsewhere on the board
/RP_RUN: J2.5; also elsewhere on the board
/RP_SWCLK: J2.4; also elsewhere on the board
/RP_SWDIO: J2.2; also elsewhere on the board
/TEMP_IN: J15.5; also elsewhere on the board
/TOOL_PWM1: J19.2; also elsewhere on the board
/TOOL_PWM2: J19.3; also elsewhere on the board
/USB_CC1: J18.A5 (CC1); also elsewhere on the board
/USB_CC2: J18.B5 (CC2); also elsewhere on the board
/USB_D+: J18.A6 (D+), J18.B6 (D+); also elsewhere on the board
/USB_D-: J18.A7 (D-), J18.B7 (D-); also elsewhere on the board
/USB_VBUS: J18.A4 (VBUS), J18.A9 (VBUS), J18.B4 (VBUS), J18.B9 (VBUS); also elsewhere on the board
/VAC_LOW: J16.2; also elsewhere on the board
GND: J1.A3, J1.A6, J1.A9, J1.A24, J1.A27, J1.A30, J1.B1, J1.B2, J1.B3, J1.B6, J1.B9, J1.B10, J1.B11, J1.B12, J1.B13, J1.B14, J1.B15, J1.B16, J1.B17, J1.B18, J1.B19, J1.B20, J1.B21, J1.B22, J1.B23, J1.B24, J1.B27, J1.B30, J1.B31, J1.B32, J1.C3, J1.C6, J1.C9, J1.C24, J1.C27, J1.C30, J2.3, J12.6, J13.3, J15.4, J18.A1 (GND), J18.A12 (GND), J18.B1 (GND), J18.B12 (GND), J18.SH (SHIELD), J19.1; also elsewhere on the board

Notes on the sheet:
Existing backplane: 12 V, 5 V, UART, I2C0 and dedicated SPI0.
No new pin assignments. All 24 V contacts remain unused.
USB: data only; power the backplane before service.
XYZ encoder splitter uses another DIN slot.
SPI0 is reserved for this motion controller.
Host GPIO16-21: inputs, no pulls; never drive.

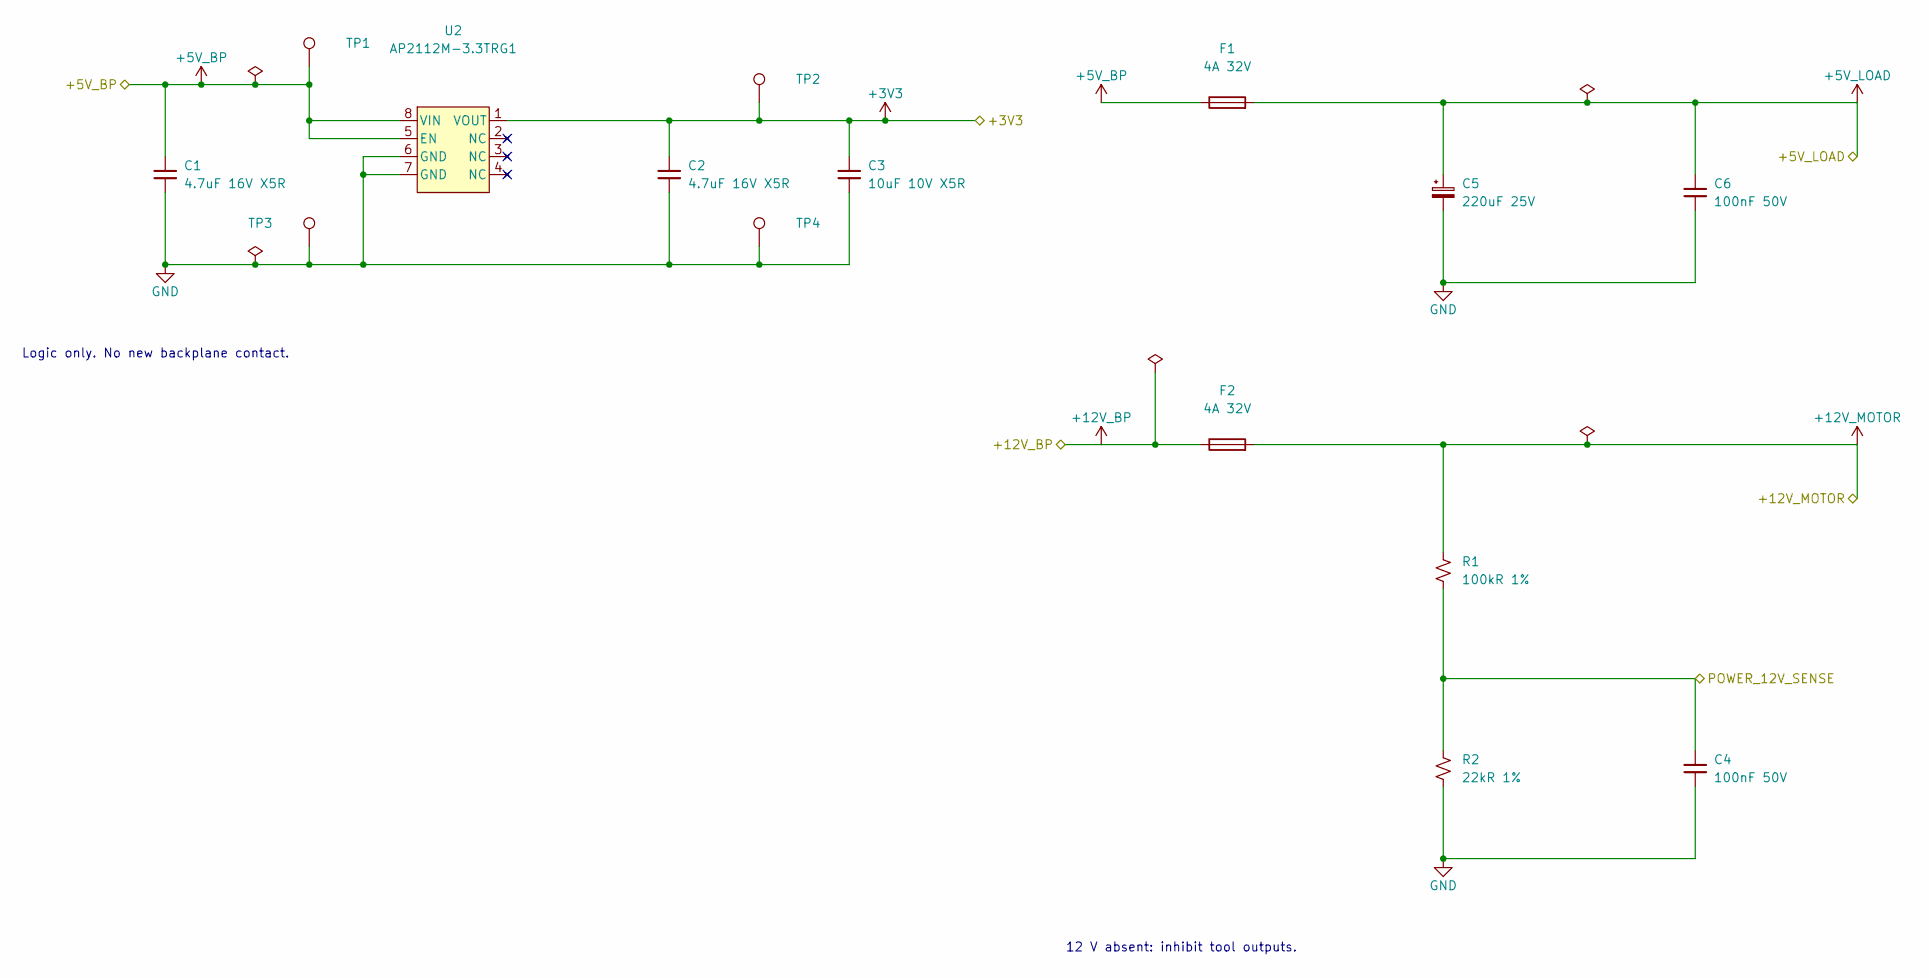
[picture p47: schematic Power.kicad_sch, Backplane rails and interfaces]

Parts:
C1, C2: 4.7uF 16V X5R; C_0603_1608Metric; MPN CL10A475KO8NNNC; LCSC C19666
C3: 10uF 10V X5R; C_0603_1608Metric; MPN CL10A106KP8NNNC; LCSC C19702
C4, C6: 100nF 50V; C_0603_1608Metric; MPN CC0603KRX7R9BB104; LCSC C14663
C5: 220uF 25V; CP_Elec_6.3x7.7; MPN 217EC0037; LCSC C42371908
F1, F2: 4A 32V; Fuse_Littelfuse_0466_1206; MPN 0466004.NRHF; LCSC C187596
R1: 100kR 1%; R_0603_1608Metric; MPN 0603WAF1003T5E; LCSC C25803
R2: 22kR 1%; R_0603_1608Metric; MPN 0603WAF2202T5E; LCSC C31850
TP1: 5V; TestPoint_Pad_D0.8mm
TP2: 3V3; TestPoint_Pad_D0.8mm
TP3, TP4: GND; TestPoint_Pad_D0.8mm
U2: AP2112M-3.3TRG1; SOIC-8_3.9x4.9mm_P1.27mm; MPN AP2112M-3.3TRG1; LCSC C5290219

Connections:
+3V3: C2.1, C3.1, TP2.1, U2.1 (VOUT); also elsewhere on the board
+5V_BP: C1.1, F1.1, TP1.1, U2.5 (EN), U2.8 (VIN); also elsewhere on the board
+5V_LOAD: C5.1, C6.1, F1.2; also elsewhere on the board
+12V_BP: F2.1; also elsewhere on the board
+12V_MOTOR: F2.2, R1.1; also elsewhere on the board
/POWER_12V_SENSE: C4.1, R1.2, R2.1; also elsewhere on the board
GND: C1.2, C2.2, C3.2, C4.2, C5.2, C6.2, R2.2, TP3.1, TP4.1, U2.6 (GND), U2.7 (GND); also elsewhere on the board

Notes on the sheet:
Logic only. No new backplane contact.
12 V absent: inhibit tool outputs.

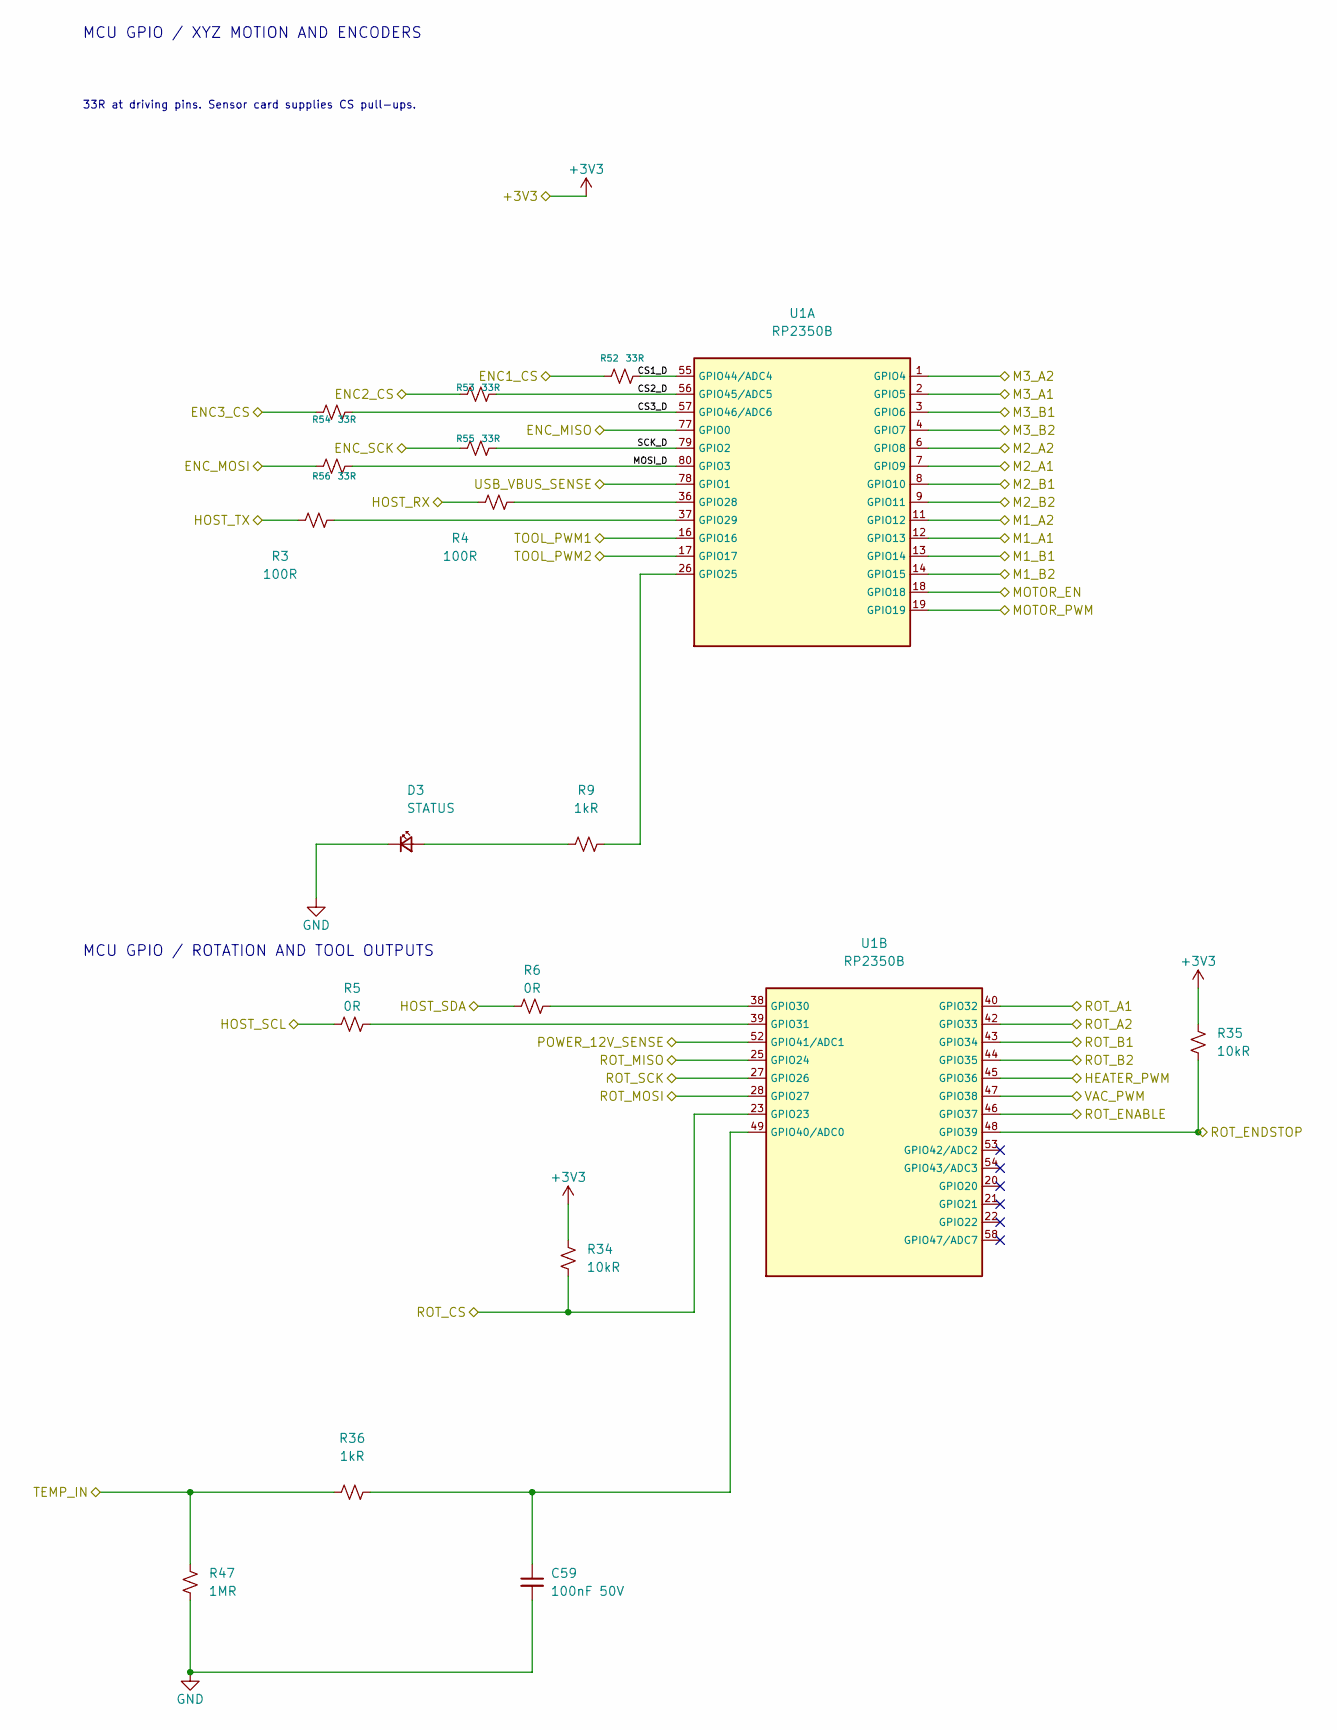
[picture p48: schematic MotionGPIO.kicad_sch, RP2350B / GPIO and interfaces]

Parts:
C59: 100nF 50V; C_0603_1608Metric; MPN CC0603KRX7R9BB104; LCSC C14663
D3: STATUS; LED_0603_1608Metric; MPN LTST-C190KGKT; LCSC C125094
R3, R4: 100R; R_0603_1608Metric; MPN 0603WAF1000T5E; LCSC C22775
R5, R6: 0R; R_0603_1608Metric; MPN 0603WAF0000T5E; LCSC C21189
R9, R36: 1kR; R_0603_1608Metric; MPN 0603WAF1001T5E; LCSC C21190
R34, R35: 10kR; R_0603_1608Metric; MPN 0603WAF1002T5E; LCSC C25804
R47: 1MR; R_0603_1608Metric; MPN 0603WAF1004T5E; LCSC C22935
R52, R53, R54, R55, R56: 33R; R_0402_1005Metric; MPN 0402WGF330JTCE; LCSC C25105
U1: RP2350B; QFN-80-1EP_10x10mm_P0.4mm_EP3.4x3.4mm; MPN RP2350B A4; LCSC C9900208890

Connections:
+3V3: R34.1, R35.1; also elsewhere on the board
/ENC1_CS: R52.2; also elsewhere on the board
/ENC2_CS: R53.2; also elsewhere on the board
/ENC3_CS: R54.2; also elsewhere on the board
/ENC_MISO: U1.77 (GPIO0); also elsewhere on the board
/ENC_MOSI: R56.2; also elsewhere on the board
/ENC_SCK: R55.2; also elsewhere on the board
/HEATER_PWM: U1.45 (GPIO36); also elsewhere on the board
/HOST_RX: R4.2; also elsewhere on the board
/HOST_SCL: R5.1; also elsewhere on the board
/HOST_SDA: R6.1; also elsewhere on the board
/HOST_TX: R3.1; also elsewhere on the board
/M1_A1: U1.12 (GPIO13); also elsewhere on the board
/M1_A2: U1.11 (GPIO12); also elsewhere on the board
/M1_B1: U1.13 (GPIO14); also elsewhere on the board
/M1_B2: U1.14 (GPIO15); also elsewhere on the board
/M2_A1: U1.7 (GPIO9); also elsewhere on the board
/M2_A2: U1.6 (GPIO8); also elsewhere on the board
/M2_B1: U1.8 (GPIO10); also elsewhere on the board
/M2_B2: U1.9 (GPIO11); also elsewhere on the board
/M3_A1: U1.2 (GPIO5); also elsewhere on the board
/M3_A2: U1.1 (GPIO4); also elsewhere on the board
/M3_B1: U1.3 (GPIO6); also elsewhere on the board
/M3_B2: U1.4 (GPIO7); also elsewhere on the board
/MOTOR_EN: U1.18 (GPIO18); also elsewhere on the board
/MOTOR_PWM: U1.19 (GPIO19); also elsewhere on the board
/MotionGPIO/CS1_D: R52.1, U1.55 (GPIO44/ADC4)
/MotionGPIO/CS2_D: R53.1, U1.56 (GPIO45/ADC5)
/MotionGPIO/CS3_D: R54.1, U1.57 (GPIO46/ADC6)
/MotionGPIO/MOSI_D: R56.1, U1.80 (GPIO3)
/MotionGPIO/SCK_D: R55.1, U1.79 (GPIO2)
/POWER_12V_SENSE: U1.52 (GPIO41/ADC1); also elsewhere on the board
/ROT_A1: U1.40 (GPIO32); also elsewhere on the board
/ROT_A2: U1.42 (GPIO33); also elsewhere on the board
/ROT_B1: U1.43 (GPIO34); also elsewhere on the board
/ROT_B2: U1.44 (GPIO35); also elsewhere on the board
/ROT_CS: R34.2, U1.23 (GPIO23); also elsewhere on the board
/ROT_ENABLE: U1.46 (GPIO37); also elsewhere on the board
/ROT_ENDSTOP: R35.2, U1.48 (GPIO39); also elsewhere on the board
/ROT_MISO: U1.25 (GPIO24); also elsewhere on the board
/ROT_MOSI: U1.28 (GPIO27); also elsewhere on the board
/ROT_SCK: U1.27 (GPIO26); also elsewhere on the board
/TEMP_IN: R36.1, R47.1; also elsewhere on the board
/TOOL_PWM1: U1.16 (GPIO16); also elsewhere on the board
/TOOL_PWM2: U1.17 (GPIO17); also elsewhere on the board
/USB_VBUS_SENSE: U1.78 (GPIO1); also elsewhere on the board
/VAC_PWM: U1.47 (GPIO38); also elsewhere on the board
GND: C59.2, D3.1 (K), R47.2; also elsewhere on the board
unnamed: D3.2 (A), R9.2
unnamed: R9.1, U1.26 (GPIO25)
unnamed: R4.1, U1.36 (GPIO28)
unnamed: R3.2, U1.37 (GPIO29)
unnamed: R6.2, U1.38 (GPIO30)
unnamed: R5.2, U1.39 (GPIO31)
unnamed: C59.1, R36.2, U1.49 (GPIO40/ADC0)

Notes on the sheet:
MCU GPIO / XYZ MOTION AND ENCODERS
MCU GPIO / ROTATION AND TOOL OUTPUTS
33R at driving pins. Sensor card supplies CS pull-ups.

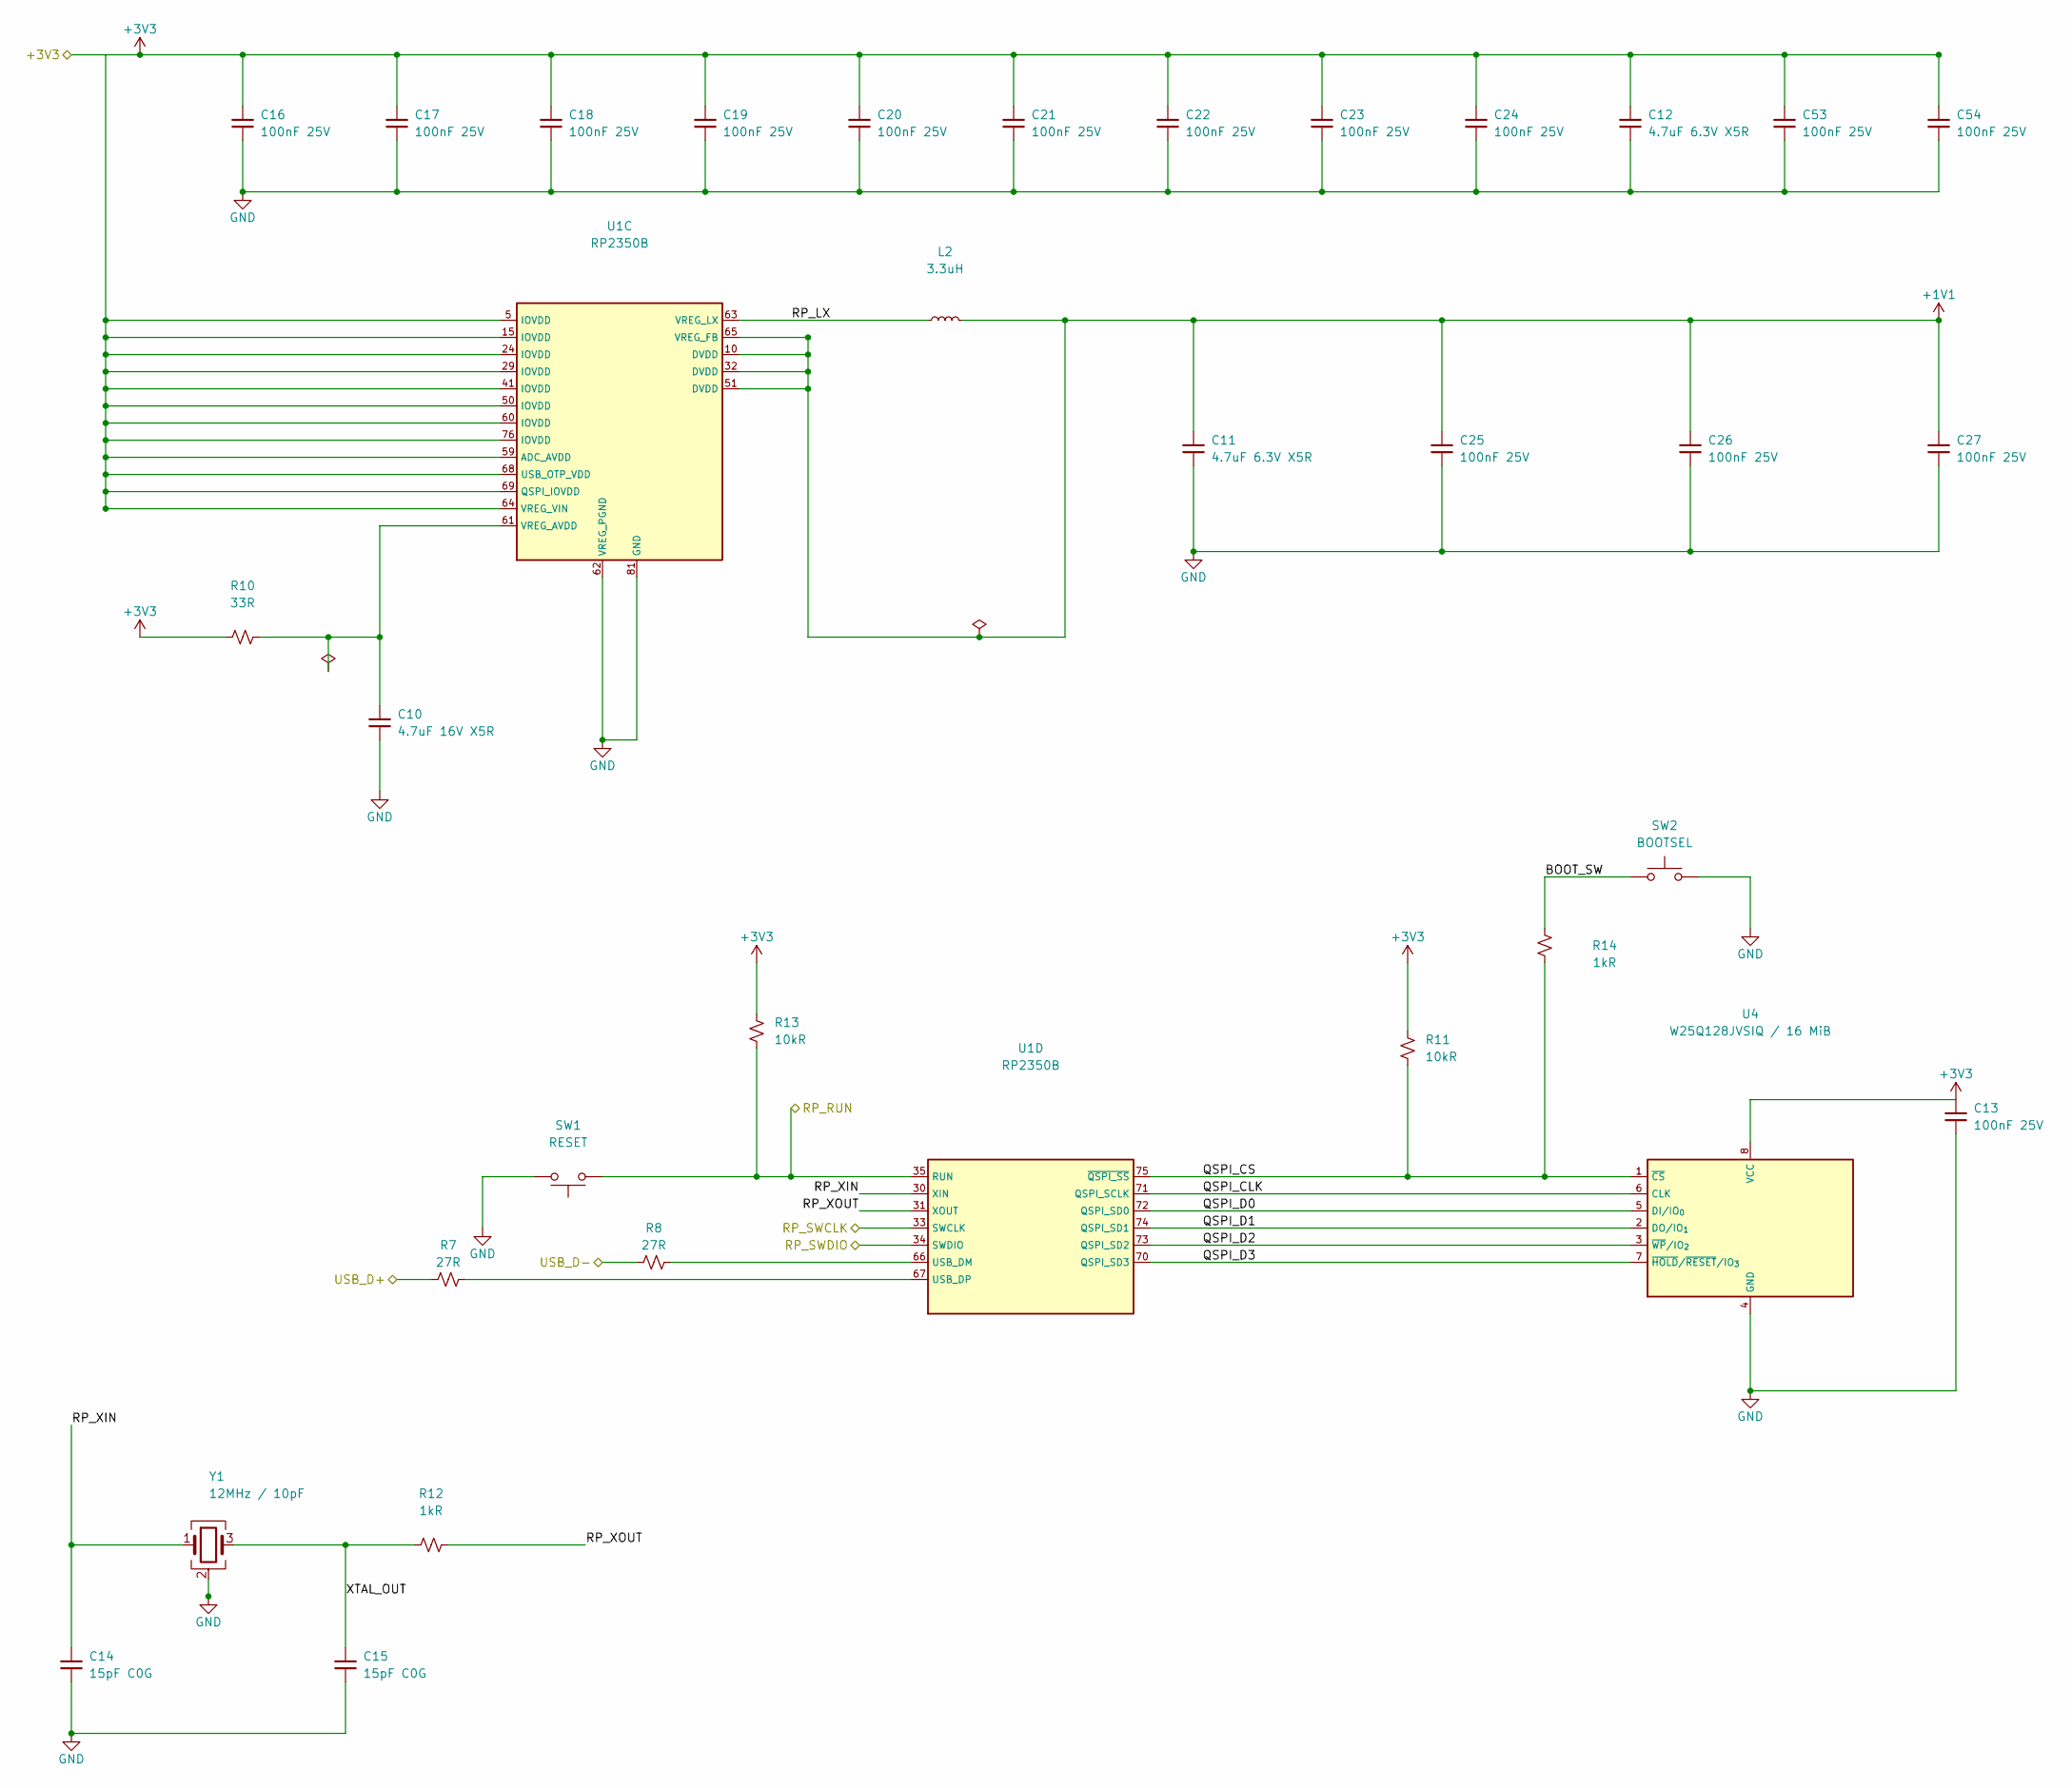
[picture p49: schematic MotionController.kicad_sch, RP2350B]

Parts:
C10: 4.7uF 16V X5R; C_0603_1608Metric; MPN CL10A475KO8NNNC; LCSC C19666
C11, C12: 4.7uF 6.3V X5R; C_0402_RP2350_Regulator; MPN GRM155R60J475ME47D; LCSC C82453
C13, C16, C17, C18, C19, C20, C21, C22, C23, C24, C25, C26, C27, C53, C54: 100nF 25V; C_0402_1005Metric; MPN CL05B104KA5NNNC; LCSC C155422
C14, C15: 15pF C0G; C_0402_1005Metric; MPN 0402CG150J500NT; LCSC C1548
L2: 3.3uH; L_Murata_DFE252012F_2.5x2.0mm; MPN DFE252012F-3R3M=P2; LCSC C2041573
R7, R8: 27R; R_0201_Yageo_Reflow; MPN RC0201FR-0727RL; LCSC C273268
R10: 33R; R_0402_1005Metric; MPN 0402WGF330JTCE; LCSC C25105
R11, R13: 10kR; R_0402_1005Metric; MPN 0402WGF1002TCE; LCSC C25744
R12, R14: 1kR; R_0402_1005Metric; MPN 0402WGF1001TCE; LCSC C11702
SW1: RESET; SW_SPST_TL3305A; MPN TL3305AF160QG; LCSC C2886899
SW2: BOOTSEL; SW_SPST_TL3305A; MPN TL3305AF160QG; LCSC C2886899
U1: RP2350B; QFN-80-1EP_10x10mm_P0.4mm_EP3.4x3.4mm; MPN RP2350B A4; LCSC C9900208890
U4: W25Q128JVSIQ / 16 MiB; SOIC-8_5.3x5.3mm_P1.27mm; MPN W25Q128JVSIQ; LCSC C97521
Y1: 12MHz / 10pF; Crystal_SMD_3225-4Pin_3.2x2.5mm; MPN ABM8-272-T3; LCSC C20625731

Connections:
+1V1: C11.1, C25.1, C26.1, C27.1, L2.2, U1.10 (DVDD), U1.32 (DVDD), U1.51 (DVDD), U1.65 (VREG_FB)
+3V3: C12.1, C13.1, C16.1, C17.1, C18.1, C19.1, C20.1, C21.1, C22.1, C23.1, C24.1, C53.1, C54.1, R10.1, R11.1, R13.1, U1.5 (IOVDD), U1.15 (IOVDD), U1.24 (IOVDD), U1.29 (IOVDD), U1.41 (IOVDD), U1.50 (IOVDD), U1.59 (ADC_AVDD), U1.60 (IOVDD), U1.64 (VREG_VIN), U1.68 (USB_OTP_VDD), U1.69 (QSPI_IOVDD), U1.76 (IOVDD), U4.8 (VCC); also elsewhere on the board
/MotionController/BOOT_SW: R14.2, SW2.1
/MotionController/QSPI_CLK: U1.71 (QSPI_SCLK), U4.6 (CLK)
/MotionController/QSPI_CS: R11.2, R14.1, U1.75 (~QSPI_SS), U4.1 (~CS)
/MotionController/QSPI_D0: U1.72 (QSPI_SD0), U4.5 (DI/IO_{0})
/MotionController/QSPI_D1: U1.74 (QSPI_SD1), U4.2 (DO/IO_{1})
/MotionController/QSPI_D2: U1.73 (QSPI_SD2), U4.3 (~WP/IO_{2})
/MotionController/QSPI_D3: U1.70 (QSPI_SD3), U4.7 (~HOLD/~RESET/IO_{3})
/MotionController/RP_LX: L2.1, U1.63 (VREG_LX)
/MotionController/RP_XIN: C14.1, U1.30 (XIN), Y1.1
/MotionController/RP_XOUT: R12.1, U1.31 (XOUT)
/MotionController/XTAL_OUT: C15.1, R12.2, Y1.3
/RP_RUN: R13.2, SW1.1, U1.35 (RUN); also elsewhere on the board
/RP_SWCLK: U1.33 (SWCLK); also elsewhere on the board
/RP_SWDIO: U1.34 (SWDIO); also elsewhere on the board
/USB_D+: R7.2; also elsewhere on the board
/USB_D-: R8.2; also elsewhere on the board
GND: C10.2, C11.2, C12.2, C13.2, C14.2, C15.2, C16.2, C17.2, C18.2, C19.2, C20.2, C21.2, C22.2, C23.2, C24.2, C25.2, C26.2, C27.2, C53.2, C54.2, SW1.2, SW2.2, U1.62 (VREG_PGND), U1.81 (GND), U4.4 (GND), Y1.2 (G), Y1.4 (G); also elsewhere on the board
unnamed: C10.1, R10.2, U1.61 (VREG_AVDD)
unnamed: R8.1, U1.66 (USB_DM)
unnamed: R7.1, U1.67 (USB_DP)

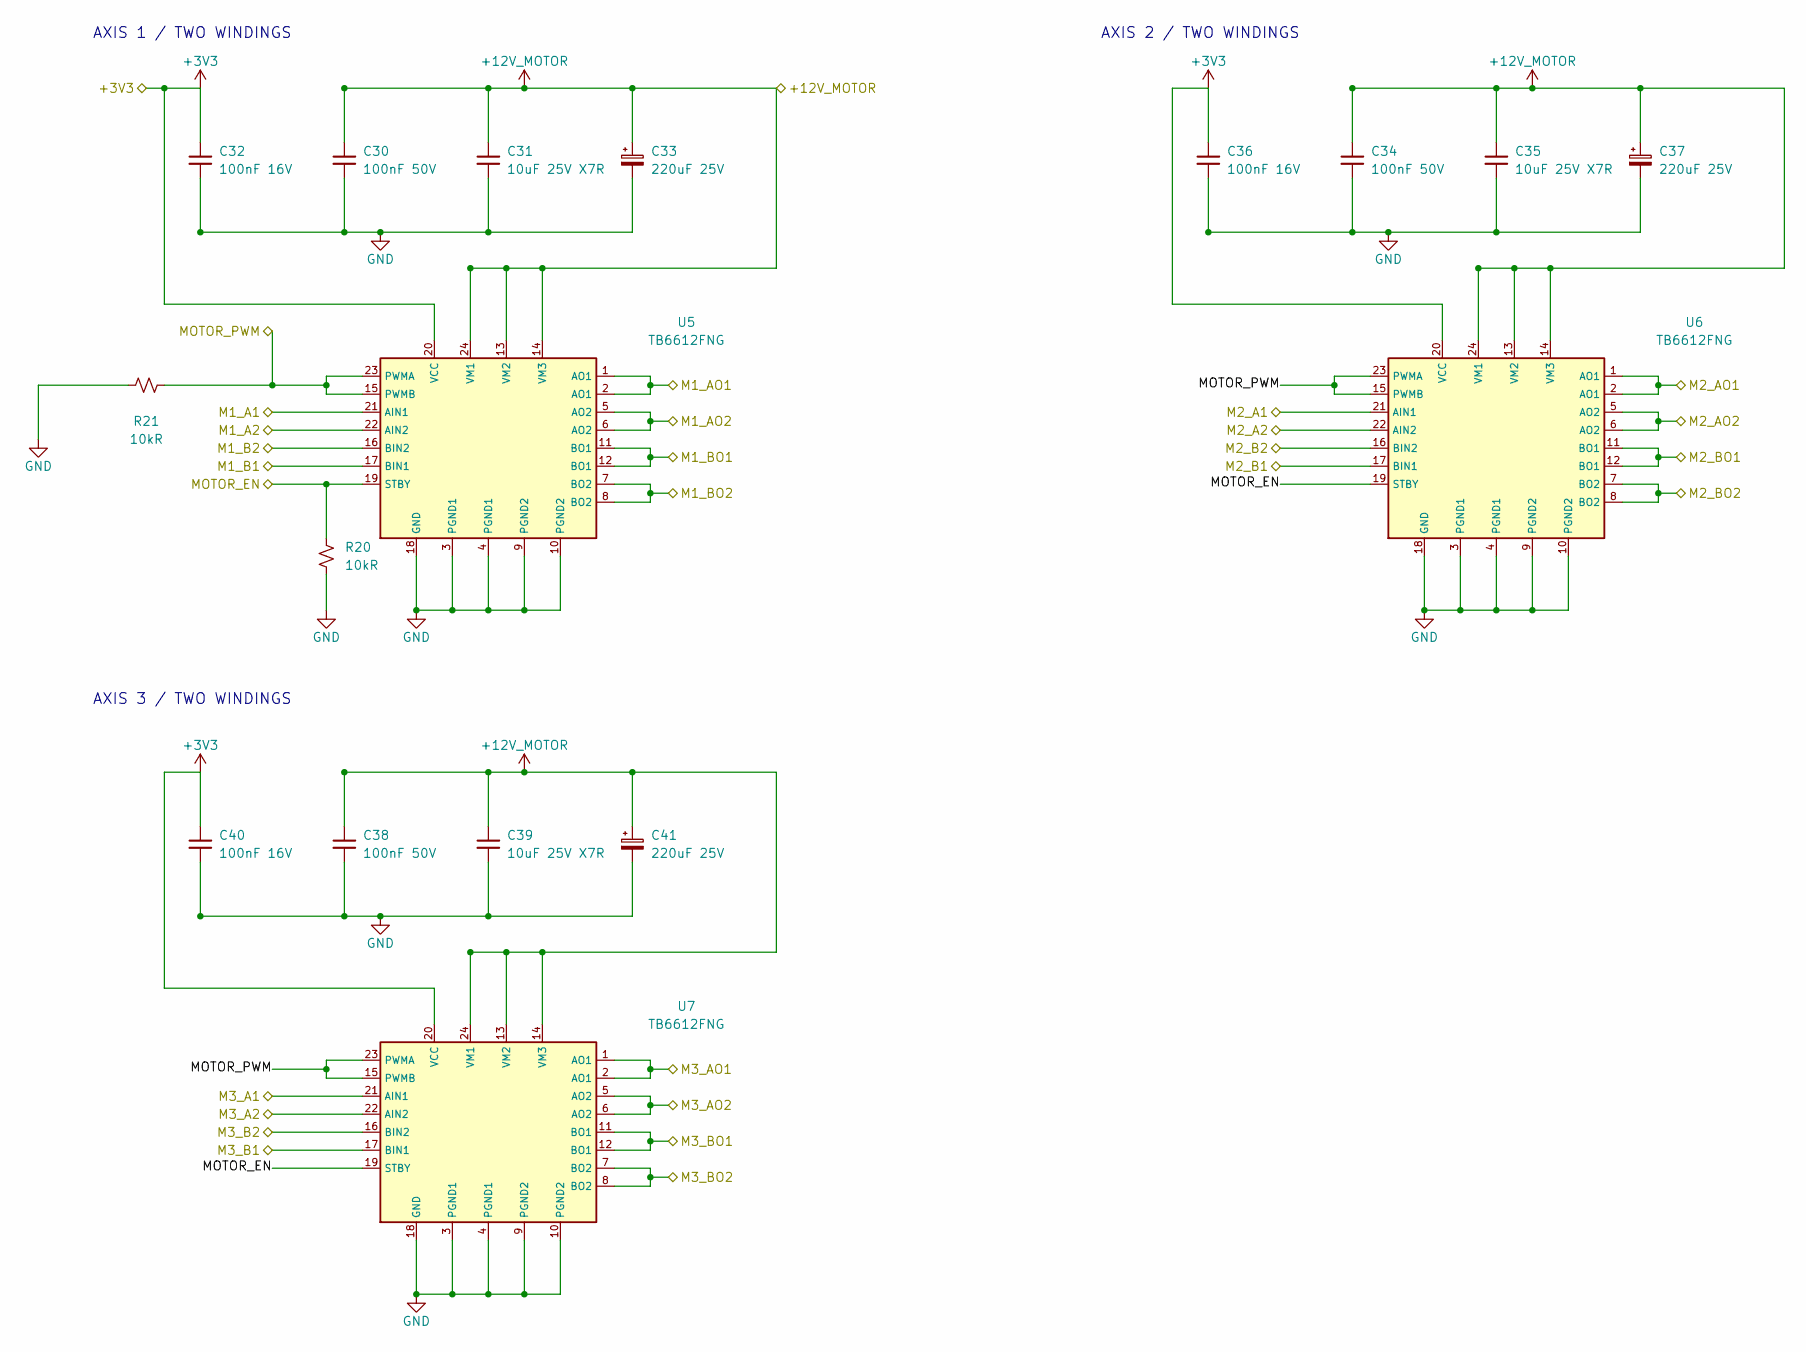
[picture p50: schematic MotionDrivers.kicad_sch, XYZ winding drivers]

Parts:
C30, C34, C38: 100nF 50V; C_0603_1608Metric; MPN CC0603KRX7R9BB104; LCSC C14663
C31, C35, C39: 10uF 25V X7R; C_0805_2012Metric; MPN C0805X7R106K250NT; LCSC C2835529
C32, C36, C40: 100nF 16V; C_0402_1005Metric; MPN CL05B104KO5NNNC; LCSC C1525
C33, C37, C41: 220uF 25V; CP_Elec_6.3x7.7; MPN 217EC0037; LCSC C42371908
R20, R21: 10kR; R_0603_1608Metric; MPN 0603WAF1002T5E; LCSC C25804
U5, U6, U7: TB6612FNG; SSOP-24_Toshiba_5.6x7.8mm_P0.65mm; MPN TB6612FNG(O,C,8,EL; LCSC C88224

Connections:
+3V3: C32.1, C36.1, C40.1, U5.20 (VCC), U6.20 (VCC), U7.20 (VCC); also elsewhere on the board
+12V_MOTOR: C30.1, C31.1, C33.1, C34.1, C35.1, C37.1, C38.1, C39.1, C41.1, U5.13 (VM2), U5.14 (VM3), U5.24 (VM1), U6.13 (VM2), U6.14 (VM3), U6.24 (VM1), U7.13 (VM2), U7.14 (VM3), U7.24 (VM1); also elsewhere on the board
/M1_A1: U5.21 (AIN1); also elsewhere on the board
/M1_A2: U5.22 (AIN2); also elsewhere on the board
/M1_AO1: U5.1 (AO1), U5.2 (AO1); also elsewhere on the board
/M1_AO2: U5.5 (AO2), U5.6 (AO2); also elsewhere on the board
/M1_B1: U5.17 (BIN1); also elsewhere on the board
/M1_B2: U5.16 (BIN2); also elsewhere on the board
/M1_BO1: U5.11 (BO1), U5.12 (BO1); also elsewhere on the board
/M1_BO2: U5.7 (BO2), U5.8 (BO2); also elsewhere on the board
/M2_A1: U6.21 (AIN1); also elsewhere on the board
/M2_A2: U6.22 (AIN2); also elsewhere on the board
/M2_AO1: U6.1 (AO1), U6.2 (AO1); also elsewhere on the board
/M2_AO2: U6.5 (AO2), U6.6 (AO2); also elsewhere on the board
/M2_B1: U6.17 (BIN1); also elsewhere on the board
/M2_B2: U6.16 (BIN2); also elsewhere on the board
/M2_BO1: U6.11 (BO1), U6.12 (BO1); also elsewhere on the board
/M2_BO2: U6.7 (BO2), U6.8 (BO2); also elsewhere on the board
/M3_A1: U7.21 (AIN1); also elsewhere on the board
/M3_A2: U7.22 (AIN2); also elsewhere on the board
/M3_AO1: U7.1 (AO1), U7.2 (AO1); also elsewhere on the board
/M3_AO2: U7.5 (AO2), U7.6 (AO2); also elsewhere on the board
/M3_B1: U7.17 (BIN1); also elsewhere on the board
/M3_B2: U7.16 (BIN2); also elsewhere on the board
/M3_BO1: U7.11 (BO1), U7.12 (BO1); also elsewhere on the board
/M3_BO2: U7.7 (BO2), U7.8 (BO2); also elsewhere on the board
/MOTOR_EN: R20.1, U5.19 (STBY), U6.19 (STBY), U7.19 (STBY); also elsewhere on the board
/MOTOR_PWM: R21.1, U5.15 (PWMB), U5.23 (PWMA), U6.15 (PWMB), U6.23 (PWMA), U7.15 (PWMB), U7.23 (PWMA); also elsewhere on the board
GND: C30.2, C31.2, C32.2, C33.2, C34.2, C35.2, C36.2, C37.2, C38.2, C39.2, C40.2, C41.2, R20.2, R21.2, U5.3 (PGND1), U5.4 (PGND1), U5.9 (PGND2), U5.10 (PGND2), U5.18 (GND), U6.3 (PGND1), U6.4 (PGND1), U6.9 (PGND2), U6.10 (PGND2), U6.18 (GND), U7.3 (PGND1), U7.4 (PGND1), U7.9 (PGND2), U7.10 (PGND2), U7.18 (GND); also elsewhere on the board

Notes on the sheet:
AXIS 1 / TWO WINDINGS
AXIS 2 / TWO WINDINGS
AXIS 3 / TWO WINDINGS
