jonahsaunders/fab-computer-hackerfab/daughterboards/micromanipulator/hardware/daughterboard/FabNanoDaughterboard.kicad_pcb

## KiCad design daughterboards/micromanipulator/hardware/daughterboard/FabNanoDaughterboard.kicad_pcb (continued)

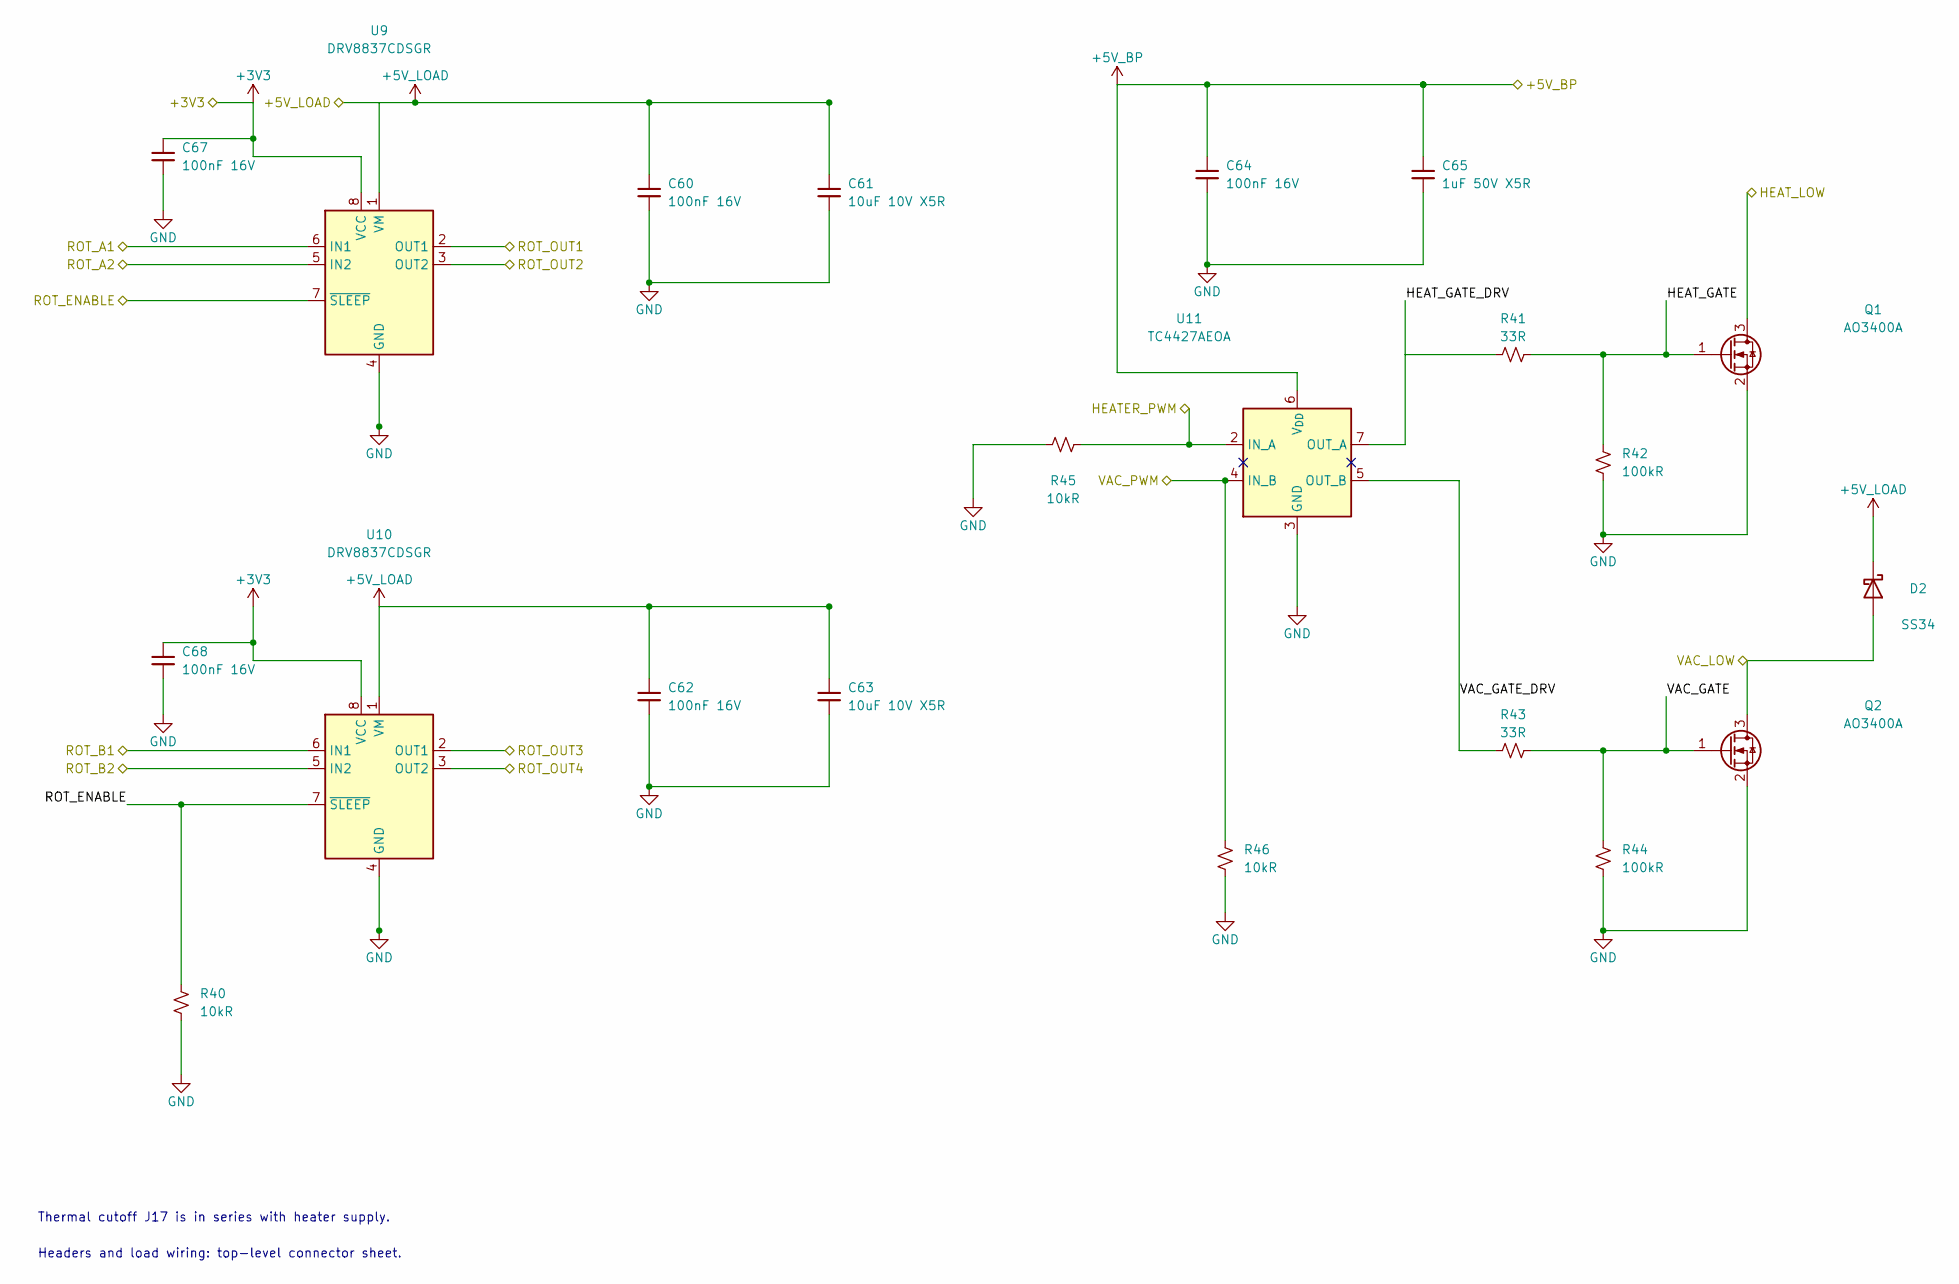
[picture p51: schematic ToolOutputs.kicad_sch, Rotation, heater and vacuum]

Parts:
C60, C62, C64, C67, C68: 100nF 16V; C_0402_1005Metric; MPN CL05B104KO5NNNC; LCSC C1525
C61, C63: 10uF 10V X5R; C_0603_1608Metric; MPN CL10A106KP8NNNC; LCSC C19702
C65: 1uF 50V X5R; C_0603_1608Metric; MPN CL10A105KB8NNNC; LCSC C15849
D2: SS34; D_SMA; MPN SS34; LCSC C8678
Q1, Q2: AO3400A; SOT-23; MPN AO3400A; LCSC C20917
R40, R45, R46: 10kR; R_0603_1608Metric; MPN 0603WAF1002T5E; LCSC C25804
R41, R43: 33R; R_0603_1608Metric; MPN 0603WAF330JT5E; LCSC C23140
R42, R44: 100kR; R_0603_1608Metric; MPN 0603WAF1003T5E; LCSC C25803
U9, U10: DRV8837CDSGR; Texas_DSG0008A_WSON-8-1EP_2x2mm_P0.5mm_EP0.9x1.6mm; MPN DRV8837CDSGR; LCSC C191000
U11: TC4427AEOA; SOIC-8_3.9x4.9mm_P1.27mm; MPN TC4427AEOA; LCSC C18690

Connections:
+3V3: C67.1, C68.1, U9.8 (VCC), U10.8 (VCC); also elsewhere on the board
+5V_BP: C64.1, C65.1, U11.6 (V_{DD}); also elsewhere on the board
+5V_LOAD: C60.1, C61.1, C62.1, C63.1, D2.1 (K), U9.1 (VM), U10.1 (VM); also elsewhere on the board
/HEATER_PWM: R45.1, U11.2 (IN_A); also elsewhere on the board
/HEAT_LOW: Q1.3 (D); also elsewhere on the board
/ROT_A1: U9.6 (IN1); also elsewhere on the board
/ROT_A2: U9.5 (IN2); also elsewhere on the board
/ROT_B1: U10.6 (IN1); also elsewhere on the board
/ROT_B2: U10.5 (IN2); also elsewhere on the board
/ROT_ENABLE: R40.1, U9.7 (~SLEEP), U10.7 (~SLEEP); also elsewhere on the board
/ROT_OUT1: U9.2 (OUT1); also elsewhere on the board
/ROT_OUT2: U9.3 (OUT2); also elsewhere on the board
/ROT_OUT3: U10.2 (OUT1); also elsewhere on the board
/ROT_OUT4: U10.3 (OUT2); also elsewhere on the board
/ToolOutputs/HEAT_GATE: Q1.1 (G), R41.2, R42.1
/ToolOutputs/HEAT_GATE_DRV: R41.1, U11.7 (OUT_A)
/ToolOutputs/VAC_GATE: Q2.1 (G), R43.2, R44.1
/ToolOutputs/VAC_GATE_DRV: R43.1, U11.5 (OUT_B)
/VAC_LOW: D2.2 (A), Q2.3 (D); also elsewhere on the board
/VAC_PWM: R46.1, U11.4 (IN_B); also elsewhere on the board
GND: C60.2, C61.2, C62.2, C63.2, C64.2, C65.2, C67.2, C68.2, Q1.2 (S), Q2.2 (S), R40.2, R42.2, R44.2, R45.2, R46.2, U9.4 (GND), U9.9 (GND), U10.4 (GND), U10.9 (GND), U11.3 (GND); also elsewhere on the board

Notes on the sheet:
Thermal cutoff J17 is in series with heater supply.
Headers and load wiring: top-level connector sheet.

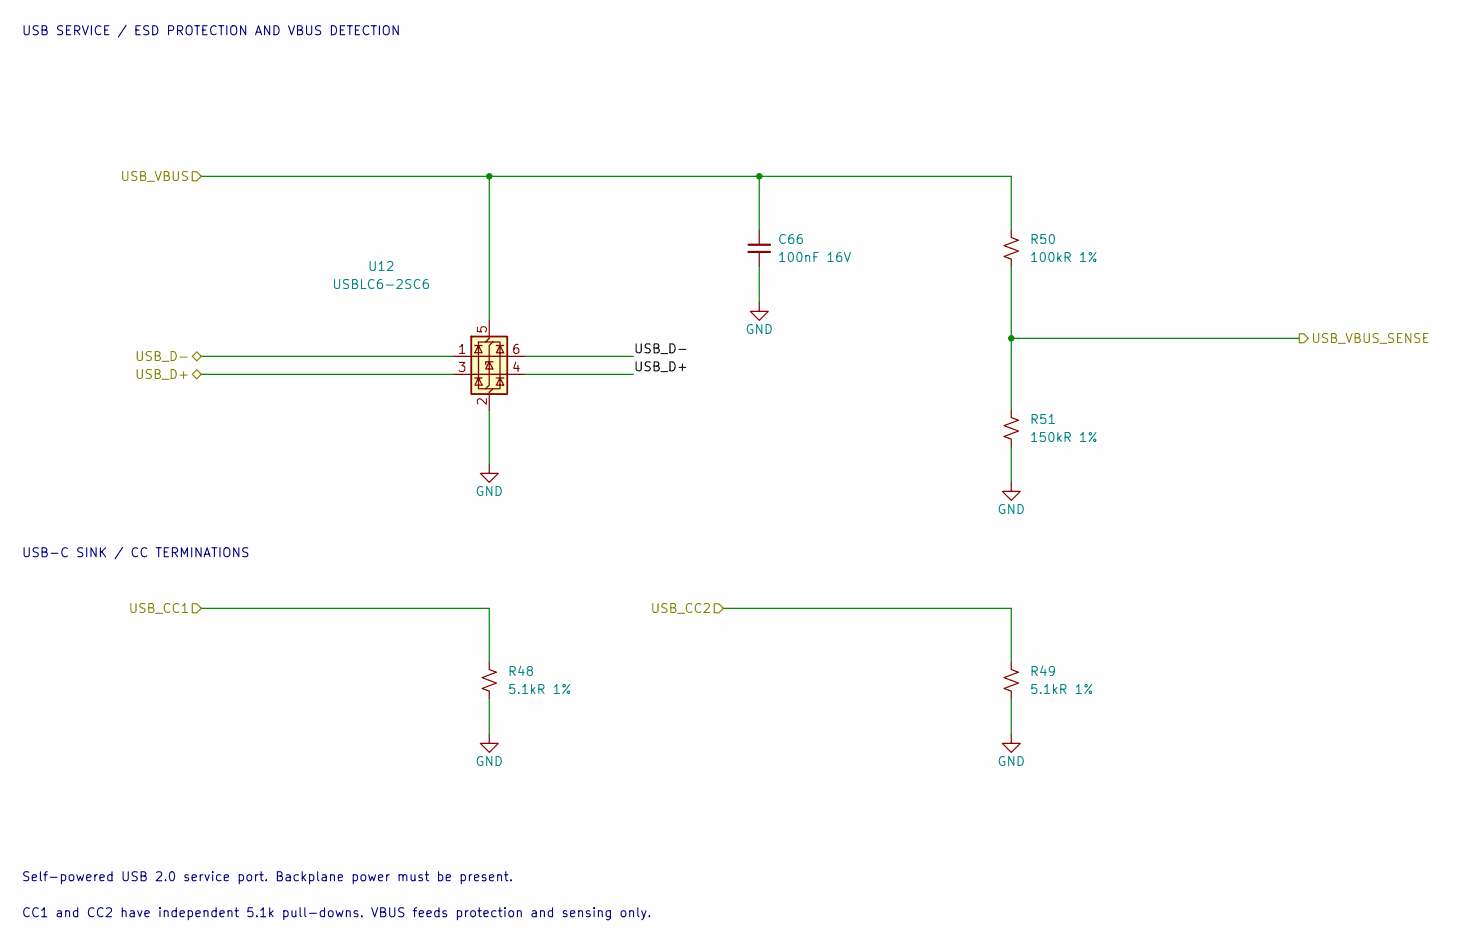
[picture p52: schematic USBInterface.kicad_sch, USB service interface]

Parts:
C66: 100nF 16V; C_0402_1005Metric; MPN CL05B104KO5NNNC; LCSC C1525
R48, R49: 5.1kR 1%; R_0603_1608Metric; MPN 0603WAF5101T5E; LCSC C23186
R50: 100kR 1%; R_0603_1608Metric; MPN 0603WAF1003T5E; LCSC C25803
R51: 150kR 1%; R_0603_1608Metric; MPN 0603WAF1503T5E; LCSC C22807
U12: USBLC6-2SC6; SOT-23-6; MPN USBLC6-2SC6; LCSC C7519

Connections:
/USB_CC1: R48.1; also elsewhere on the board
/USB_CC2: R49.1; also elsewhere on the board
/USB_D+: U12.3 (I/O2), U12.4 (I/O2); also elsewhere on the board
/USB_D-: U12.1 (I/O1), U12.6 (I/O1); also elsewhere on the board
/USB_VBUS: C66.1, R50.1, U12.5 (VBUS); also elsewhere on the board
/USB_VBUS_SENSE: R50.2, R51.1; also elsewhere on the board
GND: C66.2, R48.2, R49.2, R51.2, U12.2 (GND); also elsewhere on the board

Notes on the sheet:
USB SERVICE / ESD PROTECTION AND VBUS DETECTION
USB-C SINK / CC TERMINATIONS
Self-powered USB 2.0 service port. Backplane power must be present.
CC1 and CC2 have independent 5.1k pull-downs. VBUS feeds protection and sensing only.

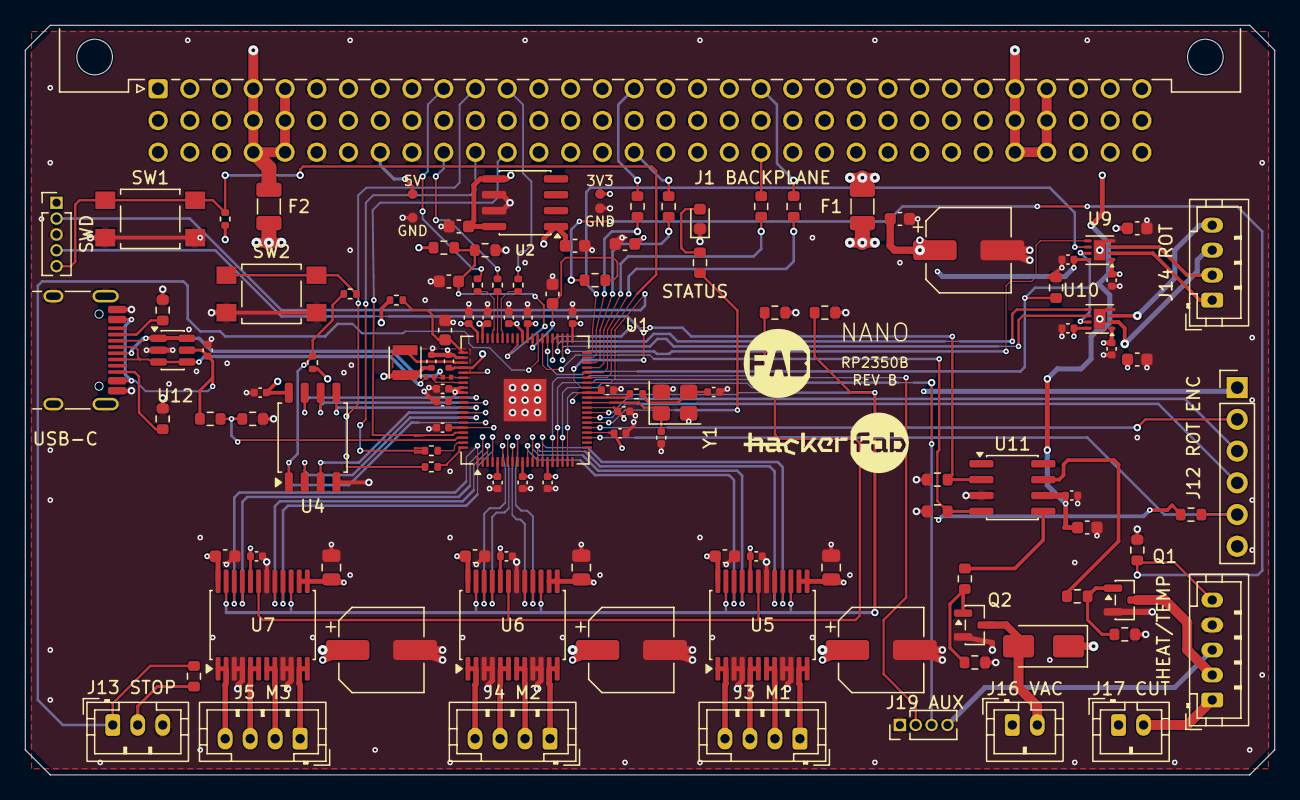
[picture p53: board FabNanoDaughterboard.kicad_pcb from above]

Board: 4 copper layers, 100.0 x 60.0 mm, 121 parts (0 on the bottom side), 105 nets.
