jonahsaunders/fab-computer-hackerfab/daughterboards/micromanipulator/hardware/encoder-backplane/EncoderBackplane.kicad_pcb

## KiCad design daughterboards/micromanipulator/hardware/encoder-backplane/EncoderBackplane.kicad_pcb (2026-11-08)

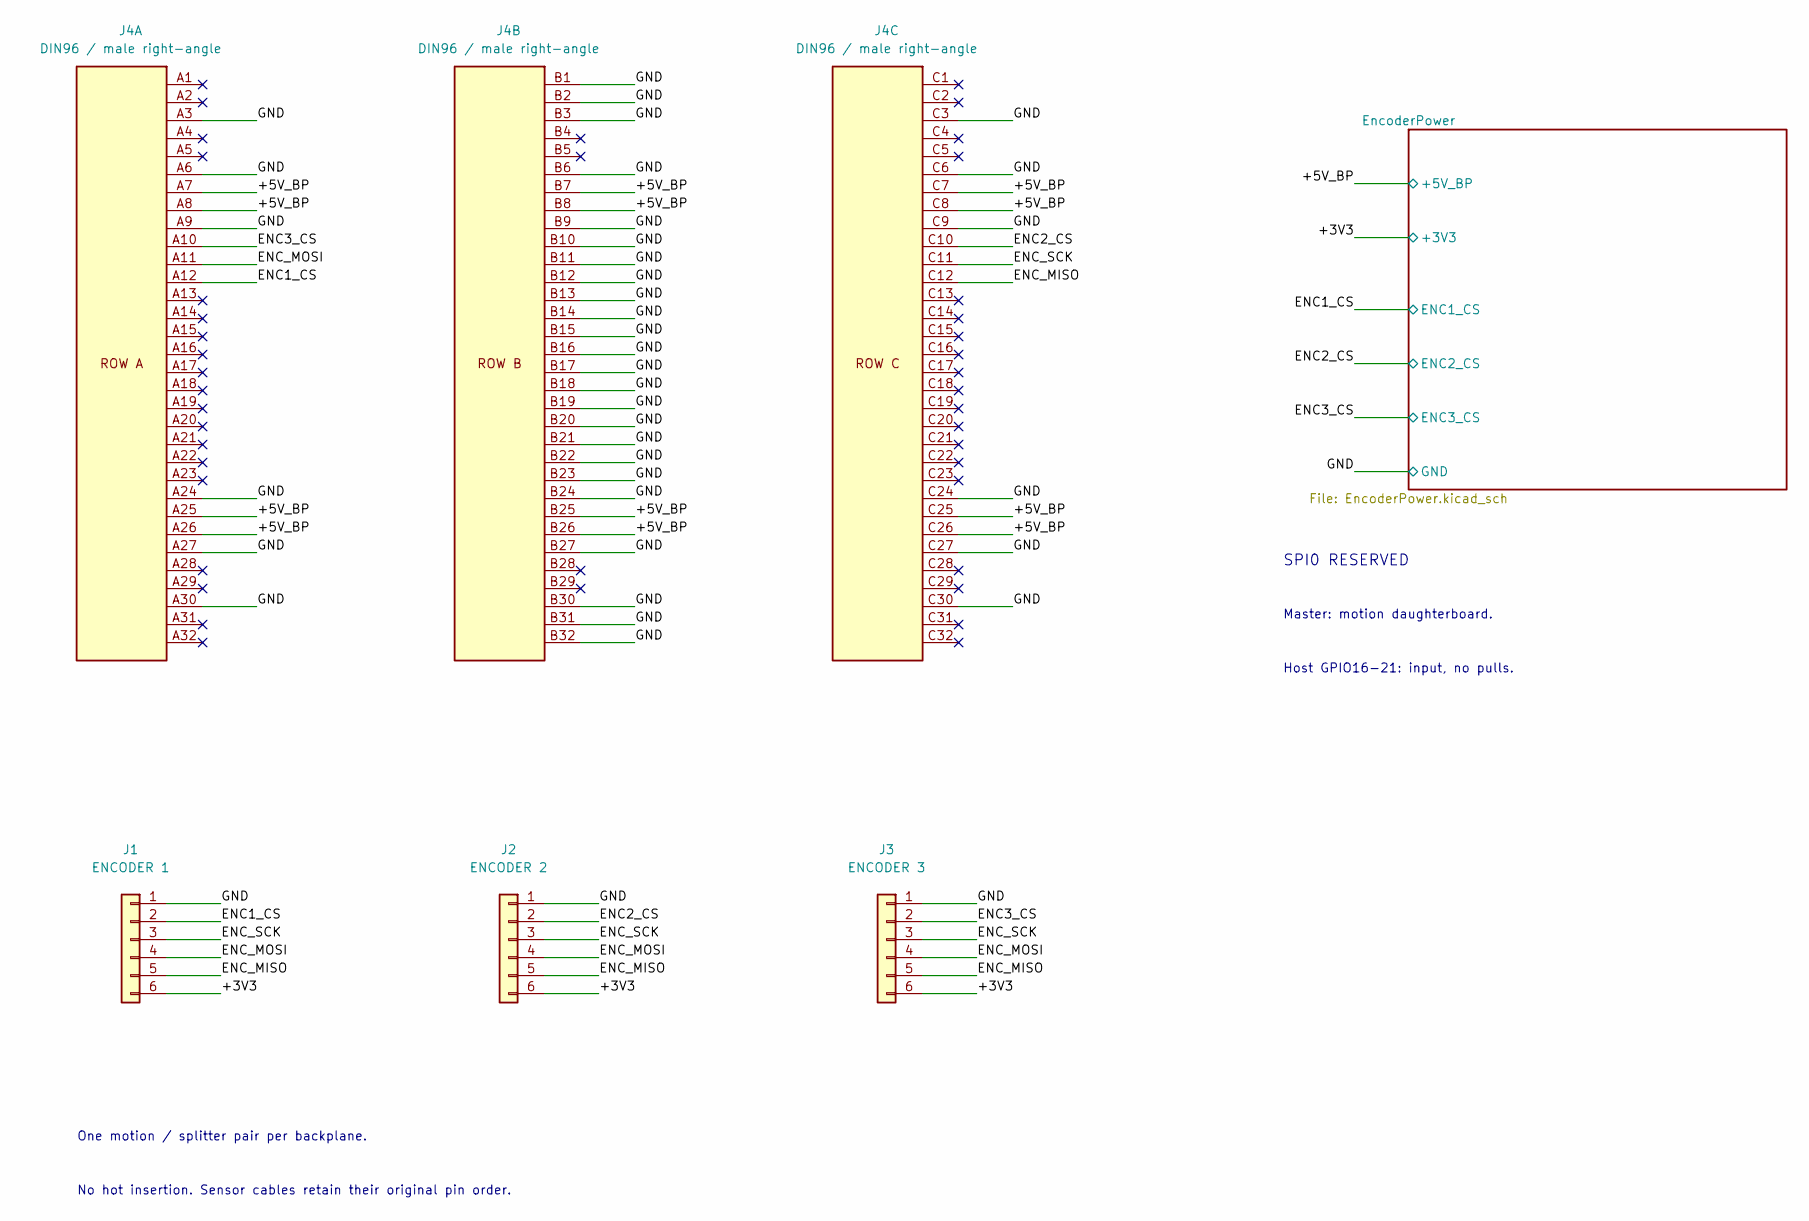
[picture p54: schematic EncoderBackplane.kicad_sch, FAB Encoder / SPI0 backplane splitter]

Parts:
J1: ENCODER 1; JST_PH_B6B-PH-K_1x06_P2.00mm_Vertical; MPN B6B-PH-K-S(LF)(SN); LCSC C131342
J2: ENCODER 2; JST_PH_B6B-PH-K_1x06_P2.00mm_Vertical; MPN B6B-PH-K-S(LF)(SN); LCSC C131342
J3: ENCODER 3; JST_PH_B6B-PH-K_1x06_P2.00mm_Vertical; MPN B6B-PH-K-S(LF)(SN); LCSC C131342
J4: DIN96 / male right-angle; DIN96_Male_Horizontal; MPN 9001-11961C00A; LCSC C5173361

Connections:
+3V3: J1.6, J2.6, J3.6; also elsewhere on the board
+5V_BP: J4.A7, J4.A8, J4.A25, J4.A26, J4.B7, J4.B8, J4.B25, J4.B26, J4.C7, J4.C8, J4.C25, J4.C26; also elsewhere on the board
/ENC1_CS: J1.2, J4.A12; also elsewhere on the board
/ENC2_CS: J2.2, J4.C10; also elsewhere on the board
/ENC3_CS: J3.2, J4.A10; also elsewhere on the board
/ENC_MISO: J1.5, J2.5, J3.5, J4.C12
/ENC_MOSI: J1.4, J2.4, J3.4, J4.A11
/ENC_SCK: J1.3, J2.3, J3.3, J4.C11
GND: J1.1, J2.1, J3.1, J4.A3, J4.A6, J4.A9, J4.A24, J4.A27, J4.A30, J4.B1, J4.B2, J4.B3, J4.B6, J4.B9, J4.B10, J4.B11, J4.B12, J4.B13, J4.B14, J4.B15, J4.B16, J4.B17, J4.B18, J4.B19, J4.B20, J4.B21, J4.B22, J4.B23, J4.B24, J4.B27, J4.B30, J4.B31, J4.B32, J4.C3, J4.C6, J4.C9, J4.C24, J4.C27, J4.C30; also elsewhere on the board

Notes on the sheet:
SPI0 RESERVED
Master: motion daughterboard.
Host GPIO16-21: input, no pulls.
One motion / splitter pair per backplane.
No hot insertion. Sensor cables retain their original pin order.

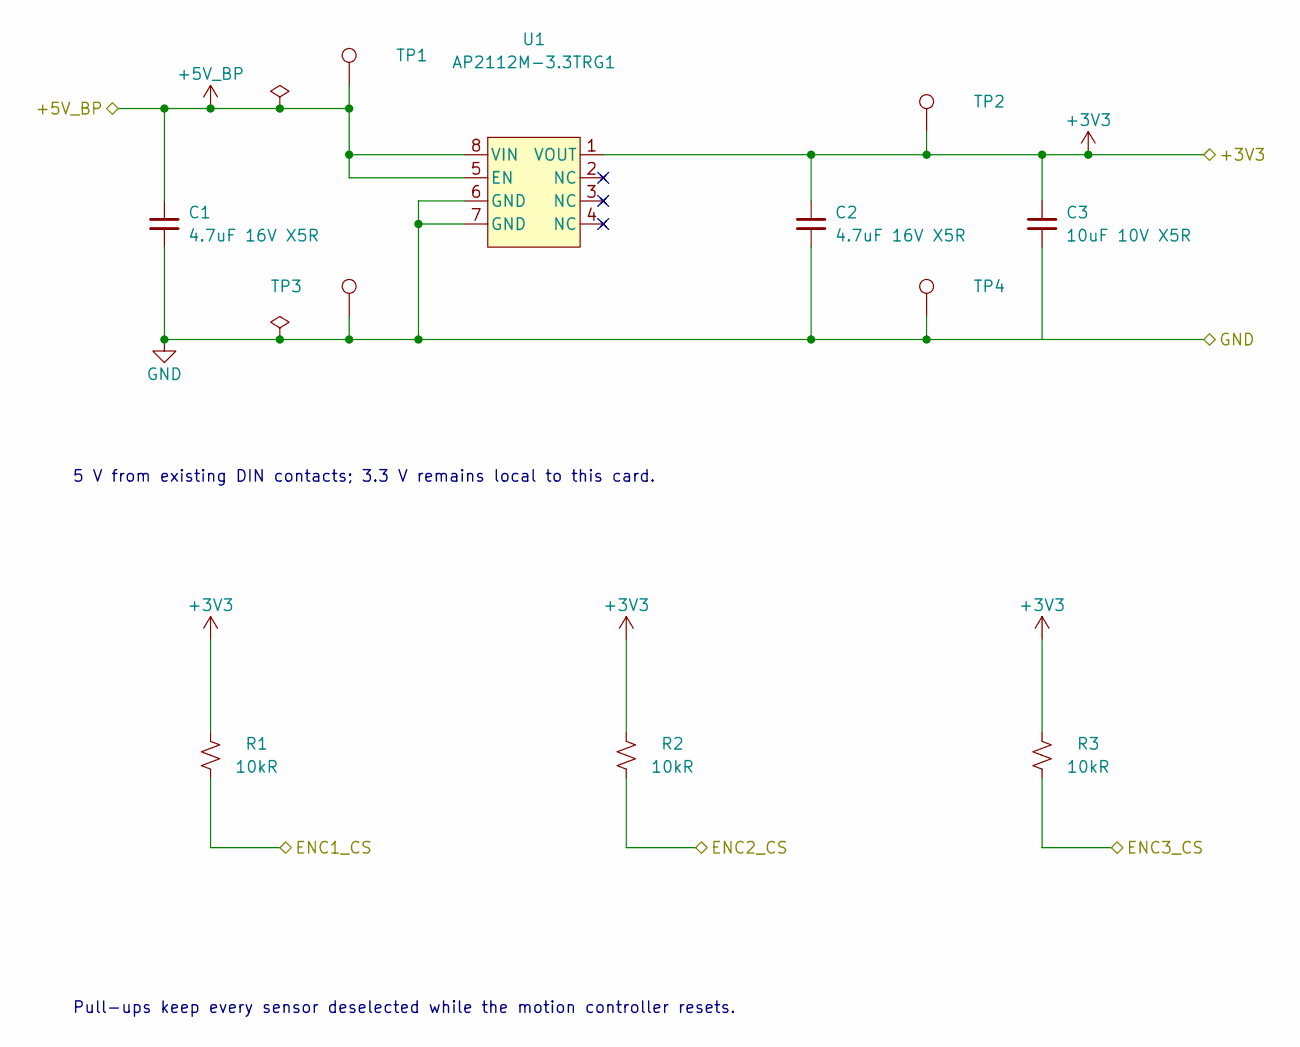
[picture p55: schematic EncoderPower.kicad_sch, Encoder supply / startup chip selects]

Parts:
C1, C2: 4.7uF 16V X5R; C_0603_1608Metric; MPN CL10A475KO8NNNC; LCSC C19666
C3: 10uF 10V X5R; C_0603_1608Metric; MPN CL10A106KP8NNNC; LCSC C19702
R1, R2, R3: 10kR; R_0603_1608Metric; MPN 0603WAF1002T5E; LCSC C25804
TP1: 5V; TestPoint_Pad_D0.8mm
TP2: 3V3; TestPoint_Pad_D0.8mm
TP3, TP4: GND; TestPoint_Pad_D0.8mm
U1: AP2112M-3.3TRG1; SOIC-8_3.9x4.9mm_P1.27mm; MPN AP2112M-3.3TRG1; LCSC C5290219

Connections:
+3V3: C2.1, C3.1, R1.2, R2.2, R3.2, TP2.1, U1.1 (VOUT); also elsewhere on the board
+5V_BP: C1.1, TP1.1, U1.5 (EN), U1.8 (VIN); also elsewhere on the board
/ENC1_CS: R1.1; also elsewhere on the board
/ENC2_CS: R2.1; also elsewhere on the board
/ENC3_CS: R3.1; also elsewhere on the board
GND: C1.2, C2.2, C3.2, TP3.1, TP4.1, U1.6 (GND), U1.7 (GND); also elsewhere on the board

Notes on the sheet:
5 V from existing DIN contacts; 3.3 V remains local to this card.
Pull-ups keep every sensor deselected while the motion controller resets.

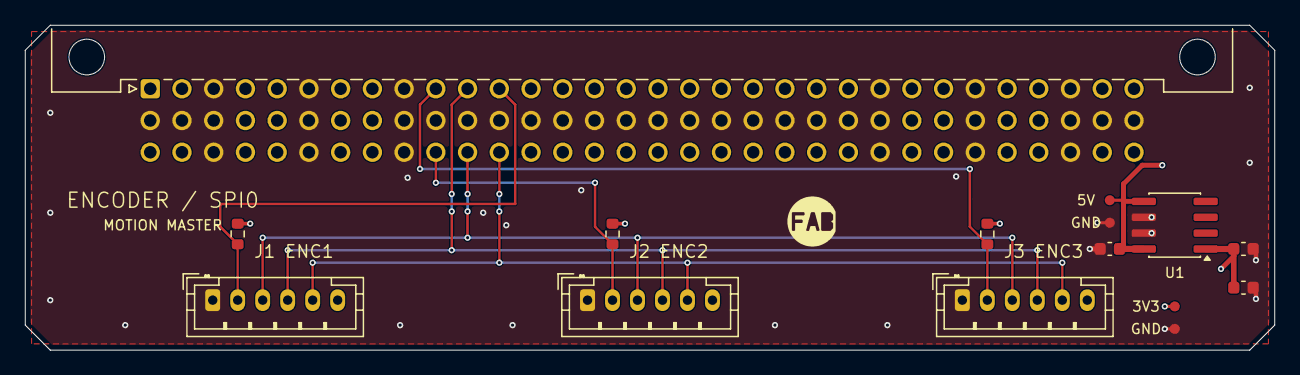
[picture p56: board EncoderBackplane.kicad_pcb from above]

Board: 4 copper layers, 100.0 x 26.0 mm, 15 parts (0 on the bottom side), 9 nets.
