jonahsaunders/fab-computer-hackerfab/daughterboards/micromanipulator/hardware/encoder-splitter/EncoderBoard.kicad_pcb

## KiCad design daughterboards/micromanipulator/hardware/encoder-splitter/EncoderBoard.kicad_pcb (2026-11-08)

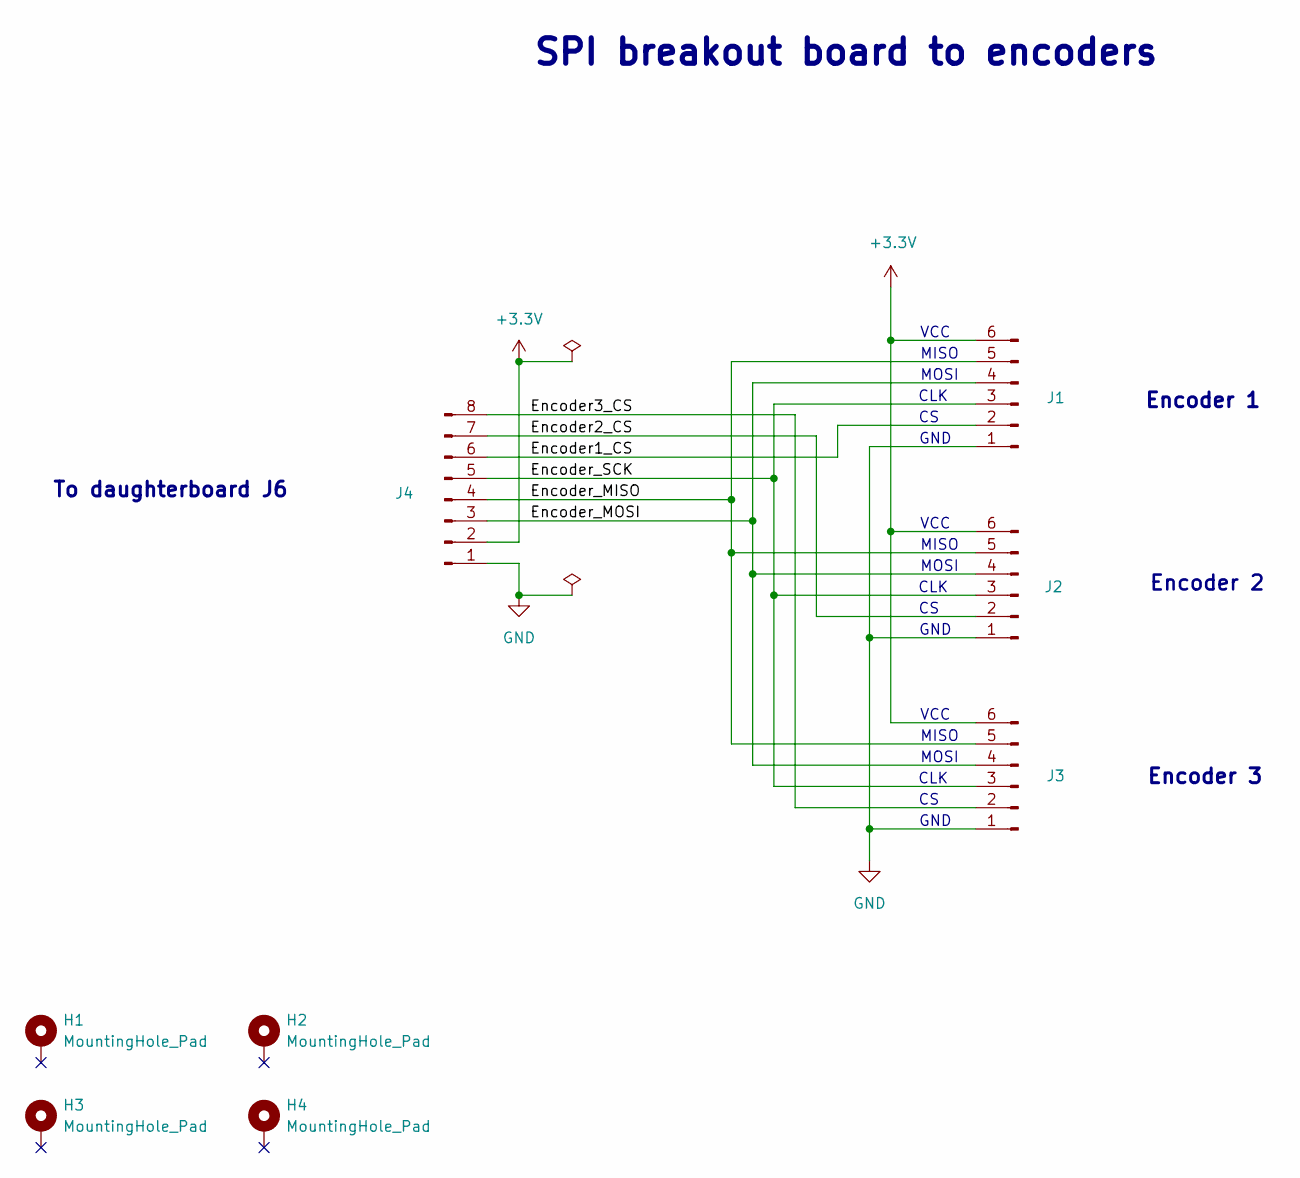
[picture p57: schematic EncoderBoard.kicad_sch]

Parts:
H1, H2, H3, H4: MountingHole_Pad; MountingHole_2.7mm_M2.5_Pad_Via
J1, J2, J3: Conn_01x06_Pin; JST_PH_B6B-PH-K_1x06_P2.00mm_Vertical
J4: Conn_01x08_Pin; JST_PH_B8B-PH-K_1x08_P2.00mm_Vertical

Connections:
+3.3V: J1.6, J2.6, J3.6, J4.2
/Encoder1_CS: J1.2, J4.6
/Encoder2_CS: J2.2, J4.7
/Encoder3_CS: J3.2, J4.8
/Encoder_MISO: J1.5, J2.5, J3.5, J4.4
/Encoder_MOSI: J1.4, J2.4, J3.4, J4.3
/Encoder_SCK: J1.3, J2.3, J3.3, J4.5
GND: J1.1, J2.1, J3.1, J4.1

Notes on the sheet:
VCC
Encoder 2
CLK
MISO
To daughterboard J6
MOSI
Encoder 3
SPI breakout board to encoders
GND
Encoder 1

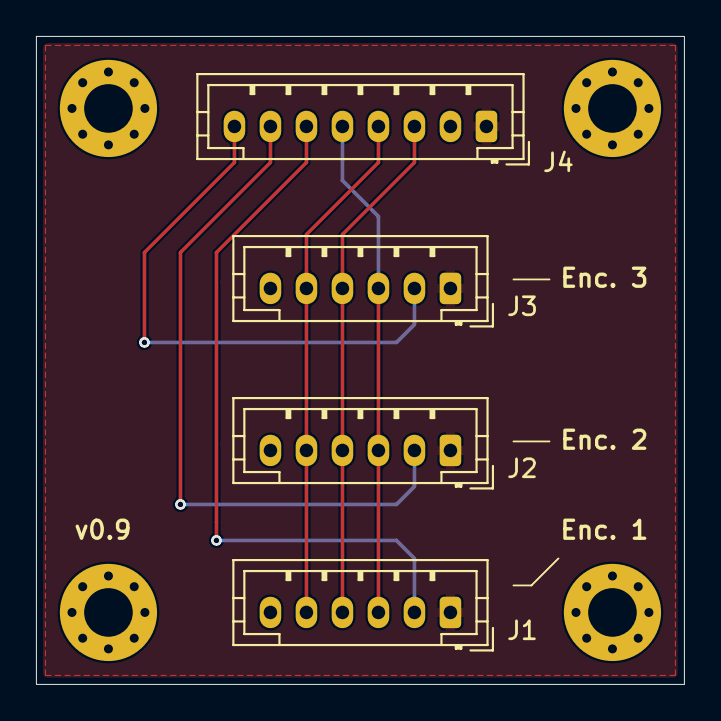
[picture p58: board EncoderBoard.kicad_pcb from above]

Board: 2 copper layers, 36.0 x 36.0 mm, 8 parts (0 on the bottom side), 8 nets.
