jonahsaunders/fab-computer-hackerfab/daughterboards/micromanipulator/firmware/board_config.h

#pragma once
// Pin constants for this board revision. This is not a complete firmware port.
#define FAB_ENC_MISO_PIN 0
#define FAB_ENC_SCK_PIN 2
#define FAB_ENC_MOSI_PIN 3
#define FAB_ENC1_CS_PIN 44
#define FAB_ENC2_CS_PIN 45
#define FAB_ENC3_CS_PIN 46
#define FAB_ENCODER_SPI_INSTANCE 0
#define FAB_ENCODER_BRINGUP_HZ 1000000u
