jonahsaunders/fab-computer-hackerfab/(commit log)

2026-10-21 Organize FAB Computer hardware with portable KiCad libraries and documentation
    [12V_Buck.kicad_sch, 3V3_LDO.kicad_sch, 5V_Buck.kicad_sch, HackerfabBackplane.kicad_pcb, HackerfabBackplane.kicad_sch, Microcontroller.kicad_sch, USB_Voltage_MUX.kicad_sch]
2026-10-26 Update backplane and libraries from October 26 archives
    [HackerfabBackplane.kicad_sch, Protection.kicad_sch]
2026-10-26 Update backplane design and previews
    [12V_Buck.kicad_sch, 5V_Buck.kicad_sch, HackerfabBackplane.kicad_pcb, Microcontroller.kicad_sch]
2026-10-26 Use a fresh filename for updated board preview
2026-10-29 Update backplane and libraries from October 29 archives
    Import the supplied active KiCad sources, retain portable library tables, and omit local editor state. Refresh schematic and board previews, archive fingerprints, and validation notes for the partially routed 144-component design.
    [HackerfabBackplane.kicad_pcb, HackerfabBackplane.kicad_sch, Microcontroller.kicad_sch]
2026-10-29 Arrange connector signals around the MCU jumper banks
    Keep each protocol paired across A/C columns and UART RX/TX together. Update schematic and PCB signal assignments, add pin tables and a top-layer passage guide, and verify fixed power/ground, signal inventory, source jumpers, and KiCad parity.
    [HackerfabBackplane.kicad_pcb, HackerfabBackplane.kicad_sch, connector-pinout.csv]
2026-10-30 Import October 30 V6 schematic and routing updates
    [HackerfabBackplane.kicad_pcb, HackerfabBackplane.kicad_sch, connector-pinout.csv]
2026-11-01 Import November 1 backplane routing update
    [HackerfabBackplane.kicad_pcb]
2026-11-01 Import updated backplane layout and custom design rules
    Import the later November 1 archives, preserving all 41 active source files after line-ending normalization and retaining portable library tables. Refresh previews and document ERC/DRC results, including four unconnected GND items.
    [HackerfabBackplane.kicad_pcb]
2026-11-01 Import mounting-hole update and diagnose thermal reliefs
    Preserve the latest 41 archive sources, refresh previews and validation, and document the 11 remaining thermal-relief findings with copper details and temporary-copy experiments. The imported PCB has zero unconnected items.
    [HackerfabBackplane.kicad_pcb]
2026-11-02 Import November 2 backplane update
    Import the supplied PCB and project settings while preserving portable libraries and exact normalized source contents. Refresh design previews, archive fingerprints, and validation notes.
    Validated with KiCad 10.0.6: 352 DRC warnings, no DRC errors, no unconnected items, no schematic/PCB parity findings, and 16 ERC findings. All 288 connector pins match V6 and the schematic netlist. Repository checks pass.
    [HackerfabBackplane.kicad_pcb]
2026-11-02 Import updated backplane routing and vias from November 2 archives
    [HackerfabBackplane.kicad_pcb]
2026-11-02 Import RP2350B backplane and library updates from supplied archives
    [12V_Buck.kicad_sch, 5V_Buck.kicad_sch, HackerfabBackplane.kicad_pcb, Microcontroller.kicad_sch]
2026-11-04 Import November 4 backplane and audit electrical design
    Add the supplied J2 UART routing and preserve portable libraries. Refill stale copper, correct the UART legend and RP2350B flash metadata, and record electrical findings with reproducible ERC/DRC evidence. Update pinout checks, regression cases, previews, and current documentation.
    [HackerfabBackplane.kicad_pcb, HackerfabBackplane.kicad_sch, Microcontroller.kicad_sch, connector-pinout.csv]
2026-11-04 Remove published audit and restore supplied design files
    Restore the PCB, schematic metadata, and chip library exactly to the supplied archives. Remove the audit report, audit snapshots, and added regression workflow. Refresh previews and import notes to reflect the unchanged supplied design.
    [HackerfabBackplane.kicad_pcb, Microcontroller.kicad_sch]
2026-11-05 Import November 5 backplane and library archives
    [HackerfabBackplane.kicad_pcb, HackerfabBackplane.kicad_sch, Microcontroller.kicad_sch, connector-pinout.csv]
2026-11-05 Sync supplied November 5 PCB silkscreen and refresh preview
    [HackerfabBackplane.kicad_pcb]
2026-11-05 Restore board preview with 3D component models
2026-11-07 Add micromanipulator daughterboard schematic and in-progress layout
    [FabNanoDaughterboard.kicad_pcb, FabNanoDaughterboard.kicad_sch, MotionController.kicad_sch, MotionDrivers.kicad_sch, MotionGPIO.kicad_sch, Power.kicad_sch, ToolOutputs.kicad_sch, backplane-pinout.csv]
2026-11-07 Route motion controls, feedback, host interfaces and analog inputs
    [FabNanoDaughterboard.kicad_pcb]
2026-11-07 Connect bypass capacitors directly to supply pins and route flash
    [FabNanoDaughterboard.kicad_pcb, decoupling-paths.csv]
2026-11-07 Finish manual signal routing and improve bypass returns
    [FabNanoDaughterboard.kicad_pcb, decoupling-paths.csv, model-inventory.csv]
2026-11-07 Improve capacitor placement and ground returns across daughterboard
    [FabNanoDaughterboard.kicad_pcb, FabNanoDaughterboard.kicad_sch, MotionController.kicad_sch, MotionDrivers.kicad_sch, MotionGPIO.kicad_sch, Power.kicad_sch, ToolOutputs.kicad_sch, bom.csv]
2026-11-07 Replace USB-C envelope with aligned community STEP model
    [FabNanoDaughterboard.kicad_pcb, model-inventory.csv]
2026-11-07 Move USB support circuitry into a dedicated hierarchy sheet
    [FabNanoDaughterboard.kicad_pcb, FabNanoDaughterboard.kicad_sch, USBInterface.kicad_sch]
2026-11-07 Place USB termination at RP2350 and rebuild paired routing
    [FabNanoDaughterboard.kicad_pcb, MotionController.kicad_sch, USBInterface.kicad_sch, bom.csv, capacitor-returns.csv, decoupling-paths.csv, model-inventory.csv, usb-termination-paths.csv]
2026-11-07 Select daughterboard connectors and verify backplane pin allocation
    [FabNanoDaughterboard.kicad_pcb, FabNanoDaughterboard.kicad_sch, bom.csv]
2026-11-07 Select regulator bypass capacitors with DC bias allowance
    [FabNanoDaughterboard.kicad_pcb, MotionController.kicad_sch, Power.kicad_sch, bom.csv]
2026-11-07 Keep tool gate driver powered when load fuse opens
    [FabNanoDaughterboard.kicad_pcb, FabNanoDaughterboard.kicad_sch, ToolOutputs.kicad_sch]
2026-11-07 Specify tool driver and switch ordering codes with package review
    [FabNanoDaughterboard.kicad_pcb, ToolOutputs.kicad_sch, bom.csv]
2026-11-07 Select controller passives and correct Toshiba axis-driver package
    [FabNanoDaughterboard.kicad_pcb, MotionController.kicad_sch, MotionDrivers.kicad_sch, MotionGPIO.kicad_sch, Power.kicad_sch, ToolOutputs.kicad_sch, USBInterface.kicad_sch, bom.csv]
2026-11-07 Complete daughterboard parts, compact schematics and review host limits
    [FabNanoDaughterboard.kicad_pcb, MotionController.kicad_sch, MotionDrivers.kicad_sch, MotionGPIO.kicad_sch, Power.kicad_sch, ToolOutputs.kicad_sch, bom.csv, model-inventory.csv]
2026-11-07 Simplify right-side power routing and show populated backplane fit
    [FabNanoDaughterboard.kicad_pcb]
2026-11-08 Add small rail probes, connector legends and original SPI splitter
    [EncoderBoard.kicad_pcb, EncoderBoard.kicad_sch, FabNanoDaughterboard.kicad_pcb, Power.kicad_sch, capacitor-returns.csv]
2026-11-08 Add slot-mounted encoder card on motion-owned backplane SPI0
    [EncoderBackplane.kicad_pcb, EncoderBackplane.kicad_sch, EncoderPower.kicad_sch, FabNanoDaughterboard.kicad_pcb, FabNanoDaughterboard.kicad_sch, MotionController.kicad_sch, MotionGPIO.kicad_sch, backplane-pinout.csv]
2026-11-08 Simplify USB-C routing and add a local ground reference
    [FabNanoDaughterboard.kicad_pcb, capacitor-returns.csv]
2026-11-08 Limit each USB connector path to two signal vias
    [FabNanoDaughterboard.kicad_pcb]
2026-11-09 Add wired FAB Computer enclosure and mechanical BOM
    Keep the board assembly on the front page and add a linked 4K enclosure render. Include the routed CAD assembly, eight print files, part links, and the enclosure build and fit notes.
    [mechanical-bom.csv]
2026-11-09 Add laser-cut enclosure and illustrated assembly guides
    Provide 1:1 DXF and SVG files, a wired STEP assembly, and linked hardware for the flat-panel build. Document both enclosure assembly sequences on the existing enclosure page.
    [laser-cut-bom.csv]
2026-11-09 Update RP2350 core regulator layout and passive library
    Import the validated backplane layout and controller sheet with the marked Abracon inductor and Murata regulator capacitors. Keep the embedded STEP models and include the Raspberry Pi R4 MIT notice.
    [HackerfabBackplane.kicad_pcb, Microcontroller.kicad_sch]
2026-11-09 Show the updated FAB backplane in the README
    Add a full-board render and a close-up of the Abracon L3 inductor from the revised KiCad board. Refresh the plug-in assembly views and use stable paths for the standalone previews.
2026-11-09 Show all three boards and the assembled stack in the README
2026-11-10 Update HackerFab backplane layout and renders
    Import the November 10 KiCad board and regenerate the board, plug-in assembly, and enclosure views. Record the updated board verification results.
    [HackerfabBackplane.kicad_pcb]
2026-11-12 Document JLCPCB manufacturing and component sourcing
    [BOM.csv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]
2026-11-12 Refresh board-by-board assembly stock and manual part selections
2026-11-12 Center backplane DIN96 sockets in the JLCPCB CPL
    [CPL.csv]
2026-11-12 Verify and correct backplane catalog part orientations
    [CPL.csv]
2026-11-12 Correct plug-in card placements and use 16 MiB Winbond flash
    [BOM.csv, FabNanoDaughterboard.kicad_pcb, MotionController.kicad_sch, bom.csv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]
