jonahsaunders/fab-computer-hackerfab/(notices)

Notices in the files:
parts and their libraries:
License: CC0-1.0
